JRL000/AQUABOTS/docs/AQUABOTS_PROJECT_SUMMARY.md

# AQUABOTS Project Summary — MOVED

The comprehensive project summary now lives at:

> [**`Claude/project-docs/AQUABOTS_PROJECT_SUMMARY.md`**](../Claude/project-docs/AQUABOTS_PROJECT_SUMMARY.md)

That file is the single source of truth for:

- Team structure and roles
- Communications architecture (IF-1 through IF-6) and current status
- Swarm firmware roadmap and module descriptions
- Power system configuration (production and demo)
- Sensor stack spec
- Updates since 02-25-2026 — swarm Steps 7–9 coded, IF-3 ESP32 side built, mission GUI deployed, JetPack 6.2 camera fix

This file was an older duplicate that had drifted out of date. Keeping only one copy so they can't diverge again.
