JRL000/AQUABOTS/docs/AQUABOTS ISR - COMMS SYSTEM.pptx

Communications System

Integration Status Review (ISR)

5/5

Comms Layers

Complete

✓

IF-6 (Drone↔Drone)

Verified

0%

Packet Loss

Complete

<5ms

RTT Latency

Complete

Notes: TALKING POINTS:
- Distributed swarm coordination for 20-50 autonomous surface drones
- ESP32-S3 with ESP-NOW protocol — zero-configuration networking
- All 5 communication layers complete and verified on hardware
- Interface IF-6 (drone-to-drone) fully verified — 0% packet loss, sub-5ms RTT
- Integration Phase 0 (interface specs) starting this week

TIME: 30 seconds

## Slide 2

Hardware Architecture & Status

ESP32-S3 Communication Hardware

ESP32-S3 Specifications

- MCU: Xtensa Dual-Core @ 240 MHz
- Radio: 2.4 GHz WiFi (ESP-NOW)
- Protocol: ESP-NOW (up to 250 kbps)
- Antenna: On-board PCB antenna
- Range: 30m+ indoor, 100m+ outdoor
- Power: 3.3V from distribution board
- UART: 0=Console, 1=Pixhawk, 2=Jetson

THE UNIVERSITY OF ARIZONA

Hardware Status

MCU selected & tested (ESP32-S3)

2-node communication verified

RSSI: -16 to -24 dBm at 1m

Multi-node setup (Phase 1, Wk 8)

Waterproof enclosure (Phase 3, Wk 12-13)

Timeline: Wk 8 → 3rd board + stub tests | Wk 10 → Pair tests | Wk 12 → Full system

AQUABOTS | ISR – Communications System

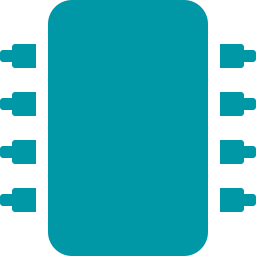
[picture p2: figure]
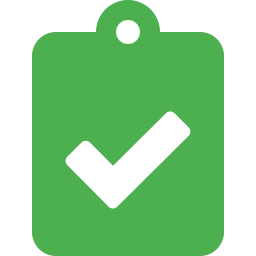
[picture p3: figure]
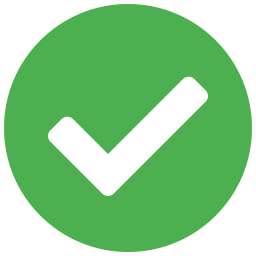
[picture p4: figure]
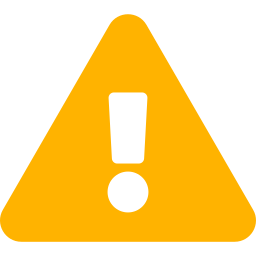
[picture p5: figure]
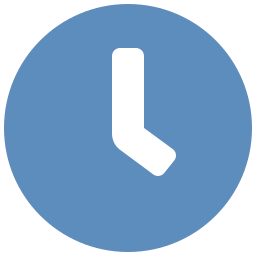
[picture p6: figure]

2

Notes: TALKING POINTS:
- ESP32-S3 selected for dual-core processing, built-in 2.4GHz WiFi
- ESP-NOW eliminates need for WiFi access point — direct peer-to-peer
- Currently verified on 2 development boards
- UART port allocation planned: UART0=console, UART1=Pixhawk (IF-1), UART2=Jetson (IF-3)
- 3rd dev board arriving Week 8 for multi-node and stub testing
- Waterproof enclosure integration during Phase 3 full system testing

TIME: 45 seconds

## Slide 3

Software Stack – Layers 1-5

All 5 communication layers complete and verified on hardware

GOTO, HOLD, STOP, RESUME — synchronized execution

Layer 5: Commands

Key Metrics

~2,350

Lines of Code

5 of 5

Modules

~10 KB

RAM Usage

~800 KB

Flash Usage

<5%

CPU Load

6 weeks

Dev Time

5

✓

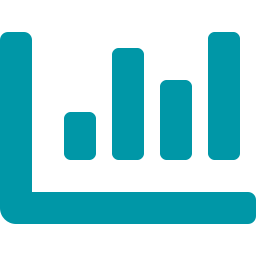
[picture p7: figure]

Leader election (highest ID) + TDMA scheduling (50ms slots)

4

Layer 4: Coordination

✓

HELLO/JOIN auto-discovery — 2-4 sec, 50-node capacity

3

Layer 3: Discovery

✓

NVS provisioning — persistent node IDs (1-254)

2

Layer 2: Identity

✓

ESP-NOW wrapper — 4-5ms RTT, 0% packet loss

1

Layer 1: Transport

✓

THE UNIVERSITY OF ARIZONA

AQUABOTS | ISR – Communications System

3

Notes: TALKING POINTS:
- All 5 communication layers complete — this is the full swarm comm stack
- Layer 1: ESP-NOW wrapper handles all radio communication
- Layer 2: Each drone gets a persistent unique ID via NVS flash
- Layer 3: Drones discover each other automatically — zero-config
- Layer 4: Highest ID drone becomes leader, generates TDMA schedule
- Layer 5: Leader distributes GOTO/HOLD/STOP/RESUME commands
- ~2,350 lines production-quality C code in ESP-IDF
- Very lightweight: <5% CPU, ~10KB RAM
- Note: These 5 layers implement IF-6 (drone↔drone) which is fully complete

TIME: 60 seconds

## Slide 4

SRVM Verification – Requirement 4.4.2

Inter-Drone Communication: PARTIAL PASS → Advancing to FULL PASS

Verification Method | Status | Evidence / Detail | Date
TEST | ✓ PASS | RTT <5ms | 0% loss | RSSI -16 to -24 dBm | Discovery <5s | Wk 6
DEMONSTRATION | ✓ PASS | 2-node swarm: auto-discovery, leader election, TDMA, cmd sync | Wk 6
ANALYSIS | ◐ In Progress | Scalability 2→50 nodes, traffic modeling, performance projections | Wk 9
INSPECTION | ○ Planned | Hardware inspection, antenna placement, enclosure RF check | Wk 12

- 4.1.2 Swarm Control — Demonstration: ✓ PASS (leader election, synchronized commands)
- 4.4.1 Autonomy & Control — Demonstration: ◐ PARTIAL (command execution OK, formation pending)
- 4.3.1 Survivability — Test: ✓ PASS (0% packet loss) | Analysis: Scheduled Wk 9

AQUABOTS | ISR – Communications System

Supporting Requirements

THE UNIVERSITY OF ARIZONA

4

Notes: TALKING POINTS:
- Requirement 4.4.2 currently at PARTIAL PASS, advancing to FULL PASS
- TEST: All metrics exceed requirements — RTT <5ms, 0% packet loss, excellent signal
- DEMONSTRATION: Full 2-node swarm demonstrated — discovery through command execution
- ANALYSIS: Scalability study scheduled during Spring Break buffer (Wk 9)
- INSPECTION: Hardware inspection during Phase 3 full system integration (Wk 12)
- Supporting requirements also on track

TIME: 60 seconds

## Slide 5

Live Demonstration

2-Node Swarm Communication — End-to-End Verification

Power On

Two ESP32-S3 boards powered up

Auto-Discovery

Nodes discover each other (2-4 sec)

Leader Election

Node 2 (highest ID) elected leader

1

2

3

TDMA Schedule

Leader generates 50ms time slots

4

Send Command

Leader sends: goto 100 200 90

5

Synchronized Exec

Both nodes receive & execute

6

Backup: Pre-recorded video + console screenshots available if live demo encounters issues

AQUABOTS | ISR – Communications System

THE UNIVERSITY OF ARIZONA

5

Notes: TALKING POINTS:
- Live demo: Watch two ESP32-S3 boards coordinate in real-time
- Power on → automatic discovery in 2-4 seconds
- Node 2 becomes leader (highest ID wins)
- Leader generates TDMA schedule — 50ms slots prevent collisions
- Leader sends GOTO command — both nodes receive and execute
- Console shows synchronized status on both boards
- Backup video ready if hardware has issues

TIME: 2 minutes for demo

## Slide 6

Software Integration Plan

5 Phases (0-4) — Integration-Maturity Model with Team Pairings

Phase 0: Interface Agreement

5 interface specs (IF-1 to IF-5); team sign-off by Feb 28

John's IF Ownership

- IF-1: Swarm ↔ Pixhawk (w/ Robert)
- IF-2: Sensors → ESP32 (w/ Jamie)
- IF-3: ESP32 ↔ Jetson (w/ Jamie)
- IF-5: GUI Cmds → Drone (w/ Mayra)
- IF-6: Drone ↔ Drone ✓ DONE

Wk 7

IN PROGRESS

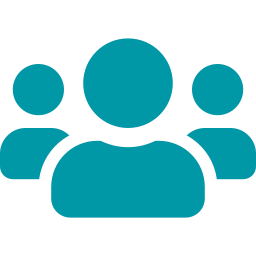
[picture p8: figure]

Phase 1: Pairwise Stub Testing

Each IF tested: one real side + one stub; Spring Break buffer Wk 9

Wk 8-9

Upcoming

Phase 2: Subsystem Pair Integration

Real HW connected in pairs — Swarm↔Pixhawk, Sensors↔ESP32, GUI↔Jetson

Wk 10-11

Planned

Phase 3: Full System Integration

All 4 subsystems running on complete drone; 2-drone swarm; E-STOP

Wk 12-13

Planned

Critical Path

IF-1: Swarm ↔ Pixhawk

- Two MCUs, two owners, real-time protocol
- Tested earliest; most schedule buffer
- MAVLink over UART — spec due Feb 26

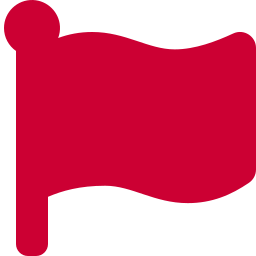
[picture p9: figure]

Phase 4: Pool Testing & Validation

Single-drone pool → multi-drone pool → full mission test

THE UNIVERSITY OF ARIZONA

Wk 14-15

Planned

AQUABOTS | ISR – Communications System

6

Notes: TALKING POINTS:
- Integration plan follows 5 phases (0-4) based on integration maturity, NOT subsystem breakdown
- Phase 0 (THIS WEEK): All 4 team members agree on interface specs — IF-1 through IF-5
- IF-6 (drone↔drone ESP-NOW) already complete and verified
- Phase 1 (Wk 8-9): Stub testing — each interface tested with one real side + one mock
- Spring Break (Wk 9) used as buffer
- Phase 2 (Wk 10-11): Real hardware pairs connected — Swarm↔Pixhawk is first (critical path)
- Phase 3 (Wk 12-13): Full system on complete drone, 2-drone swarm, E-STOP
- Phase 4 (Wk 14-15): Pool testing — single then multi-drone
- CRITICAL PATH: IF-1 (Swarm↔Pixhawk) — two MCUs, two team members, real-time MAVLink
- Must be tested earliest with most schedule buffer
- I own or co-own 5 of 6 interfaces (IF-1, 2, 3, 5, 6)

TIME: 60 seconds

## Slide 7

Testing & Validation Results

Verified Performance Metrics — Requirement 4.4.2

RTT Latency

4-5 ms

Req: <10 ms

Packet Loss

0%

Req: <5%

Signal Strength

-16 to -24 dBm

Req: >-70 dBm

Discovery Time

2-4 sec

Req: <5 sec

PASS

PASS

PASS

PASS

Test Case | Result | Detail
Auto-Discovery (2 nodes) | ✓ PASS | Both nodes discovered in 2-4 seconds
Leader Election | ✓ PASS | Highest node_id (Node 2) elected correctly
TDMA Scheduling | ✓ PASS | 50ms slots generated, beacon every 1s
Command Distribution | ✓ PASS | GOTO/HOLD/STOP/RESUME — <50ms latency
Leader Failover | ✓ PASS | Auto re-election in 5-7 sec after power-off
Thread Safety | ✓ PASS | Mutex protection, zero race conditions

AQUABOTS | ISR – Communications System

Functional Verification Results

THE UNIVERSITY OF ARIZONA

7

Notes: TALKING POINTS:
- All performance metrics EXCEED requirements
- RTT 4-5ms against <10ms plan requirement — well within threshold
- Packet loss is 0% — well below 5% requirement
- Signal strength -16 to -24 dBm — far exceeds -70 dBm minimum
- Discovery in 2-4 seconds — well under 5 second requirement
- All functional tests pass: discovery, election, scheduling, commands, failover
- Thread safety verified — no race conditions with mutex protection
- These metrics verified per Integration Plan Section 6.1

TIME: 45 seconds

## Slide 8

Master Integration Timeline

Integration Schedule and Key Milestones

Wk

Ph 0: IF Specs

NOW

7

8

BREAK

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
Ph 1: Stub Testing

Ph 2a: Swarm↔Pixhawk

Ph 2a: Sensors↔ESP32

Ph 2b: E2E Command

Ph 3a: Full Stack

Ph 3b: 2-Drone Swarm

Ph 4: Pool Testing

Finalize + Submit

In Progress

THE UNIVERSITY OF ARIZONA

John's Tasks

Critical Path (IF-1)

Pair/System Tests

AQUABOTS | ISR – Communications System

8

Notes: TALKING POINTS:
- Timeline matches Software Integration Plan Master Timeline (Section 10)
- Week 7 (NOW): Phase 0 — finalizing interface spec documents with all teammates
- IF1_SPEC.md (John+Robert), IF2_SPEC.md (Jamie+John), IF3_SPEC.md (John+Jamie)
- IF5_SPEC.md (Mayra+John) — team sign-off meeting Feb 28
- Week 8: Phase 1 — pairwise stub testing — each interface one real side + one stub
- Week 9: Spring Break — buffer for async catch-up
- Week 10: Phase 2a — CRITICAL: Swarm↔Pixhawk pair test (John+Robert)
- ESP32 goto → Pixhawk motor spins, rudder deflects, ACK received
- Week 11: Phase 2b — End-to-end command chain: GUI→MQTT→Jetson→ESP32→Pixhawk
- Weeks 12-13: Phase 3 — Full system on drone, then 2-drone swarm + E-STOP
- Weeks 14-15: Phase 4 — Pool testing (single then multi-drone)
- Weeks 16-17: Finalize documentation and submit

TIME: 45 seconds

## Slide 9

Next 30 / 60 / 90 Day Plan

Milestones, Deliverables, and Integration Targets Through May

30 Days

Feb 24 – Mar 27

- Wk 7: IF-1, IF-2, IF-3, IF-5 specs agreed
- Wk 7: Team sign-off meeting (Feb 28)
- Wk 8: ESP32 sends MAVLink GOTO/STOP (1.1)
- Wk 8: ESP32 reads sensor structs (1.4)
- Wk 8: ESP32↔Jetson serial packets (1.8)
- Wk 9: Spring Break buffer / catch-up
- Wk 10: Swarm↔Pixhawk pair test (2.1)
- Wk 10: Live sensor flow into ESP32 (2.2)
- Wk 11: E2E cmd: GUI→ESP32→Pixhawk (2.4)
- Wk 11: 2-drone swarm + Pixhawk (2.5)

THE UNIVERSITY OF ARIZONA

60 Days

Mar 27 – Apr 24

- Wk 12: Single-drone full stack (3.1)
- Wk 13: 2-drone swarm full system (3.2)
- Wk 13: Sensor readings during motion (3.3)
- Wk 13: E-STOP verified < 2 sec (3.4)
- Wk 13: Starlink loss → auto HOLD (3.5)
- Wk 14: Single-drone pool test (4.1)
- Wk 15: Multi-drone pool test (4.2)
- Wk 15: Full mission validation (4.3)

AQUABOTS | ISR – Communications System

90 Days

Apr 24 – May 7

- Wk 16: Manual & documentation
- Wk 16: Design Day preparation
- Wk 17: Final report submission
- Performance optimization
- Integration test reports finalized

10

Notes: TALKING POINTS:
- 30 Days: Focus on Phase 0-2 — interface specs, stub testing, pair integration
- THIS WEEK: All interface specs agreed — IF-1 through IF-5
- Week 8: Stub testing — ESP32 sends MAVLink, reads sensors, talks to Jetson
- Week 10: CRITICAL — Swarm↔Pixhawk pair test with Robert
- Week 11: End-to-end command chain verified
- 60 Days: Phase 3-4 — Full system and pool testing
- Single-drone full stack, then 2-drone swarm
- E-STOP verified, Starlink loss graceful degradation
- Pool testing: single then multi-drone missions
- 90 Days: Finalize — documentation, Design Day, final report
- Task numbers (e.g., 1.1, 2.1) reference Integration Plan directly

TIME: 45 seconds

## Slide 10

Risk Assessment & Mitigation

From Software Integration Plan — Risk Register (Section 8)

Risk | Prob | Impact | Mitigation | Owner
R1: MAVLink format mismatch ESP32↔Pixhawk | Med | High | Spec in Phase 0; logic analyzer in Phase 1 | John+Robert
R2: Starlink latency too high for control | Low | Med | Critical control via ESP-NOW; Starlink for telemetry | Mayra+John
R3: Sensor noise during motor vibration | Med | Med | Test during operation Phase 3; add filtering | Jamie
R5: UART port contention on ESP32 | Med | Med | UART0=console, 1=Pixhawk, 2=Jetson; verify early | John
R6: Spring Break schedule slip | High | Med | Front-load Phase 1 critical tasks to Week 8 | ALL
R7: Waterproofing failure | Med | High | Bench-test all integration before pool; conformal coat | ALL
R8: Pixhawk firmware incompatibility | Low | High | Verify firmware + MAVLink v2 in Phase 0 | Robert

Completed Mitigations

- IF-6 protocol reliability: 0% packet loss verified
- Auto-discovery, leader election, thread safety: all verified

THE UNIVERSITY OF ARIZONA

Highest Priority

- R1: MAVLink mismatch — spec due Feb 26
- R6: Spring Break — front-loading Week 8 work

AQUABOTS | ISR – Communications System

9

Notes: TALKING POINTS:
- Risks pulled directly from Software Integration Plan Section 8
- R1 (MAVLink mismatch) is highest priority — on critical path
- Mitigation: formal spec document due Feb 26, logic analyzer verification in Phase 1
- R5 (UART contention) is my responsibility — already planned allocation
- R6 (Spring Break slip) mitigated by front-loading Phase 1 tasks to Week 8
- IF-6 risks already mitigated — proven 0% packet loss, working auto-discovery
- R7 (waterproofing) — all integration bench-tested before going to pool

TIME: 45 seconds
