JRL000/AQUABOTS/docs/AQUABOTS CDR .pdf

# AQUABOTS Aeropak

# Critical Design Review

# Team 26061

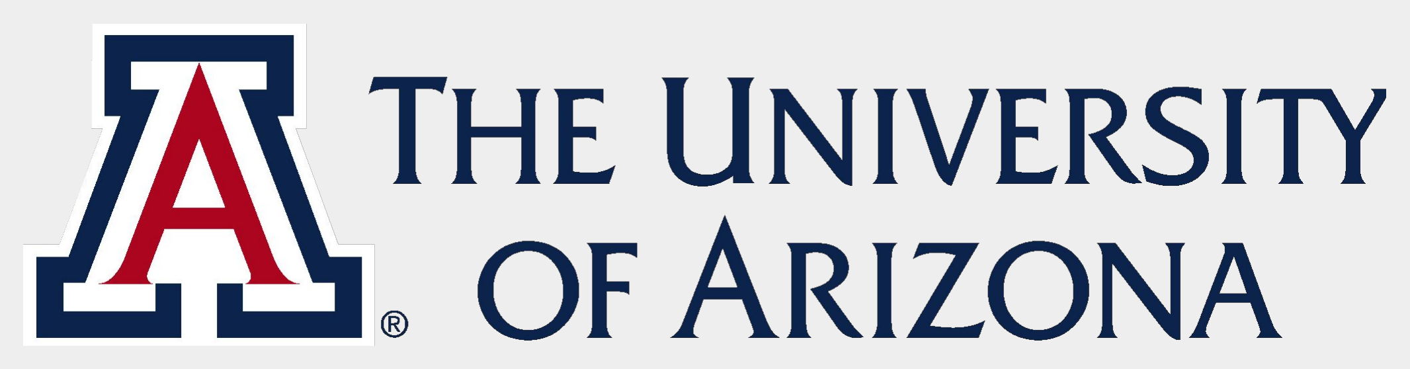
[picture p10: figure]

# Overview

### 1.0 Introduction

### 2.0 System Requirements

### 3.0 Point Design

### 4.0 Performance Analyses and

Expectations

### 5.0 Verification

### 6.0 Risk Analysis

### 7.0 Project Status and Plan

### 8.0 CDE 1

### 9.0 CDE 2

### 10.0 Cost Analysis and Deliverables

### 11.0 Summary

# Introduction

- Jamie Ledbetter, Biosystems Engineering – Team Lead
- Robert Wilkie, Aerospace Engineering – Procurement Lead
- Alex Imrich, Aerospace Engineering
- John Lopez, Electrical Engineering
- Mayra Mendoza, Optical Engineering
- Kama Henriques, Mechanical Engineering

# Our Team

# Project Summary

## What makes AQUABOT different?

- Rapid-response
- Short-term, targeted missions
- Swarm control capabilities
- Scalable

## Key Features:

- Mounted and fully functional sensor/camera suite
- Further developed communications
- Easy Integration with other water vessels

Sponsors: Dr. Marvin Slepian, Eddy Stocker

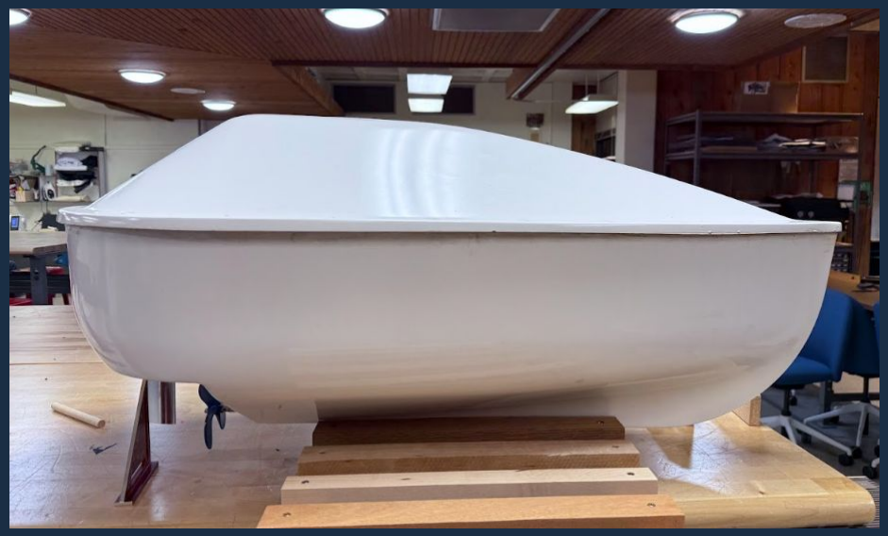
[picture p11: figure]

Image of AQUABOT Hull

## Application:

# Project Summary: OV-1

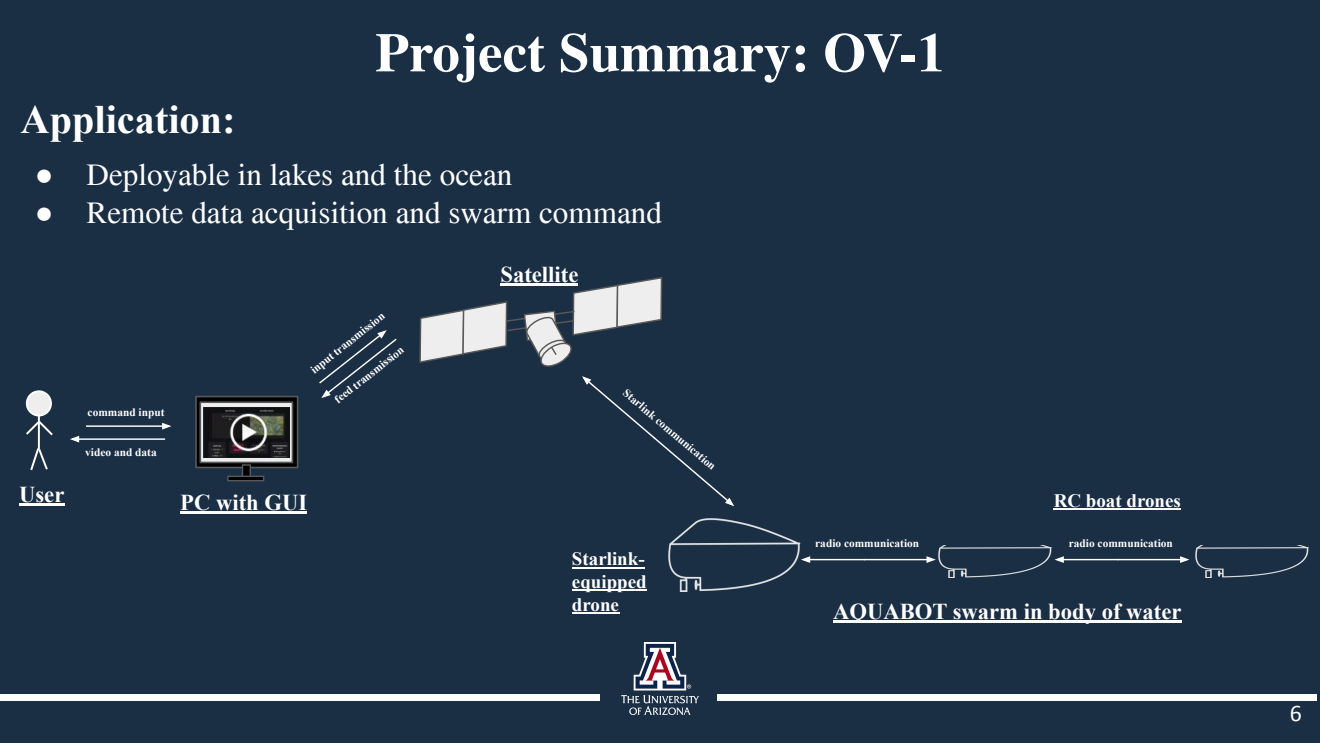
[picture p12: page 6]
User; command input; input transmission; feed transmission; Satellite; Starlink communication; radio communication; Starlink- equipped drone

● Deployable in lakes and the ocean
● Remote data acquisition and swarm command

video and data

PC with GUI

RC boat drones

AQUABOT swarm in body of water

# PDR Action Items

## Action Items

1. Add a system requirement for drone to drone
communication
2. Add a system requirement for swarm control
3. Update SBD
4. Generate a weight analysis
5. Define/resolve deployment system approach with your
sponsor

## Action Taken

1. Created Requirement 5.4.2 for inter-drone communication up to 100m
2. Created Requirement 5.4.6 for coordinated drone swarm behavior with a leader-follower model at < 1 s latency
3. Updates made to SBD:
a. Modification to reflect finalized motor and prop layout
b. Removal of in-drone E-stop and Master Switch
4. Weight Analysis conducted to find total drone mass of ~37 kg
5. Team negotiation and discussion with sponsors resulted in a change of focus from deployment system to swarm demonstration
All Action Items Closed

# Major Post-PDR Changes

- Deployment system is no longer within the scope of the project
- Shift of project focus to showcasing swarm behavior and control
- At least three drones must be deployed
- Requirements including speed, battery life, and internal volume have been altered

to include a threshold value and objective value

# System Requirements

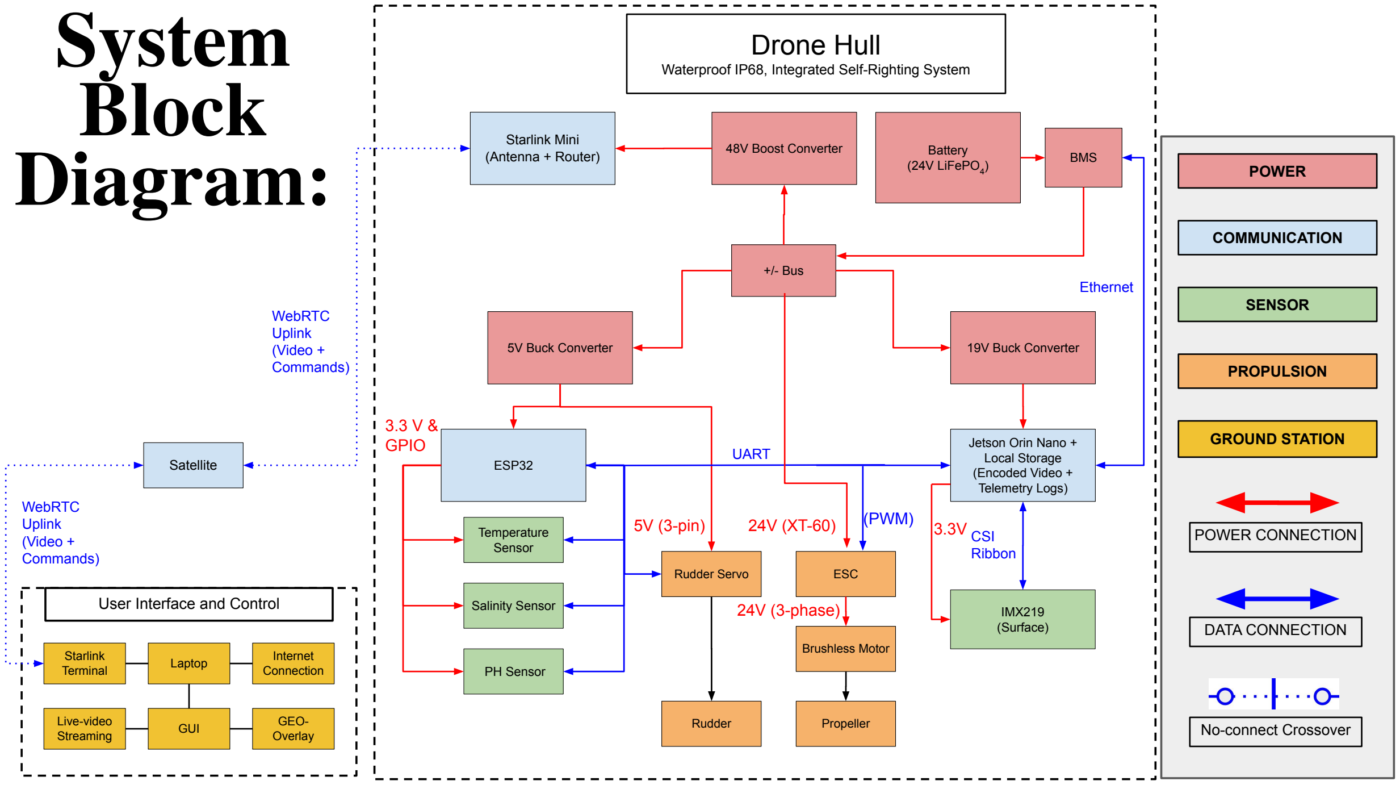
[picture p13: figure]
System Block Diagram:; Drone Hull; Waterproof IP68, Integrated Self-Righting System; PH Sensor; Salinity Sensor; Temperature Sensor; IMX219 (Surface); Jetson Orin Nano + Local Storage (Encoded Video + Telemetry Logs); Starlink Mini (Antenna + Router); Satellite; Brushless Motor; Propeller; ESC; Battery (24V LiFePO4 ); ESP32; +/- Bus; 5V Buck Converter; 19V Buck Converter; 48V Boost Converter; POWER; COMMUNICATION; SENSOR; PROPULSION; GROUND STATION; POWER CONNECTION; DATA CONNECTION; User Interface and Control; Laptop; GUI; Starlink Terminal; Internet Connection; Live-video Streaming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

# System

# Block

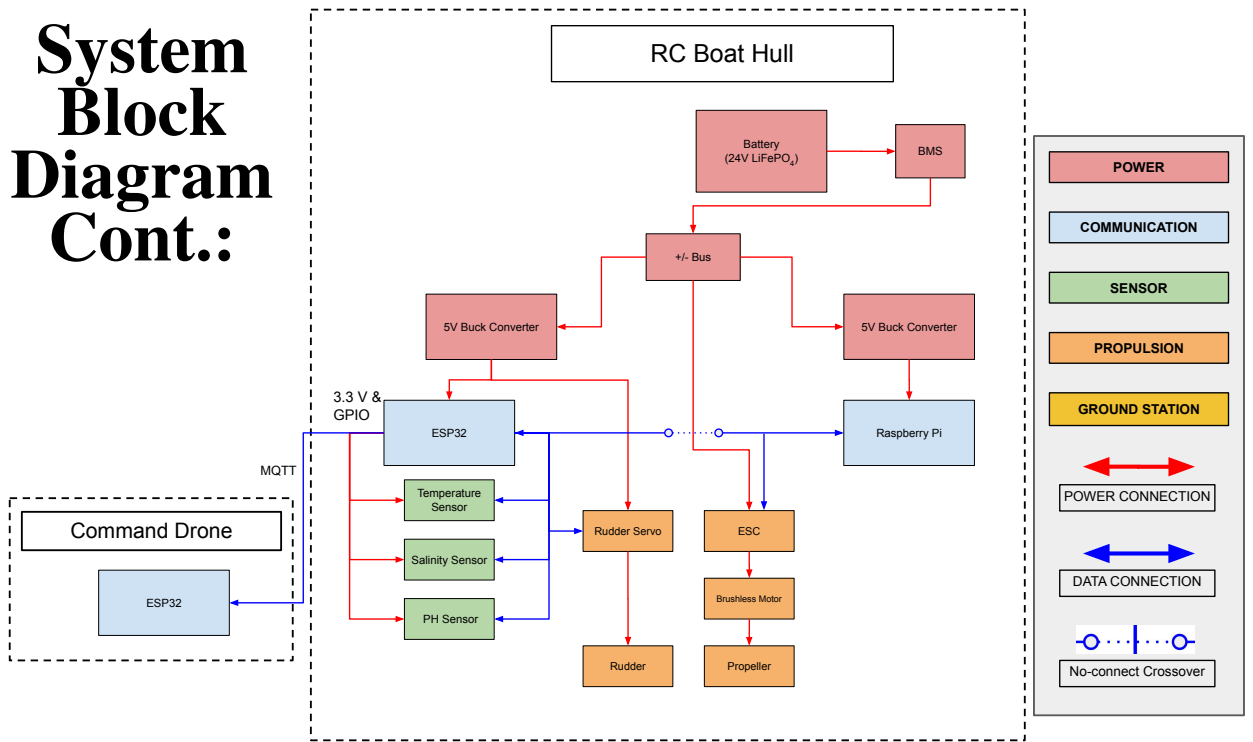
[picture p14: page 11]
Diagram Cont.:; PH Sensor; Salinity Sensor; Temperature Sensor; Brushless Motor; Propeller; ESC; Battery (24V LiFePO4 ); ESP32; +/- Bus; 5V Buck Converter; POWER; COMMUNICATION; SENSOR; PROPULSION; GROUND STATION; POWER CONNECTION; DATA CONNECTION; Rudder Servo; Rudder; No-connect Crossover; BMS; Command Drone; Raspberry Pi; MQTT; 3.3 V & GPIO

RC Boat Hull

# System Architecture

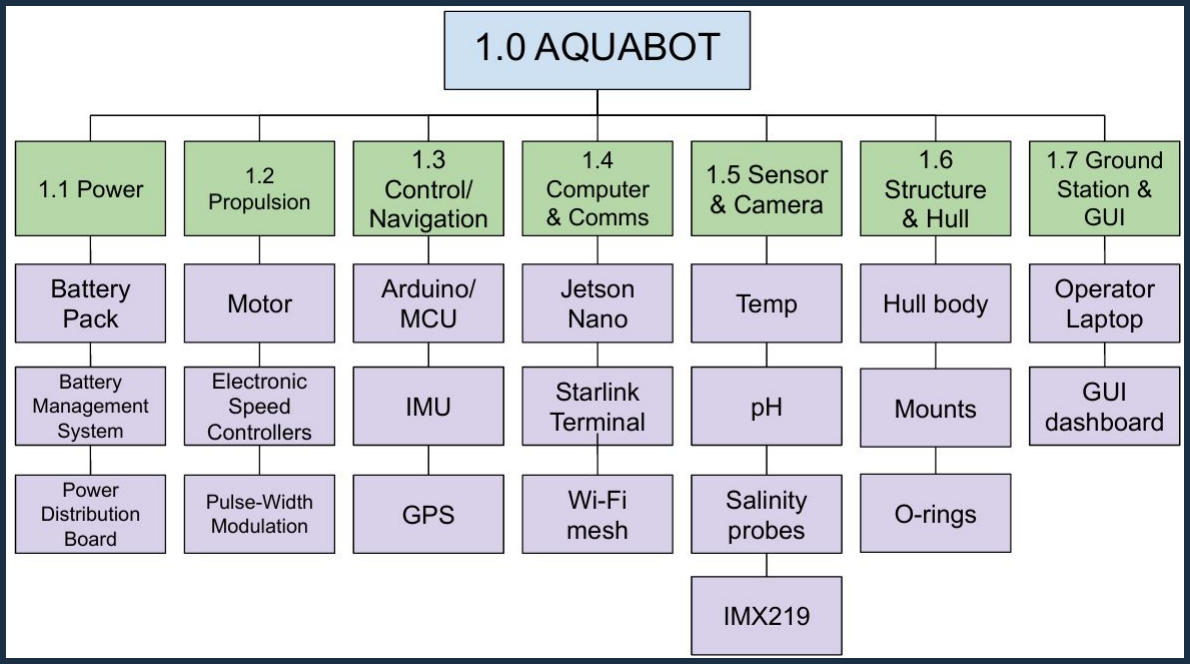
[picture p15: figure]

# Key Performance Requirements

- Swarm Deployment: All drones shall autonomously self-right and enter operational state within 60s of impact.
- Stability: Each drone shall self-right and maintain operational orientation IAW UNE-EN ISO 12217-3:2022 and/or ASTM F3052-14(2020)e1.
- Speed: Each drone shall be able to sustain a threshold speed of 2.5 kts in calm water conditions, with an objective speed of 5 kts.
- Battery Life: Each drone shall reach a threshold runtime of 6 minutes at nominal load, with an objective value of 5 hours.
- Data Collection: Each drone shall measure temperature, salinity, pH and capture visual imagery at a minimum of 1080p resolution, 30 fps.
- Data Mapping: Each drone shall generate a georeferenced map of collected environmental variables and export data in GIS-compatible format.

Requirement Type | Requirement | Verification Method
Test | Analysis | Demonstration | Inspection
| 4.1.2 Swarm Control | | | X
| 4.1.3 Stability | X | | X
| 4.1.4 Speed | X
| 4.1.5 Battery Life | X | X
| 4.1.6 Data Collection | X | | X
| 4.1.7 Data Mapping | | X
4.2 Design Requirements | 4.2.1 Hull Shape | | X
| 4.2.2 Internal Volume | | PASS | | PASS
| 4.2.3 Materials | | | | X
| 4.2.4 Payload Mounts | | | X | X

### 4.1 Performance

Requirements

# System Requirements Verification Matrix (SRVM)

Requirement Type | Requirement | Verification Method
Test | Analysis | Demonstration | Inspection
| 4.3.1 Survivability | X | X
| 4.3.2 Waterproofing | X | | | X
| 4.3.3 Operating temperature | X | X
| 4.3.4 Non-Hazardous Surface | | | | PASS
4.4 Interface Requirements | 4.4.1 Autonomy & Control | | | PARTIAL PASS
| 4.4.2 Inter-Drone Communication | PARTIAL PASS | | X
| 4.4.4 Satellite Uplink | PASS | | PASS
| 4.4.5 Display | | | PARTIAL PASS | PASS

### 4.3 Environmental

Requirement

SRVM Cont.

# Point Design

### Assembly Drawing

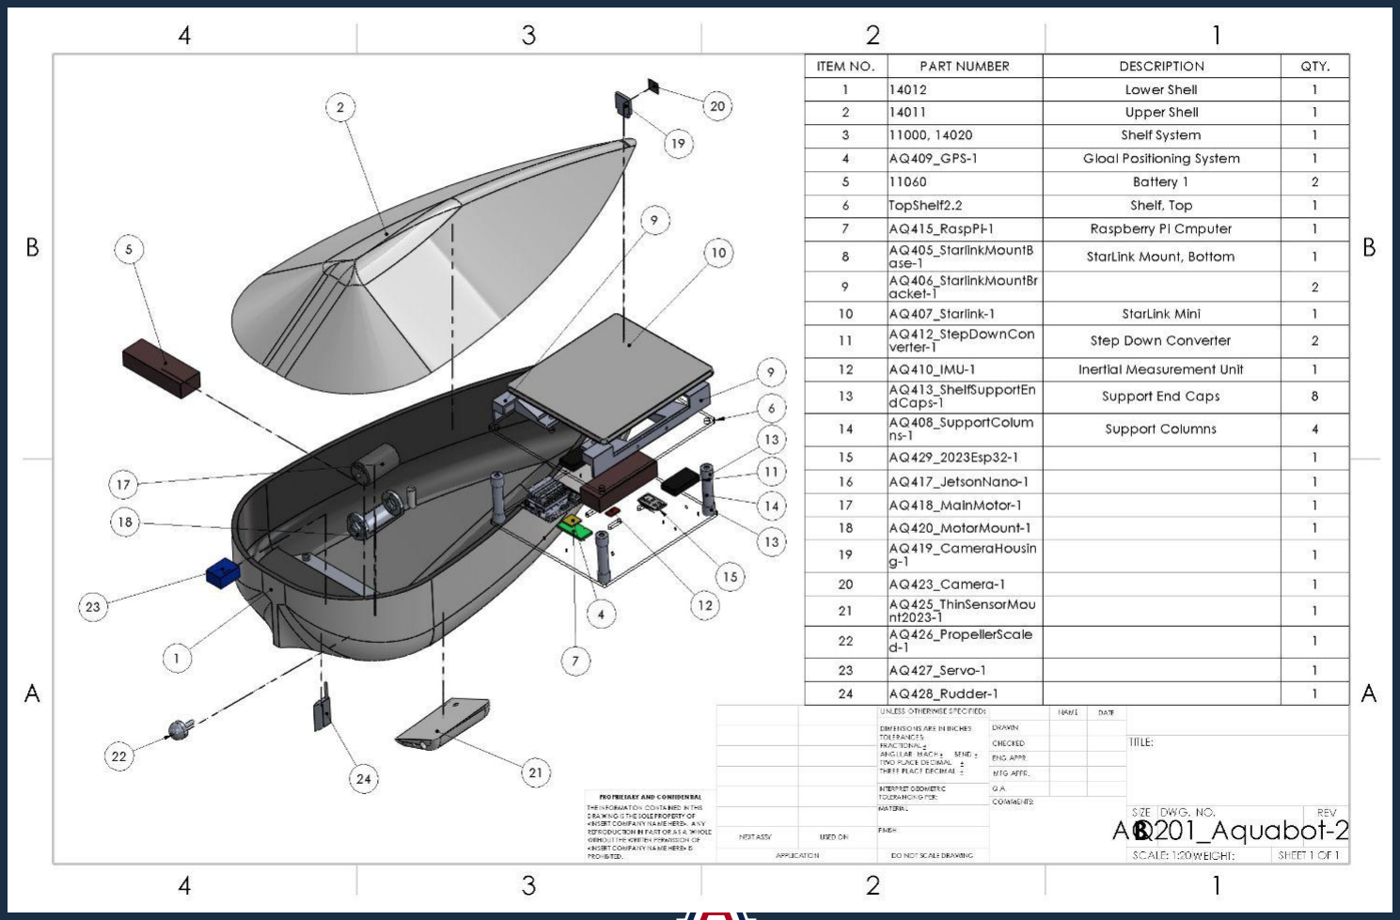
[picture p16: figure]

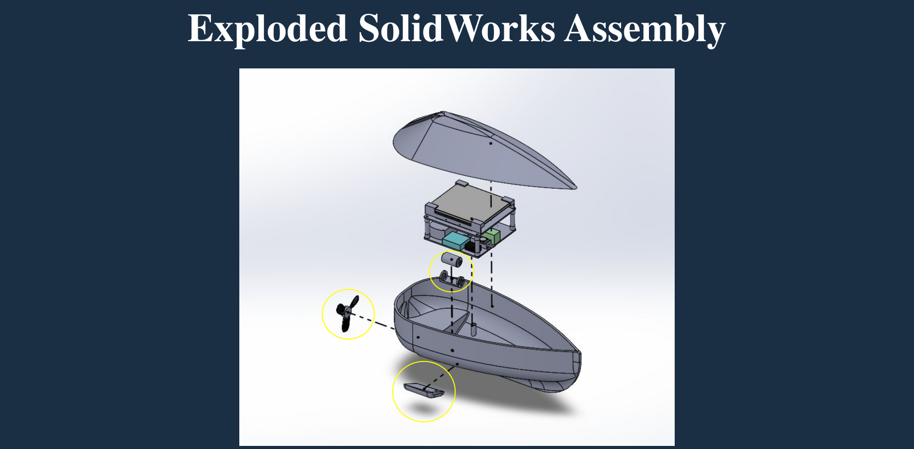
[picture p17: figure]
Exploded SolidWorks Assembly
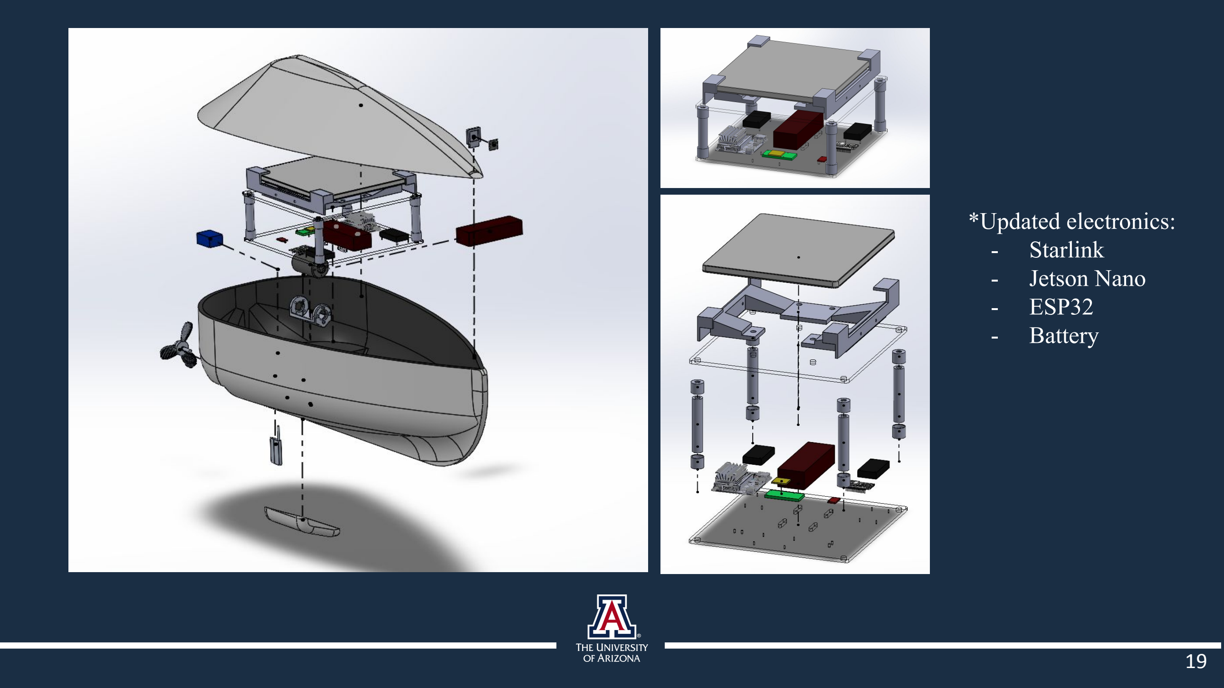
[picture p18: page 19]

*Updated electronics:
- Starlink
- Jetson Nano
- ESP32
- Battery

# Exploded SolidWorks Assembly

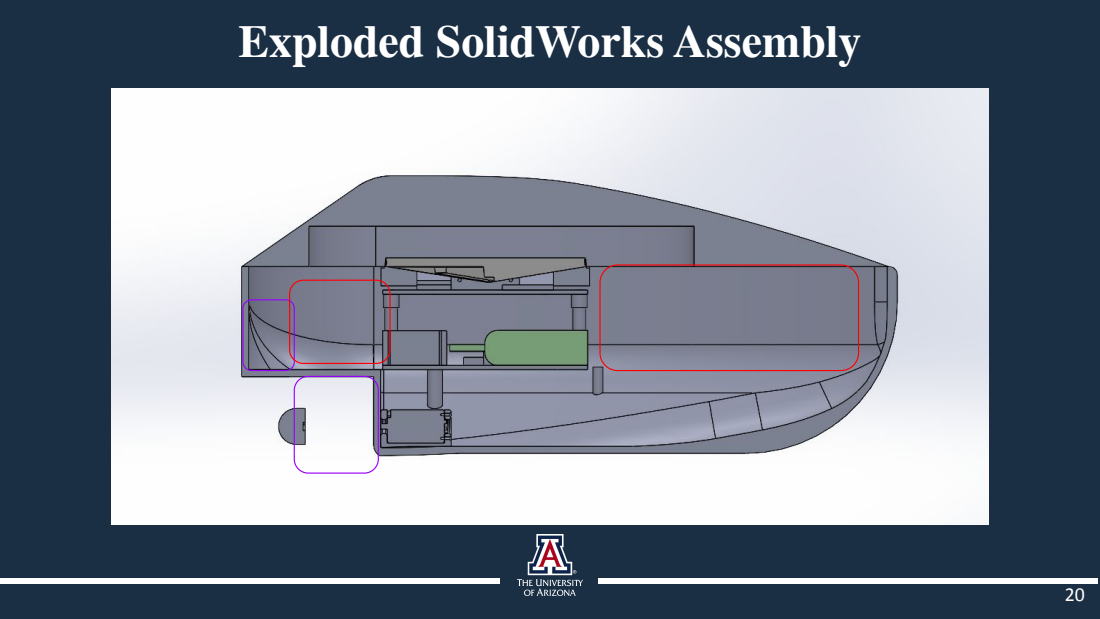
[picture p19: page 20]

# Parts Guide for CAD

Part Number | Part Name | Rev Number | Status
1 | CompletePart | 1 | Complete
2 | WIPPart | 1 | WIP
3 | ObsoletePart | 1 | OBS
4 | To-DoPart | 1 | To-Do
201 | Aquabot | 1 | Complete
202 | ShelfAssem | 1 | Complete
203 | StarlinkMount | 1 | Complete
401 | BottomShell | 1 | Complete
402 | TopShell | 1 | Complete
403 | BottomShelf | 1 | Complete
404 | TopShelf | 1 | Complete
405 | StarlinkMountBase | 1 | Complete
406 | StarlinkMountBracket | 1 | Complete
407 | Starlink | 1 | Complete
408 | SupportColumns | 1 | Complete
Part Number | Part Name | Rev Number | Status
409 | GPS | 1 | Complete
410 | IMU | 1 | Complete
411 | VerticalSupports | 1 | Complete
412 | StepDownConverter | 1 | Complete
413 | ShelfSupportEndCaps | 1 | Complete
414 | ShelfSpacer | 1 | Complete
415 | RaspPi | 1 | Complete
416 | LiPO | 1 | Complete
417 | JetsonNano | 1 | Complete
418 | MainMotor | 1 | Complete
419 | CameraHousing | 2 | Complete
420 | MotorMount | 1 | Complete
421 | Battery | 1 | Complete
422 | RCMiniPiMount | 1 | Complete
501 | GoPro | 1 | OBS

# Software Subsystem

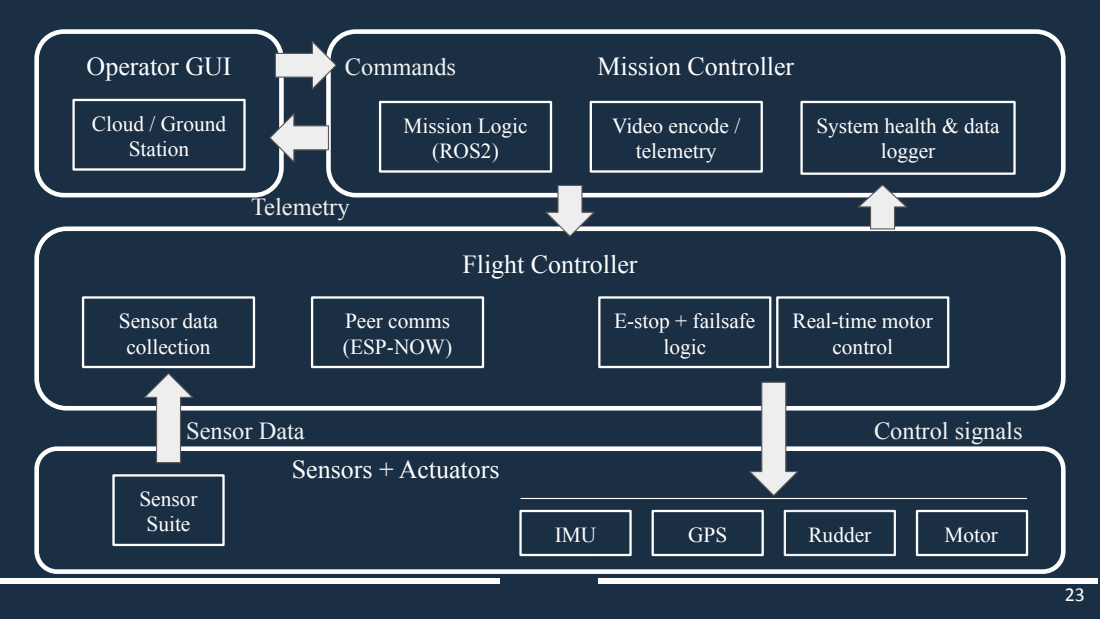
[picture p20: page 23]
Operator GUI; Mission Controller; Flight Controller; Cloud / Ground Station; Mission Logic (ROS2); Video encode / telemetry; logger; Sensor data collection; E-stop + failsafe logic; Peer comms (ESP-NOW); IMU; GPS; Rudder; Motor; Control signals; Sensor Suite; Sensor Data; Sensors + Actuators; Telemetry; Commands

System health & data

Real-time motor
control

# Swarm Architecture

Decentralized Mesh Network (Communication)

- Protocol: ESP-NOW (IEEE 802.11 Action Frames). Operates at Layer 2 (MAC) for connectionless, router-free communication.
- "Any-to-Any" Routing: Implements a custom Flooding Algorithm with TTL=3 (Time-To-Live).
- Logic: Packets are re-broadcast by neighbor drones, creating dynamic relay paths if the direct Line-of-Sight is blocked by waves.
- Performance Verification:
- Latency: < 10 ms (Verified). This is 10x faster than the system reaction time requirement, enabling real-time collision avoidance.
- Throughput: 50 packets/sec verified (Sufficient for 10 Hz control loop).

Content Block 2: Formation & Control Logic (Autonomy)

- Strategy: "Virtual Rigid Body". The swarm treats the Leader as the origin point (0,0) and moves as a single fixed coordinate frame.
- Position Algorithm:
- Follower derives target using:
- | (Where | is the Leader's heading rotation matrix).
- Control Loop:
- PID Controller: Drives motor thrust to zero out the Distance_Error.
- Failsafe: If data age > 3.0s, logic switches to "Station Keep" (Hold GPS Position) until
| the mesh heels.

Global Waypoint
(Starlink)

Leader Drone Receives
Waypoint

Broadcast via ESP-NOW
[GPS, Heading, Speed]

Follower Drone Calculates
Target (Leader_pos +
Offset_Vector)

PID Controller
(Drives motors to minimize error)

# Power Subsystem

# Block Diagram

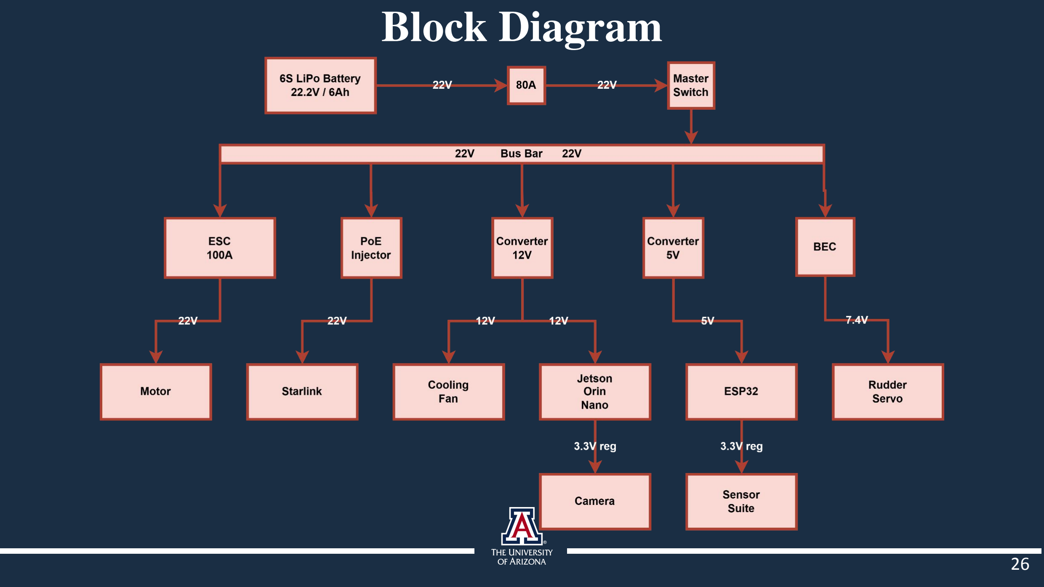
[picture p21: page 26]

# Wiring Diagram

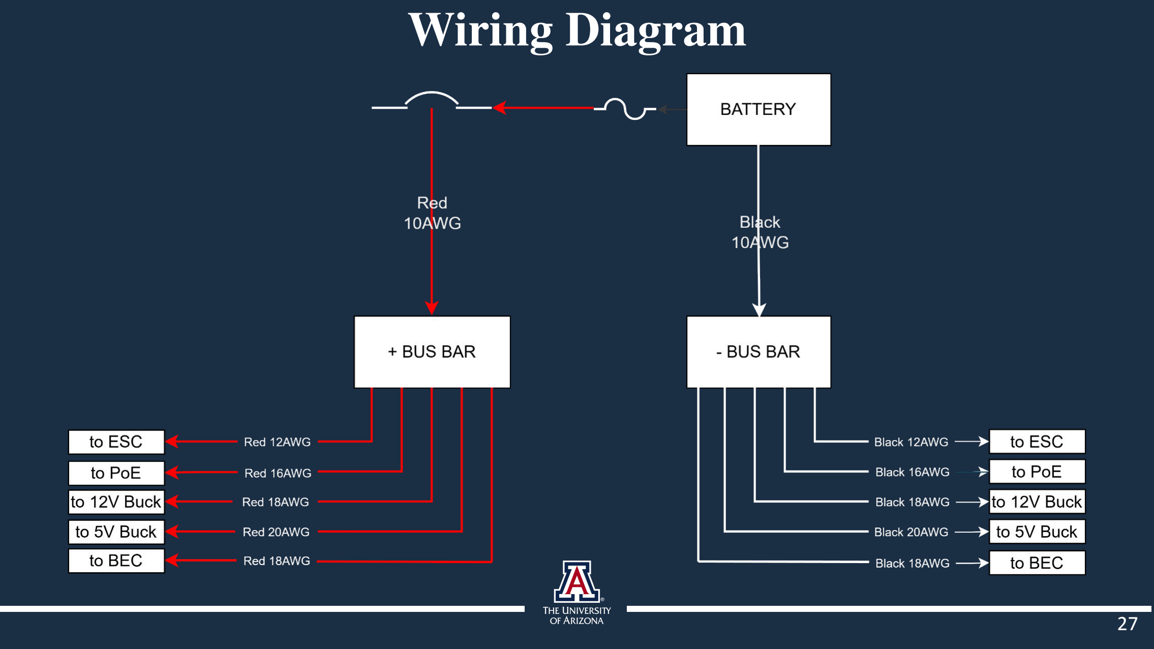
[picture p22: page 27]

# Power Budget

Subsystem | Component | Voltage Rail | Max Power (Load) | Efficiency Loss | Total Power (from Battery) | Max Current (from Battery) | Cruise Power (from Battery)
Subsystem | Component | Voltage Rail | Max Power (Load) | Efficiency Loss | Total Power (from Battery) | Max Current (from Battery) | Cruise Power (from Battery)
Propulsion | Apisqueen 5080 Motor | 22.2 V | 1200 W | 0 W (Direct) | 1200.0 W | 54.0 A | 60.0 W
Comms | Starlink Gen 3 (via Yaosheng) | 57 V | 100 W | ~5 W (95%) | 105.0 W | 4.7 A | 70.0 W
Compute | Jetson Orin Nano + Fan | 12 V | 25 W | ~3 W (90%) | 28.0 W | 1.3 A | 15.0 W
Control | ESP32 + Rudder Servo | 5V / 7.4V | 20 W | ~2 W (90%) | 22.0 W | 1.0 A | 5.0 W
Payload | Sensors (GPS, IMU, Env) | 3.3 V | 5 W | ~1 W (85%) | 6.0 W | 0.3 A | 5.0 W
TOTALS | | | 1350 W | | ~1361 W | ~61.3 A | ~155 W
Battery Capacity: | Ovonic 6S LiPo (22.2V, 6000mAh) = 133.2 Wh
Cruise Endurance: | 133.2 Wh / 155 W ≅ 0.85 Hours (51 Minutes)
Safety Margin: | Max draw is 61.3A, well within the 80A main fuse and the battery's 120C (720A) discharge limit.

# Communication Subsystem

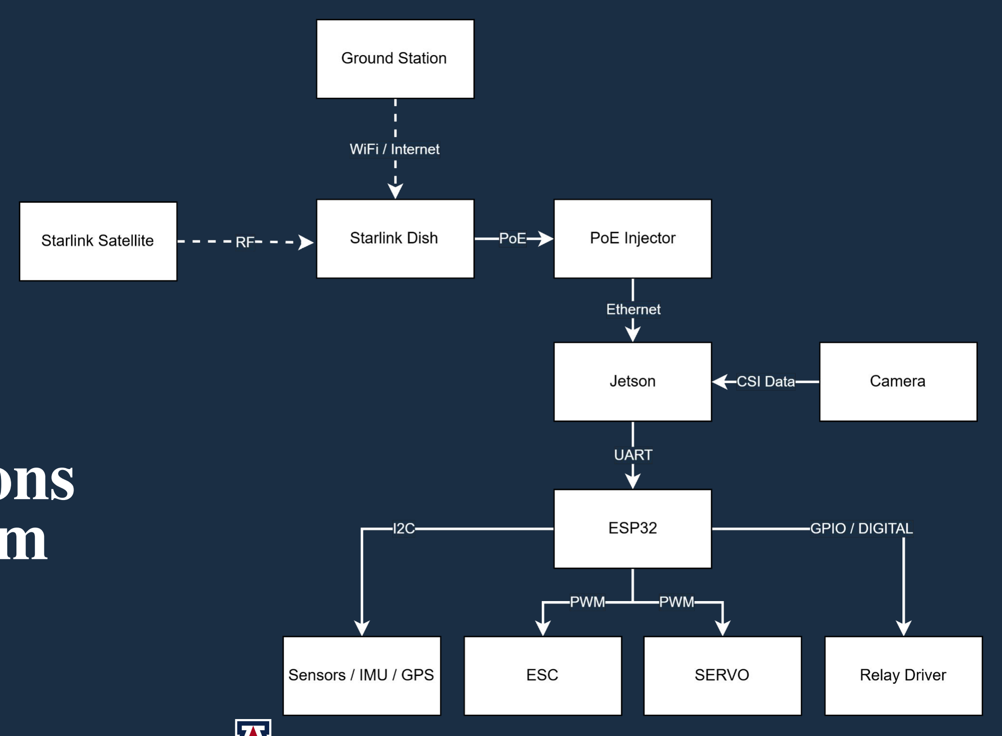
[picture p23: figure]

# Communications Block Diagram

# Gateway and Swarm Topology

Hybrid Star-Mesh will utilize a "Gateway & Swarm" architecture to minimize cost while maximizing range.

Feature | Main Drone (Gateway) | Follower Drones (Swarm)
Role | Central Hub & Internet Bridge | Data Collection Node
Uplink | Starlink (Marine Terminal) | None (Relays to Main)
Local Link | ESP-NOW (Rx/Tx) | ESP-NOW (Tx to Main)
Hardware | Jetson Nano + ESP32 | Raspberry Pi + ESP32
Data Flow | Aggregates all swarm data → Cloud | Sensors →Main Drone

Ground
Station

Starlink
Satellite

Starlink

Jetson

ESP32

Sensors

Raspberry
Pi

ESP32

# Wiring Diagram

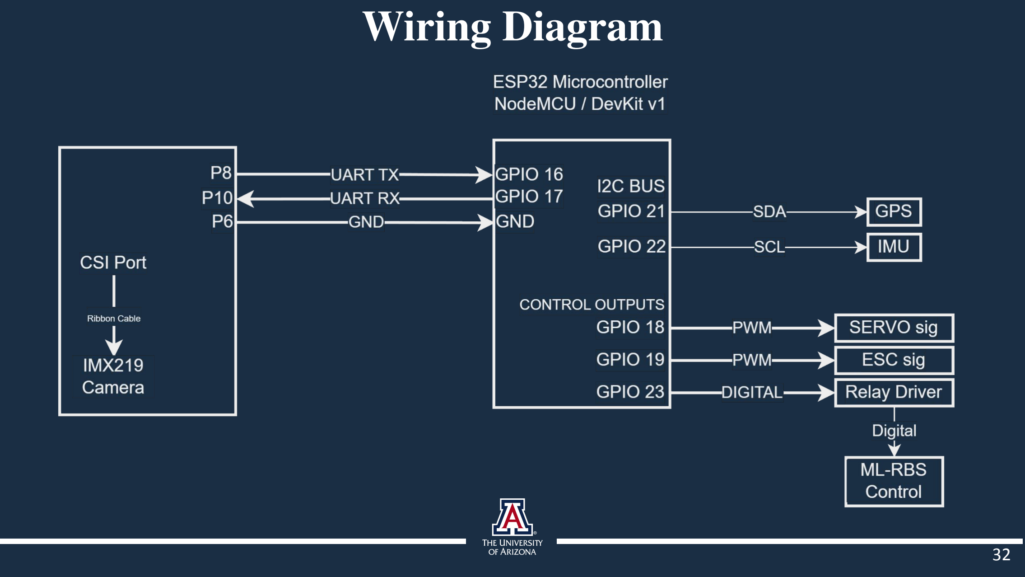
[picture p24: page 32]

# Performance & Bandwidth Analysis

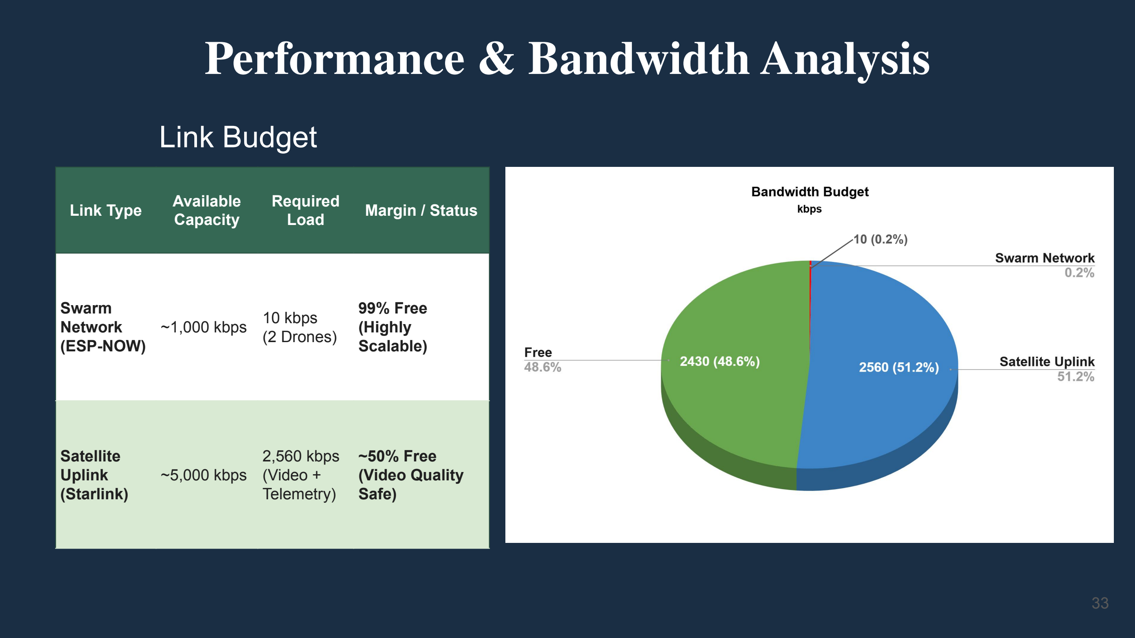
[picture p25: page 33]

Link Type | Available Capacity | Required Load | Margin / Status
Swarm Network (ESP-NOW) | ~1,000 kbps | 10 kbps (2 Drones) | 99% Free (Highly Scalable)
Satellite Uplink (Starlink) | ~5,000 kbps | 2,560 kbps (Video + Telemetry) | ~50% Free (Video Quality Safe)

### Link Budget

10 (0.2%)

# Data Protocol & Latency

- Protocol Stack Definition We utilize distinct protocols for the local swarm versus the global uplink to optimize for speed and reliability.
- Swarm Link: ESP-NOW
- Video Uplink: WebRTC
- Telemetry: MQTT
- Data Payload (The Packet)
- Format: Packed Binary Struct (64 Bytes).
- Content: [Nav Data] +
[Sensor Readings] + [Battery Status].
- Efficiency: 10x smaller than standard JSON, reducing
airtime collision risk.

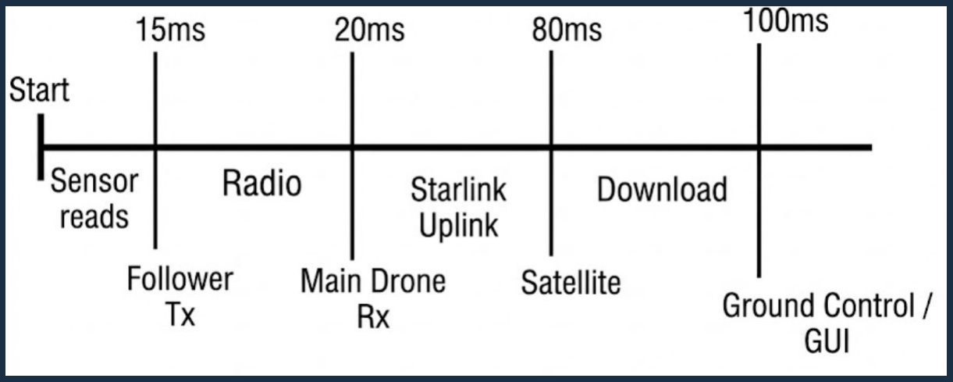
[picture p26: figure]

# Propulsion Subsystem

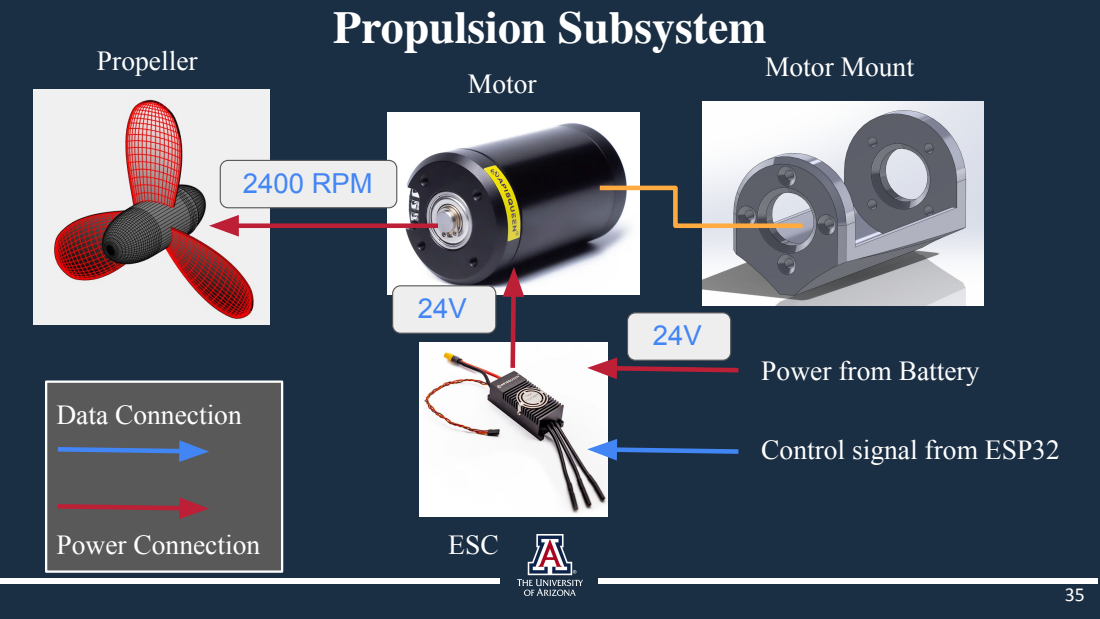
[picture p27: page 35]
2400 RPM; Propeller; Motor; Motor Mount; ESC; Data Connection; Power Connection

Power from Battery

Control signal from ESP32

# RC Drone Specifications

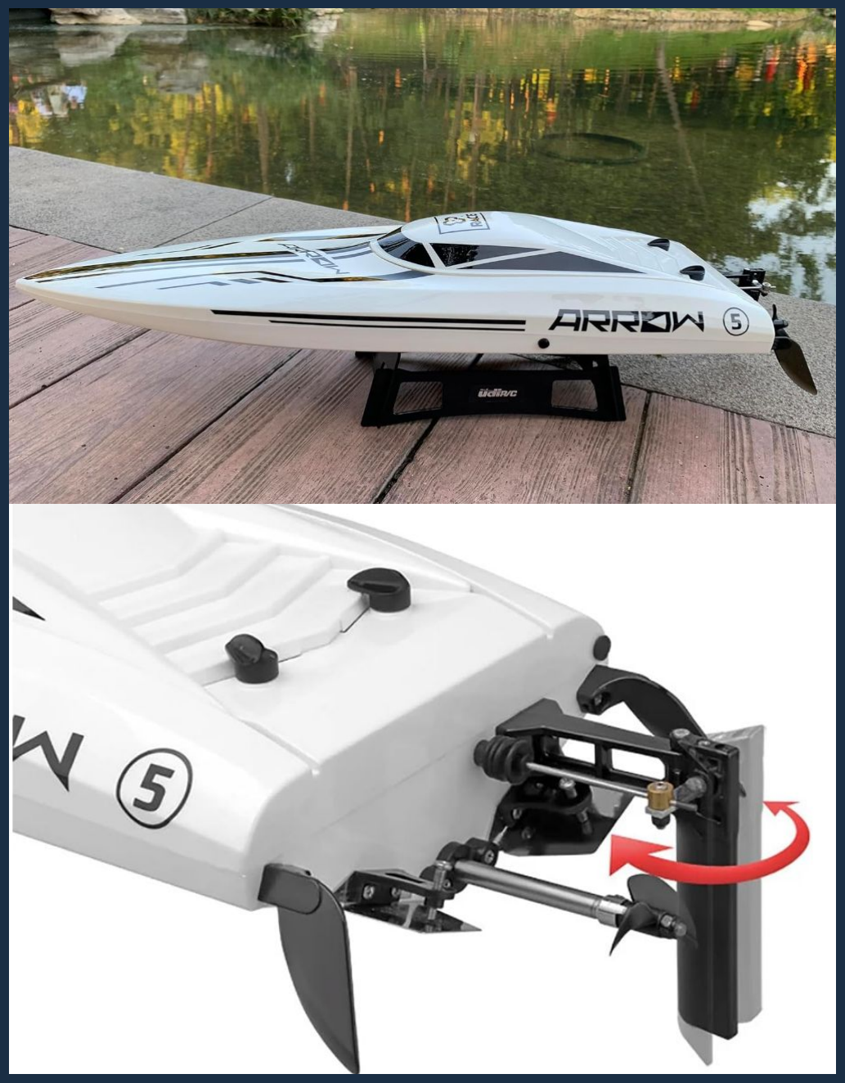
[picture p28: figure]

Key Features:

- Can hold ESP32 and Jetson Nano for data transmission
- Reaches 45 km/h
- Waterproof
- Brushless Motor
- Watercooled System
- 190 min charging time
- 7 minute run time

Notes:

Used purely to demonstrate swarm abilities. $1700 cheaper than using 2025 hull

Images from
https://www.amazon.com/-/es/Ssccgym-UDI005-escobillas-funciones-completas/dp/B0DRNNY597

# GUI with Sensor Data and Live Footage

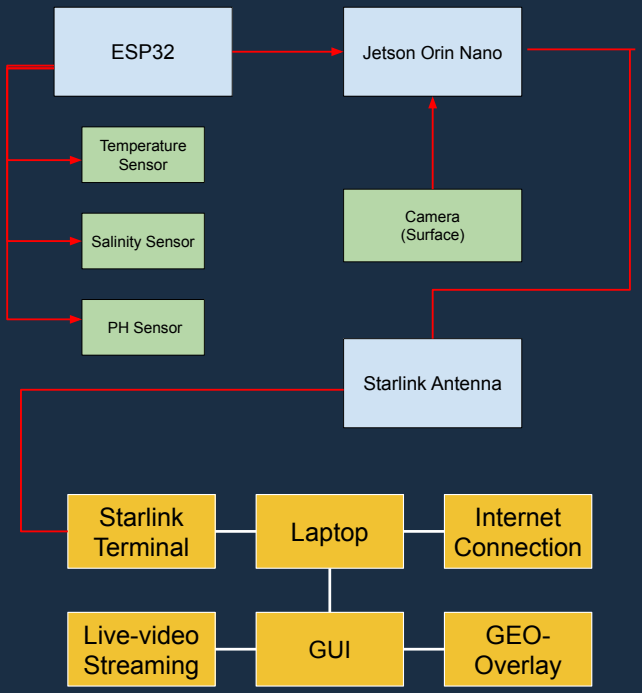
[picture p29: figure]
ESP32; Temperature Sensor; Salinity Sensor; PH Sensor; Jetson Orin Nano; Camera (Surface); Starlink Antenna; Laptop; GUI; Starlink Terminal; Internet Connection; Live-video Streaming; GEO- Overlay
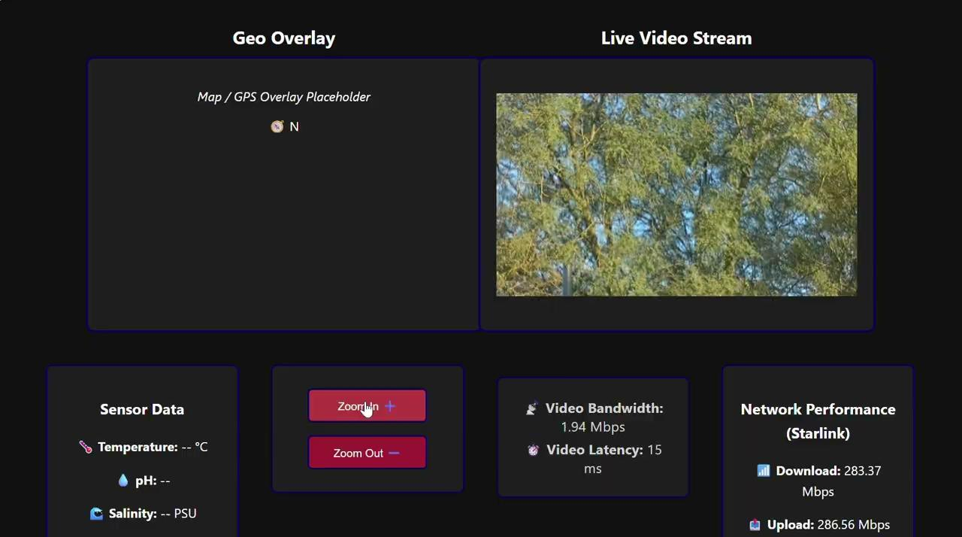
[picture p30: figure]

# Performance Analyses and Expectations

# Propulsion Expectations

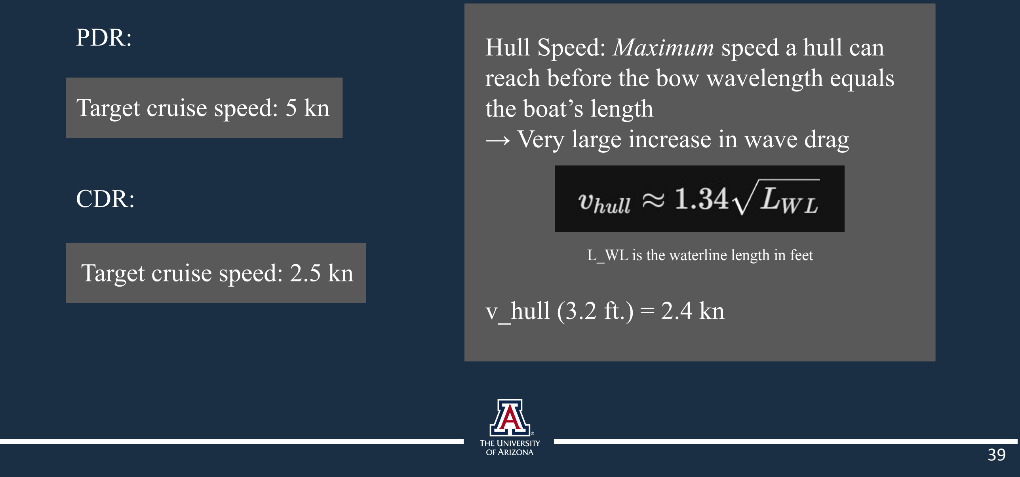
[picture p31: figure]
Target cruise speed: 5 kn; Target cruise speed: 2.5 kn; PDR:; CDR:; Hull Speed: Maximum speed a hull can reach before the bow wavelength equals the boat’s length → Very large increase in wave drag; L_WL is the waterline length in feet; v_hull (3.2 ft.) = 2.4 kn

# Propulsion Expectations

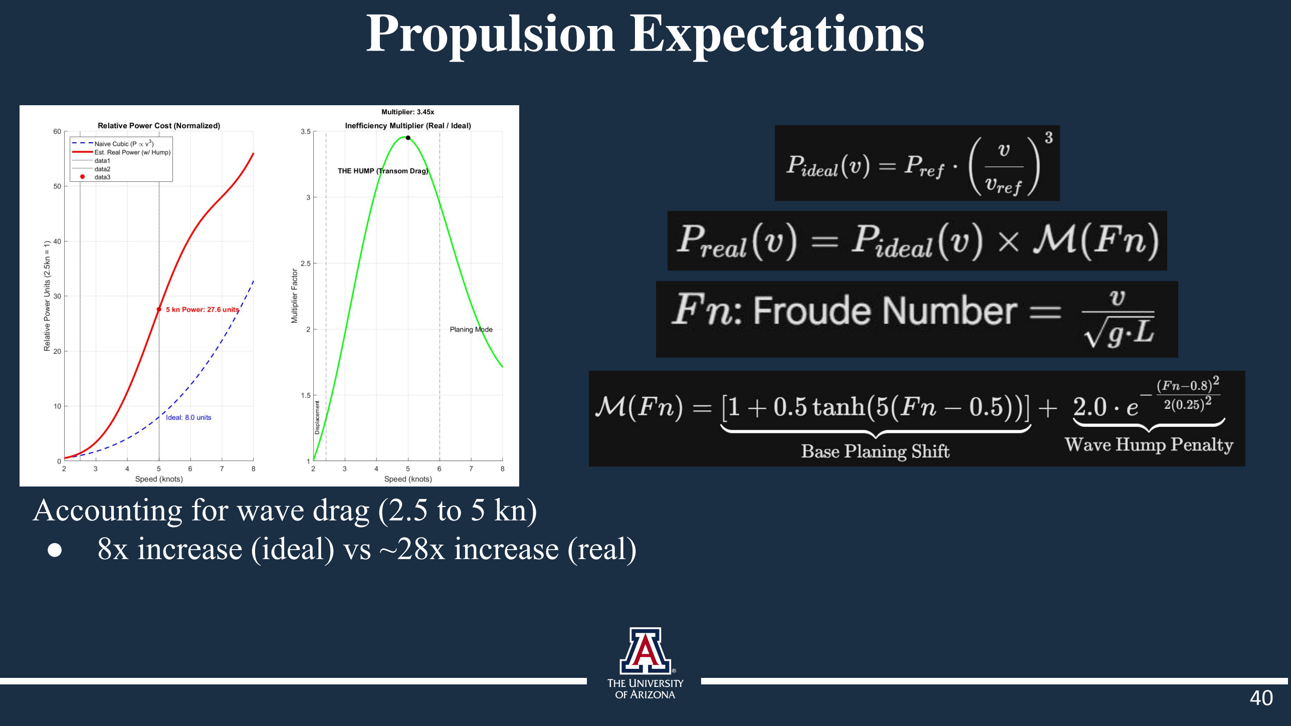
[picture p32: page 40]

Accounting for wave drag (2.5 to 5 kn)
- 8x increase (ideal) vs ~28x increase (real)

# Propulsion Expectations

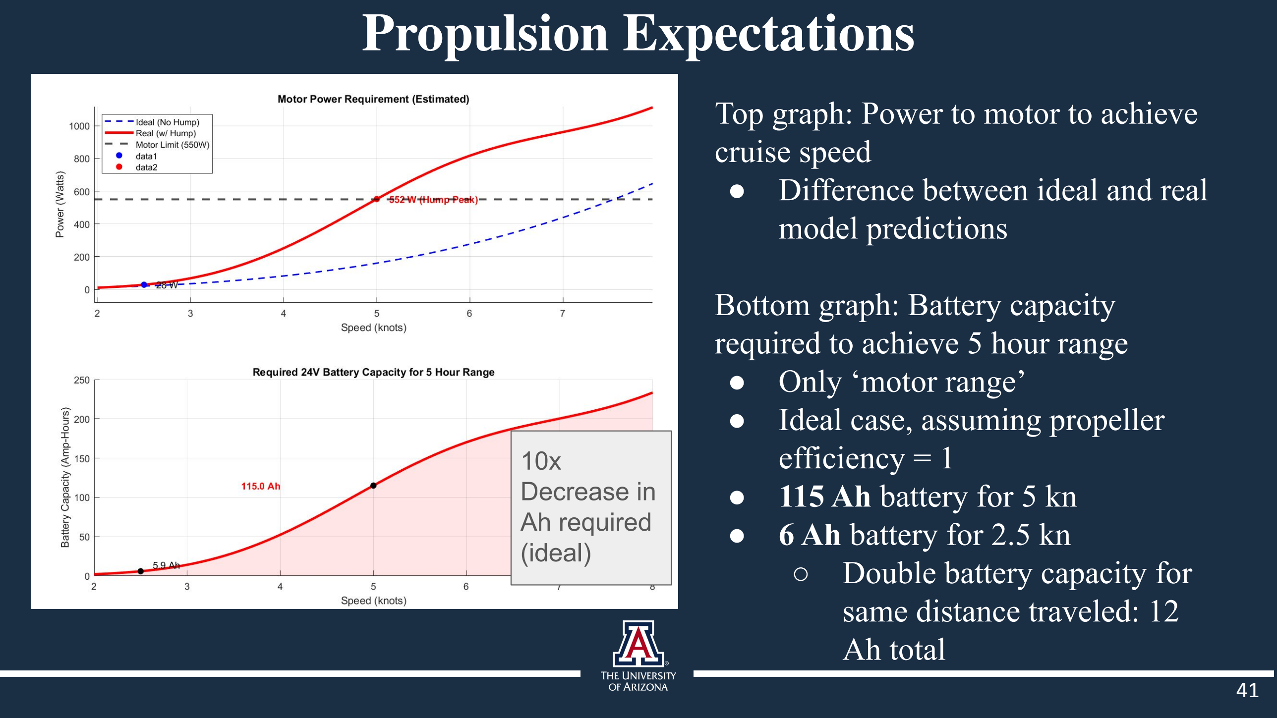
[picture p33: page 41]

10x
Decrease in
Ah required
(ideal)

Top graph: Power to motor to achieve cruise speed
- Difference between ideal and real model predictions

Bottom graph: Battery capacity required to achieve 5 hour range
- Only ‘motor range’
- Ideal case, assuming propeller efficiency = 1
- 115 Ah battery for 5 kn
- 6 Ah battery for 2.5 kn
- Double battery capacity for same distance traveled: 12 Ah total

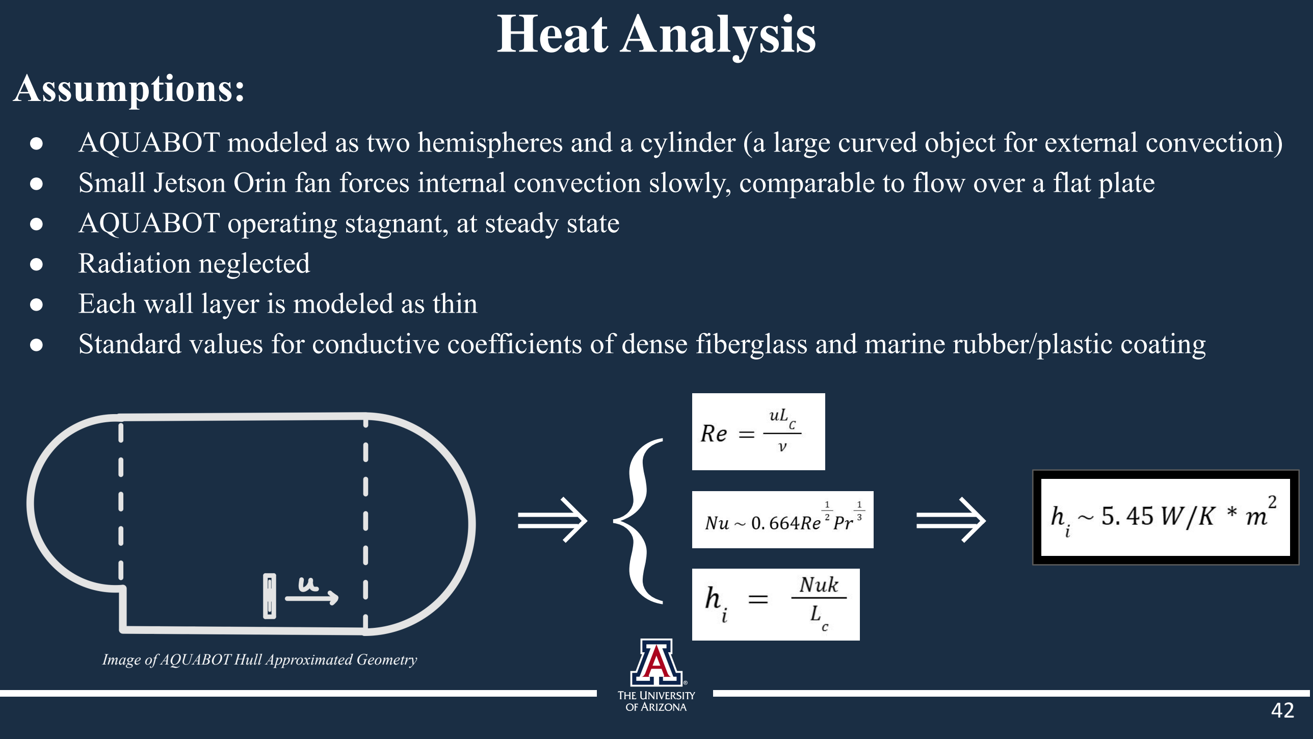
[picture p34: figure]
Heat Analysis; Assumptions:; ● Radiation neglected; ● Each wall layer is modeled as thin

- AQUABOT modeled as two hemispheres and a cylinder (a large curved object for external convection)
- Small Jetson Orin fan forces internal convection slowly, comparable to flow over a flat plate
- AQUABOT operating stagnant, at steady state
- Standard values for conductive coefficients of dense fiberglass and marine rubber/plastic coating

Image of AQUABOT Hull Approximated Geometry

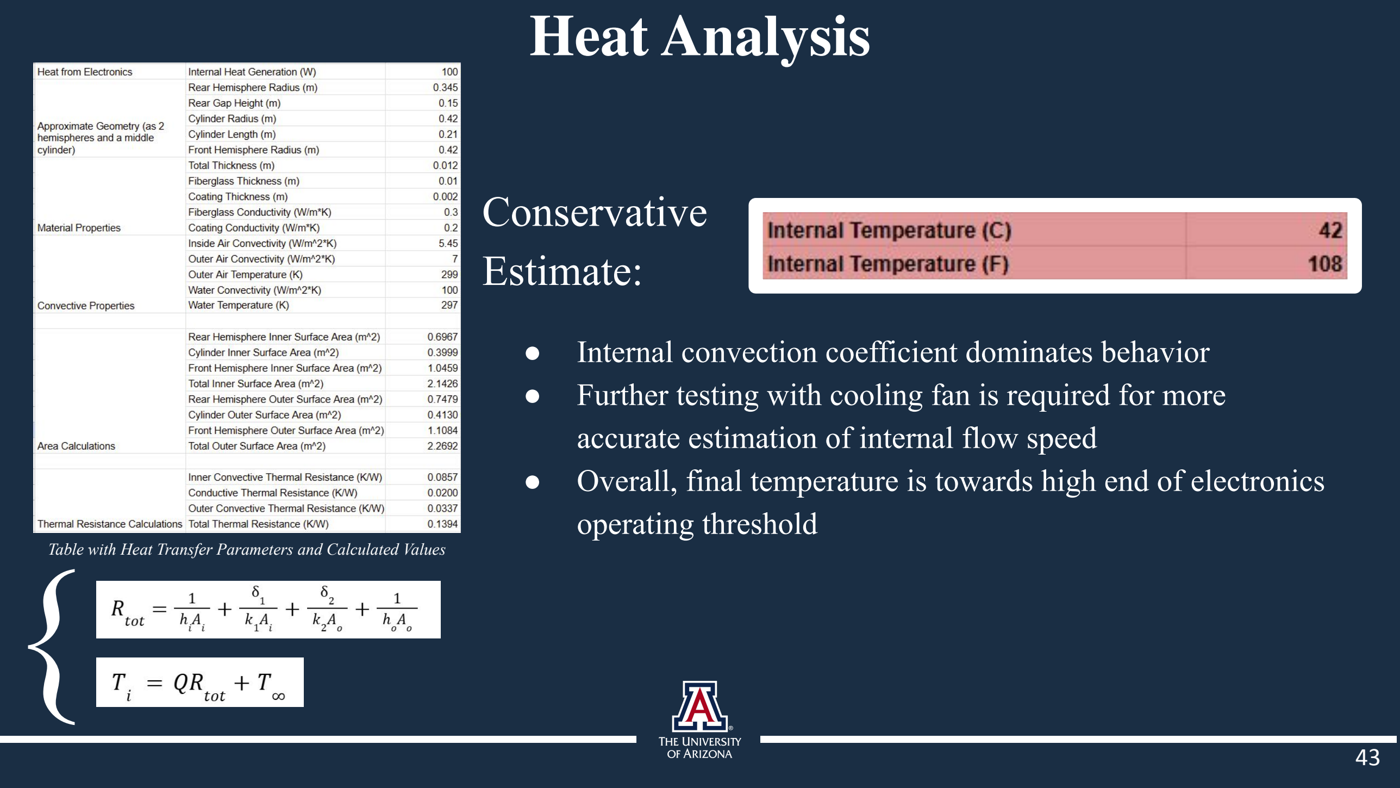
[picture p35: figure]
Heat Analysis; operating threshold; Conservative; Estimate:

Table with Heat Transfer Parameters and Calculated Values

- Internal convection coefficient dominates behavior
- Further testing with cooling fan is required for more accurate estimation of internal flow speed
- Overall, final temperature is towards high end of electronics

# GUI and Ground Station Data Expectations

## Sensor Data:

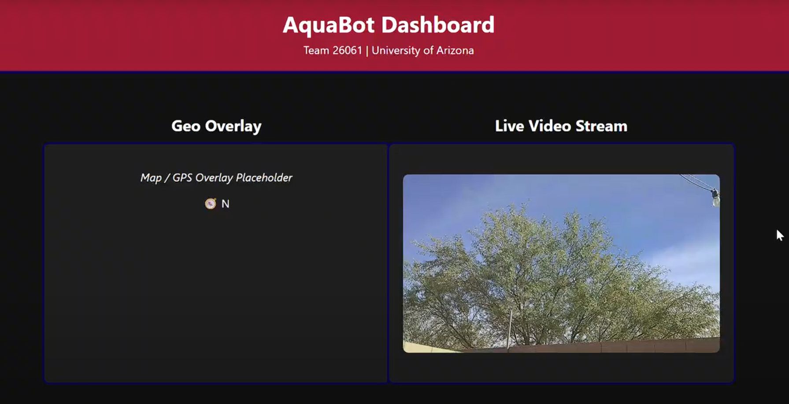
[picture p36: figure]

- All data syncs every 10 seconds (minimizes bandwidth used for data transmission)
- Temperature and GPS data integrated to create GEO-overlay for data visualization
- CSV file viewable to show location-based data for temperature, pH, and salinity.
- Saved onboard and on ground station GUI

## Camera Data:

- Saved onboard and on ground station
- Livestream on GUI dashboard, with saved footage accessible

# Verification

# Verification Overview

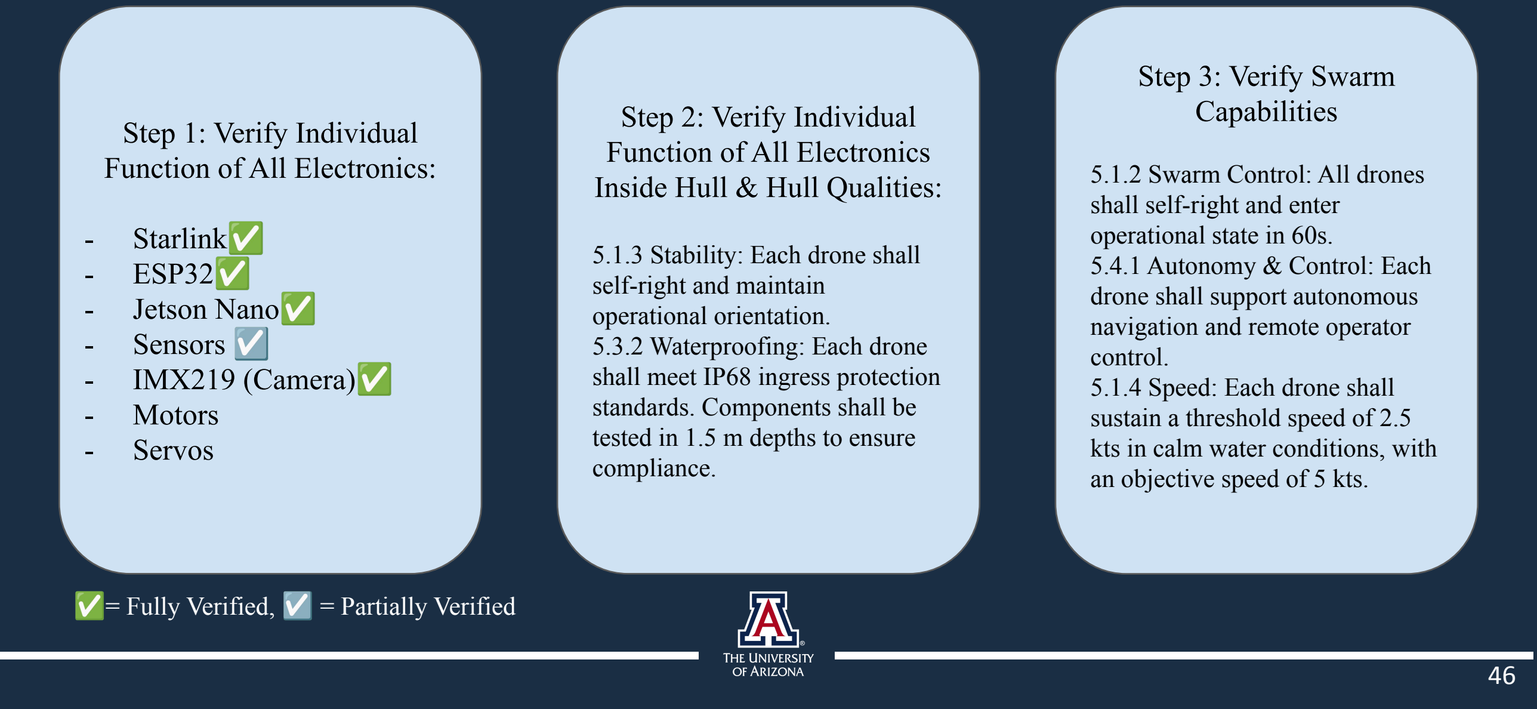
[picture p37: figure]
Step 1: Verify Individual Function of All Electronics:; - Starlink - ESP32 - Jetson Nano - Sensors - IMX219 (Camera) - Motors - Servos; Step 2: Verify Individual Function of All Electronics Inside Hull & Hull Qualities:; 5.1.3 Stability: Each drone shall self-right and maintain operational orientation. 5.3.2 Waterproofing: Each drone shall meet IP68 ingress protection standards. Components shall be tested in 1.5 m depths to ensure compliance.; Step 3: Verify Swarm Capabilities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

# Detailed Verification Plan

### 5.4.2 Verification Procedure: Mesh Network Relay Test

- Objective: Verify that the ESP-NOW Managed Flooding Mesh successfully routes telemetry from a "Follower" drone to the "Leader" drone via an intermediate "Relay" drone when a direct link is unavailable.
- Requirement Verified: 5.4.2 Inter-Drone Communication (Multi-hop capability).
- Success Criteria: Leader receives telemetry packets from Follower with a latency of < 200 ms despite no direct Line-of-Sight (LOS).
Step | Action | Expected Result | Pass/Fail
1 | Power on all 3 nodes (Leader, Relay, Follower) in close proximity (1m). | Leader Serial Monitor shows telemetry from "Follower" (Direct Link). RSSI > -50 dBm. | ☐
2 | Move "Follower" node to a distance of 100m OR place inside a metal RF shield, leaving only the "Relay" node in range. | Direct link is broken. Leader temporarily stops receiving Follower data. | ☐
3 | Position "Relay" node at the midpoint (150m) between Leader and shielded Follower. | The Mesh Logic activates. Leader resumes receiving telemetry from Follower. | ☐
4 | Inspect the received packet header on the Leader. | Packet shows Hop_Count >= 1 (indicating it passed through a relay). | ☐
5 | Measure Latency (Time Sent vs. Time Received). | Latency remains < 200 ms for the hopped packet. | ☐

# Detailed Verification Plan

### 5.1.6 Verification Procedure: Data Collection Test

- Objective: Verify that all temperature, salinity, and pH data collected is reliably saved onboard and transmitted to ground station, as well as camera footage being at 1080p, 30 fps.
- Requirement Verified: 5.1.6 Data Collection.
- Success Criteria: All data collected is accurate and adequately displayed
Step | Action | Expected Result | Pass/Fail
1 | Test all three sensors in a liquid of known qualities. (Not transmitted via Starlink) | Data collected matches known values | ☐
2 | Retake data with transmission to GUI via Starlink | GUI data matches known values | ☐
3 | Connect camera to GUI and onboard storage, inspect saved data. | Saved data matches and is accessible via GUI | ☐
4 | View stored data on ESP32 via connection to monitor and stored data on GUI | Stored data demonstrates equivalent values per timestamp | ☐
5 Test and modify GUI for usability and interpretation of data | | GEO-overlay accurately displays data in a user-friendly manner, all data is easily accessible. Camera live stream and review is functional. | ☐

# Detailed Verification Plan

### 5.4.6 Verification Procedure: Swarm Control

- Objective: Successfully communicate position data and maintain formation within the specified timing constraints (<1s latency & >= 1Hz update)
- Requirement Verified: 5.4.6 Swarm Control
- Success Criteria: The swarm shall maintain coordinated network behavior through a leader-follower model executed via Jetson Mission Computer and MQTT topics. Each drone shall publish and subscribe to swarm state messages at ≥ 1 Hz with < 1 s latency.
Step | Action | Expected Result | Pass/Fail
1 | Initialize Swarm Network: Each drone connects to the MQTT broker, and verifies communication with the Jetson Nano. | Ground station receives communication from both Drone IDs via MQTT; Link Quality > 50% | ☐
2 | Establish Leader-Follower Roles: The leader drone publishes its state and navigation cues, while follower drones sync. | Follower drones successfully identify the Leader ID, switch to following state, and begin mirroring the Leader’s heading and velocity in 1s or less. | ☐
3 | Exchange Swarm State Messages: All drones publish and subscribe to swarm state topics at ≥1 Hz, ensuring message latency stays under 1 s. | Telemetry logs confirm that packets form every Drone ID appear in the swarm/state topic at intervals of <= 1s (>= 1Hz). Timestamp shows the delay between sent and received time is consistently less than 1s. | ☐
4 | Coordinate Navigation: Using GPS data, each drone adjusts its path to maintain formation and avoid collisions while following trajectory. | Follower drones autonomously adjust motor thrust/yaw to maintain target separation distance from the Leader. Visual observation and GPS tracks confirm drones move in parallel paths without colliding. | ☐
5 | Collect Data: Each drone gathers environmental data and publishes it to the swarm network for processing. | Ground station compiles a unified dataset containing sensor readings from all distinct Drone IDs. The aggregated file shows no data gaps larger than 3 seconds and timestamps are synchronized | ☐

# Risk Analysis

# Risk Analysis

Impact

5

4 | R002 | R003 | R001

3

2 | R004 | R005

1

1 | 2 | 3 | 4 | 5
Likelihood
Impact | Likelihood
5 - Catastrophic | 5 - Near Certainty
4 - Major | 4 - Highly Likely
3 - Moderate | 3 - Likely
2 - Minor | 2 - Somewhat Likely
1 - Insignificant | 1 - Not Likely

High Risk

Moderate
Risk

Low Risk

ID | Risk Description | Severity (L x I)
R001 | Integrating all software components | 16
R002 | Hull fragility due to modification | 8
R003 | Lack of software knowledge | 12
R004 | Assessing capabilities of smaller drones | 4
R005 | Modifying pre-manufactured drones | 6

# Risk Analysis: Mitigation Plan

R001 (high): Integrating all software components
1. Consult with experts and use university resources
a. Find out where problems lie early
2. Plenty of tests to ensure successful results
a. Correct input-output mapping
R002 (medium): Hull fragility due to modification
1. Talk to Eddie’s Marine Equipment to learn correct modification methods
2. Investigate alternative mounting solutions (no hull modification)
3. Conduct isolated hull testing post-modifications
R003 (medium): Lack of software knowledge (we don’t know what we don’t know)
1. Use of AI as a guide to find surface level flaws
2. Consult with experts and use university resources to further improve/ final check

# Project Status & Plan

# PERT Chart

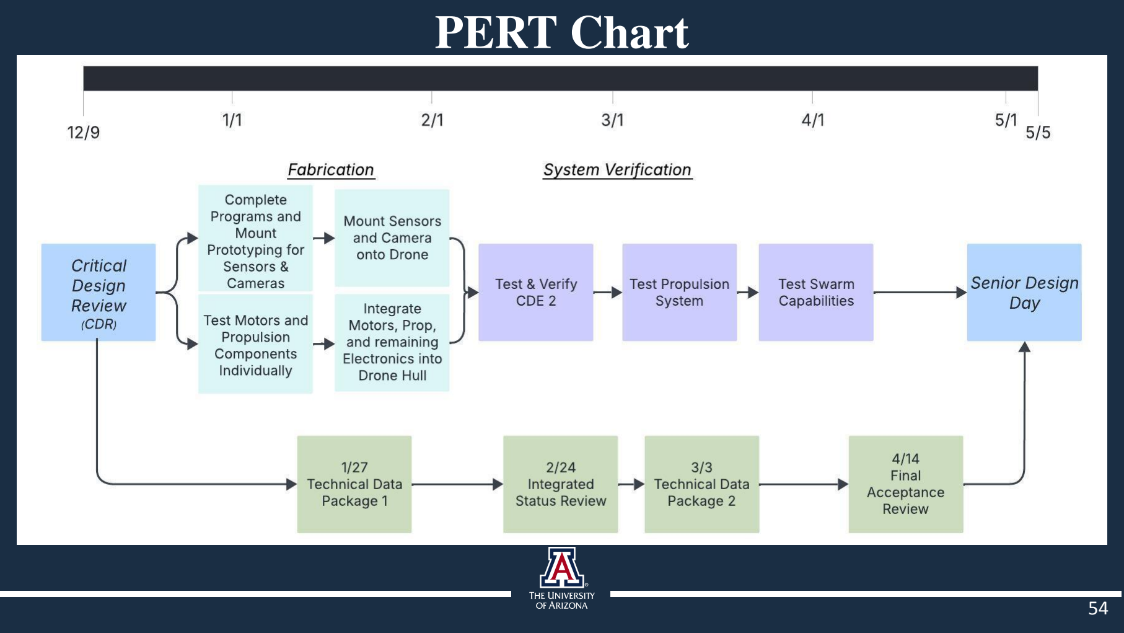
[picture p38: page 54]

# Critical Design Element 1

# Critical Design Element (CDE-1)

CDE1 demonstrates reliable two-way data communication between AQUABOT and the ground GUI via Starlink/Wi-Fi, enabling both real-time data transmission and remote command.

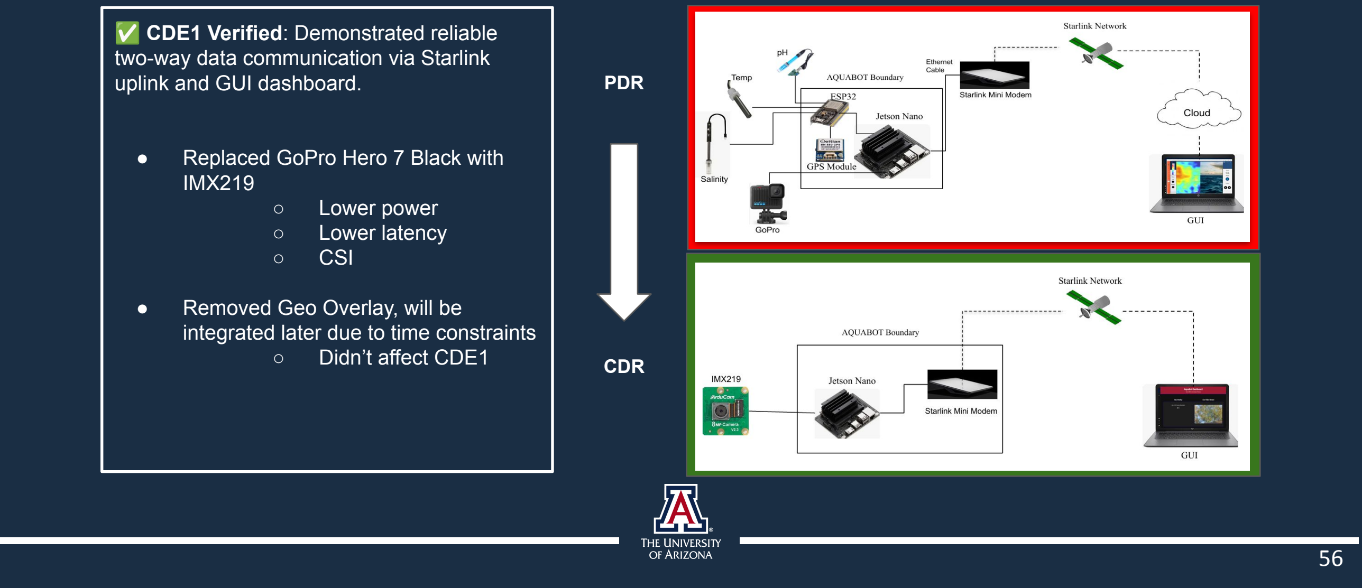
[picture p39: figure]
CDE1 Verified: Demonstrated reliable two-way data communication via Starlink uplink and GUI dashboard.; ● Replaced GoPro Hero 7 Black with IMX219; ○ Lower power ○ Lower latency ○ CSI; ● Removed Geo Overlay, will be; ○ Didn’t affect CDE1; PDR; CDR

integrated later due to time constraints

### Expected Video Bandwidth for AquaBot Live Stream

## (1080p H.264 WebRTC)

Raw Video (Uncompressed)
Bandwidth

We start with the raw camera output:

Raw bitrate =
1920x1080×30fps×24 bits =
1,492,992,000 bits/sec ≈

### 1.49 Gbps uncompressed

Camera Resolution & Encoding

- Sensor: IMX219 (Raspberry Pi v2 camera)
- Resolution: 1920×1080 @ 30 FPS
- Codec: H.264 (NVIDIA hardware encoder)
- Streaming Protocol: WebRTC (real-time, low-latency)

Equation used to Estimate bandwidth for 1080p H.264 WebRTC :

Bitrate=bpp⋅Resolution(W)⋅Resolution(H)⋅fps

Target Bitrate=Bitrate⋅(1+Overhead)⋅α

*Overhead = protocol + header overhead (≈ 0.10)

*α = safety margin (≈ 0.85 for adaptive streaming)

Expected bandwidth for AquaBot

For real testing in the ocean:

| Scenario | Expected
- | Calm Ocean | 2.3 Mbps
- | Moderate waves | 3.5 Mbps
- | Rapid motion | 5.8 Mbps

* Plus 0.25 Mbps for control + telemetry

Based on validated H.264 encoding practice for 1080p30 video across varying motion complexity:

- Calm ocean (low motion): bpp ∈ [0.03, 0.05]
- Moderate waves (medium motion): bpp ∈ [0.05, 0.08]
- Rapid motion (high motion): bpp ∈ [0.08, 0.12]

Max Expected Bandwidth ≈ 6 Mbps

# Starlink Analysis

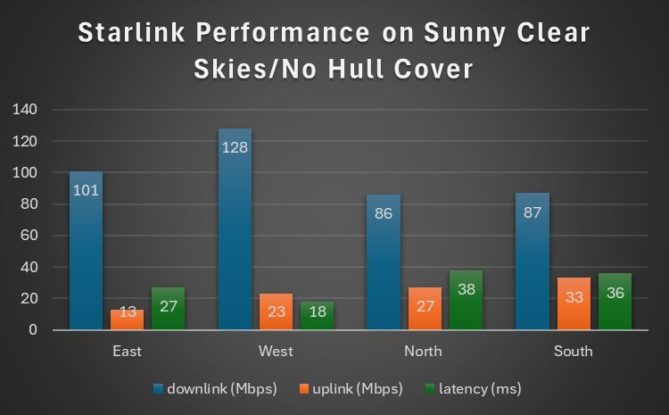
[picture p40: figure]
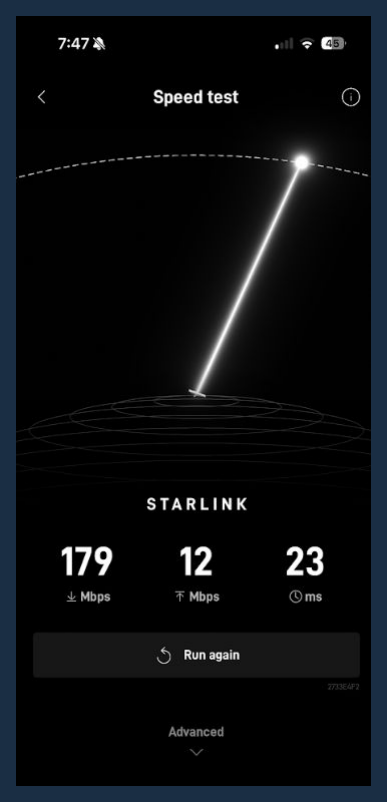
[picture p41: figure]

- Speed test from Starlink App

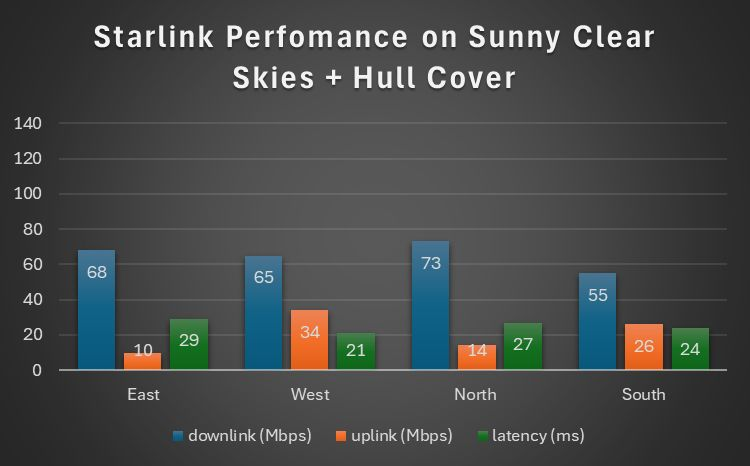
[picture p42: figure]

- We tested in a neighborhood with lots of Wi‑Fi and signals, so it’s a worst‑case scenario.
- Out on the ocean there are no houses or obstacles, so interference is much lower.
- Performance in deployment will be stronger than what we measured here.
- Maritime Service - Open Ocean/Stronger signal and consistent throughput.
Worst case scenario: | Uplink:10 Mbps
Downlink: 55 Mbps | 6 Mbps < 10 Mbps

# Verification Setup: Starlink + GUI Streaming Test

1. Jetson auto boots when
connected to power
3. Run signaling_server.py & app.py on terminal
2. Place Starlink under hull top

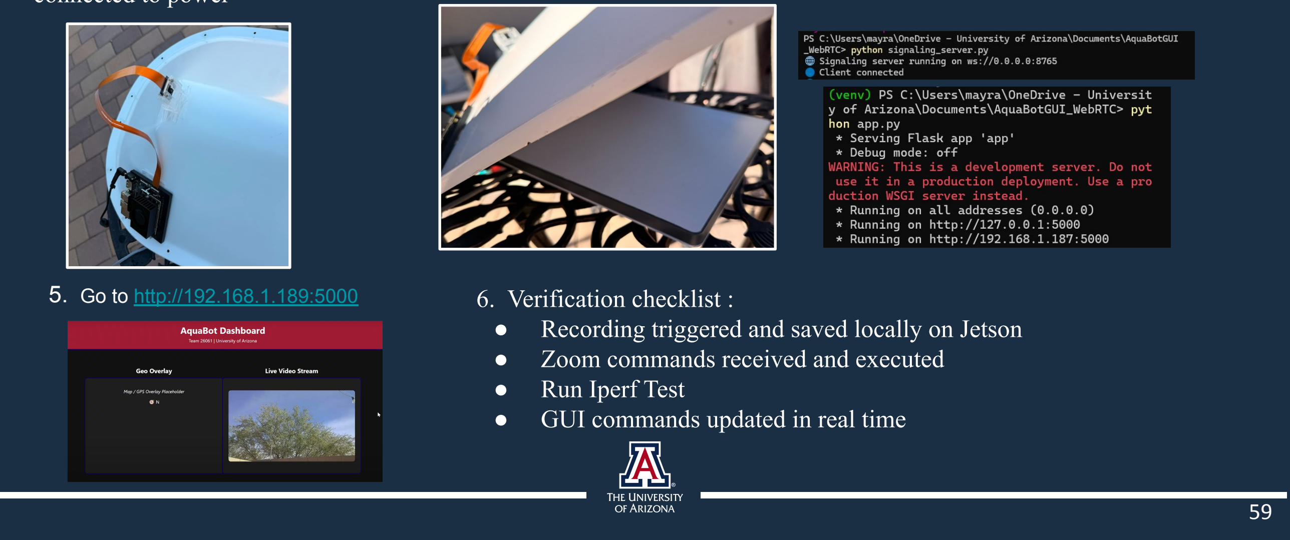
[picture p43: figure]
6. Verification checklist :; ● Zoom commands received and executed ● Run Iperf Test ● GUI commands updated in real time; Go to http://192.168.1.189:5000

- Recording triggered and saved locally on Jetson

# Live GUI Demo

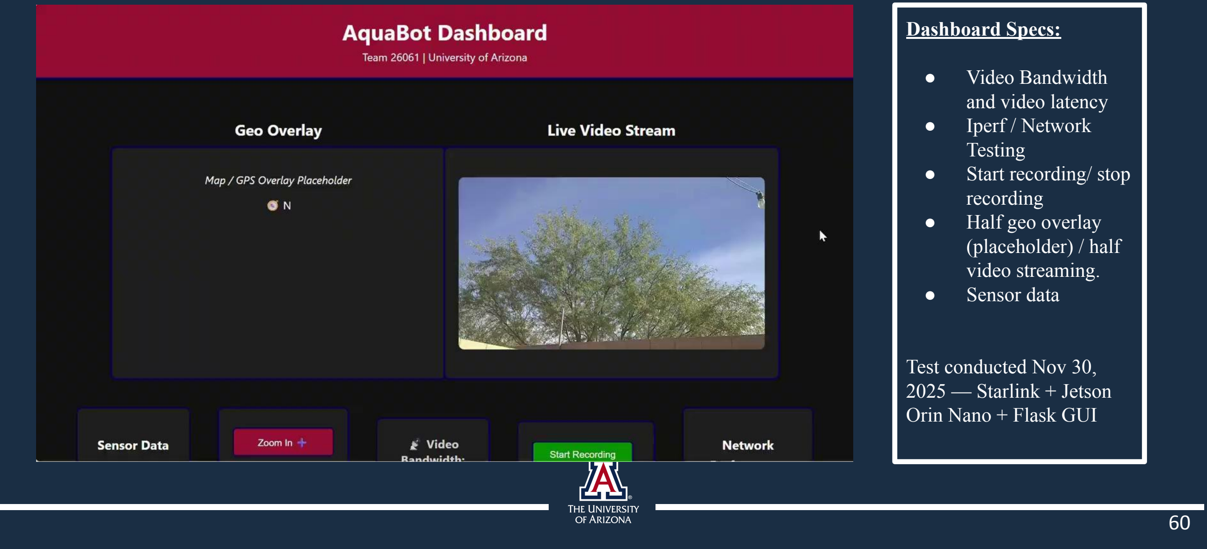
[picture p44: figure]
Dashboard Specs:; ● Video Bandwidth and video latency ● Iperf / Network Testing ● Start recording/ stop recording ● Half geo overlay (placeholder) / half video streaming. ● Sensor data; Test conducted Nov 30, 2025 — Starlink + Jetson Orin Nano + Flask GUI

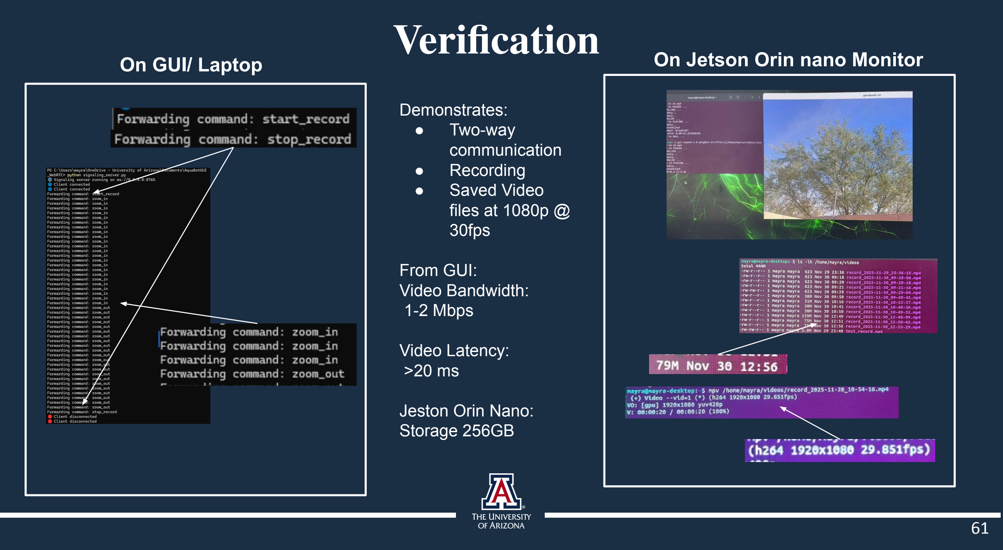
[picture p45: figure]
Verification; Demonstrates: ● Two-way communication ● Recording ● Saved Video files at 1080p @ 30fps; From GUI: Video Bandwidth: 1-2 Mbps; Video Latency: >20 ms; Jeston Orin Nano: Storage 256GB; On Jetson Orin nano Monitor; On GUI/ Laptop

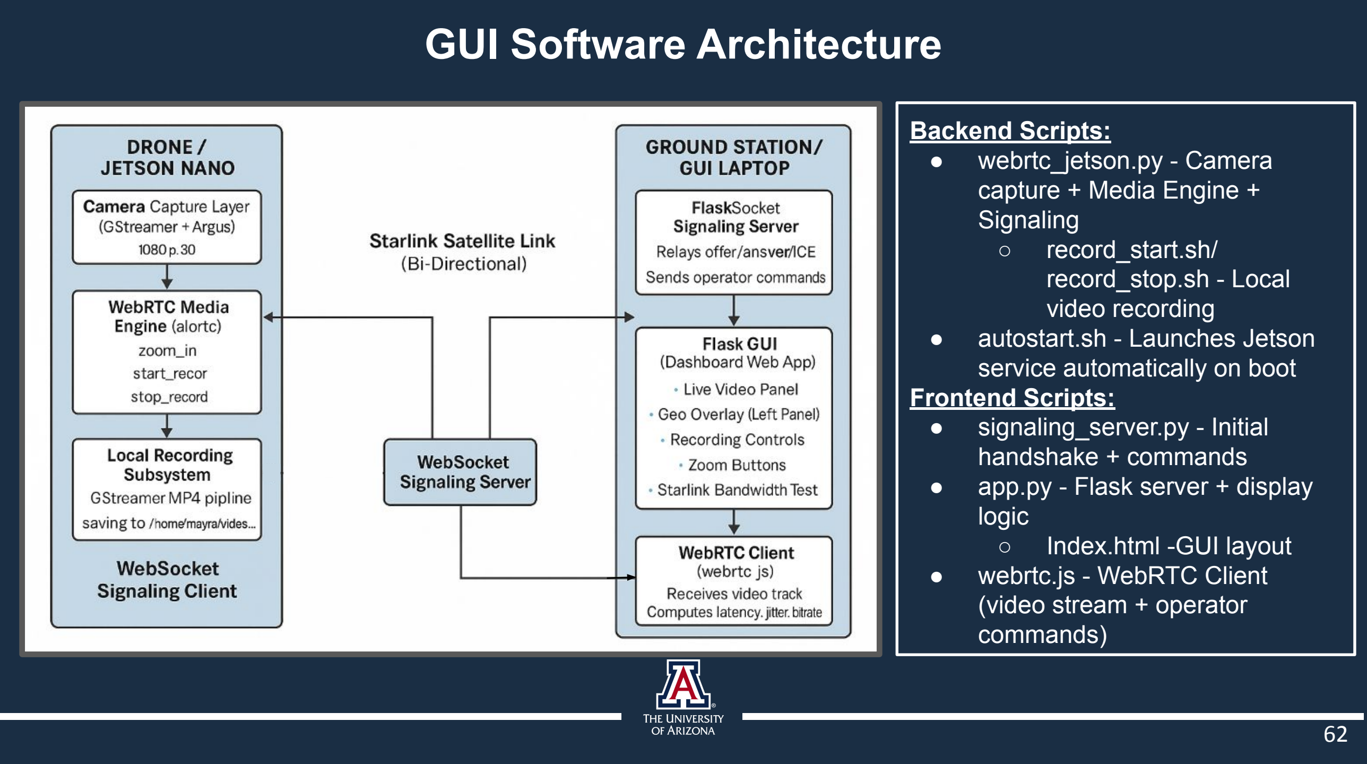
[picture p46: figure]
GUI Software Architecture; Backend Scripts: ● webrtc_jetson.py - Camera capture + Media Engine + Signaling ○ record_start.sh/ record_stop.sh - Local video recording ● autostart.sh - Launches Jetson service automatically on boot Frontend Scripts: ● signaling_server.py - Initial handshake + commands ● app.py - Flask server + display logic ○ Index.html -GUI layout ● webrtc.js - WebRTC Client (video stream + operator commands)

# CDE 1 Results

- 5.4.4 Satellite Uplink: Each AQUABOT drone shall independently transmit live and stored data to a remote ground station via its onboard Starlink.
- 5.1.6 Data Collection: Each AQUABOT drone shall measure temperature, salinity, pH, and capture visual imagery at a minimum of 1080p resolution, 30 fps.
- Verified: IMX219 camera streaming at 1080p/30fps
- 5.4.5 Display: The display shall show half the display with Geo-overlay and the other half will display live-streaming.
- Verified: GUI layout splits display as required/ half live video streaming.
- 5.4.1 Autonomy & Control: Each AQUABOT drone shall support both autonomous navigation and remote operator control via a satellite-based waypoint system.
- Verified: Remote control via GUI confirmed.
Verified | Partially Verified

## CDE1: Risk and Complexity + Next Steps

Risk:

System Complexities:

- Two-network WebRTC
- ICE/NAT traversal
- Starlink routing
fluctuations
- Added data flows (video
+ telemetry +
commands)
Risk | Cause | Impact | Mitigation
WebRTC fails across two networks | NAT/ICE candidate rejection | Loss of remote command/vi deo | Add TURN/STUN server, test different relay configs
Starlink connection interruptions | Satellite acquisition / weather | Increased latency, packet loss | Add buffering, dynamic bitrate (WebRTC)
Bandwidth variability | Starlink uplink fluctuations | Lower video quality | Adaptive bitrate + video fallback
Sensor + video concurrency | Multiple data channels | CPU/Netwo rk load | Prioritize RTP stream, stagger telemetry

Next Step:

- TURN server
addition
- Remote testing
- Geo-overlay
- Full sensor
integration
- CDE-2 prep

*High Risk

CDE-1 validated reliable two-way communication on Starlink; next phases extend to multi-network.

# Critical Design Element 2

# Critical Design Element (CDE-2)

Builds from CDE-1 two-way communication:
- Integrates system into hull with waterproofing
- Verifies system functionality within hull
- Transmits all sensor data in addition to camera live stream

Key Steps:
- Finalize mount prototypes
- Waterproofing of camera and sensor electronics
- Safely connect and organize electronics within drones (ESP32, Jetson Nano, Starlink)
- Programming of GUI

Objective:
CDE-2 will demonstrate sensor and camera connectivity to the ground station GUI, while being integrated into the drone hull itself.

# Sensor and Camera Mounts

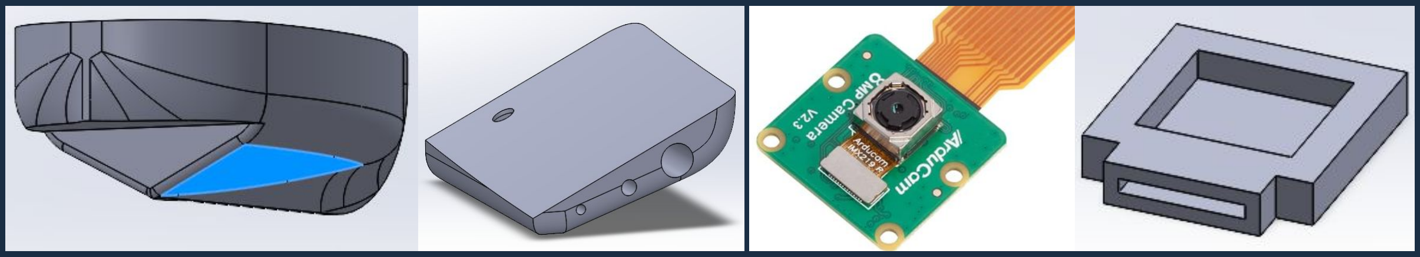
[picture p47: figure]

Sensor Mount:

- External mount with hole for wires to connect to internal ESP32 in hull
- Recesses to fit temperature, salinity, and pH sensors, with space for wire storage in back.
- Arch can be modified to fit onto RC boats
- 3D printed with silicone coating and o-rings
- Room for additional sensors

IMX219z Mount:

- Holds camera in place above drone
- Slit allows for wiring to occur within the drone.
- 3D printed with silicone coating and transparent material to protect camera

# Critical Design Element (CDE-2)

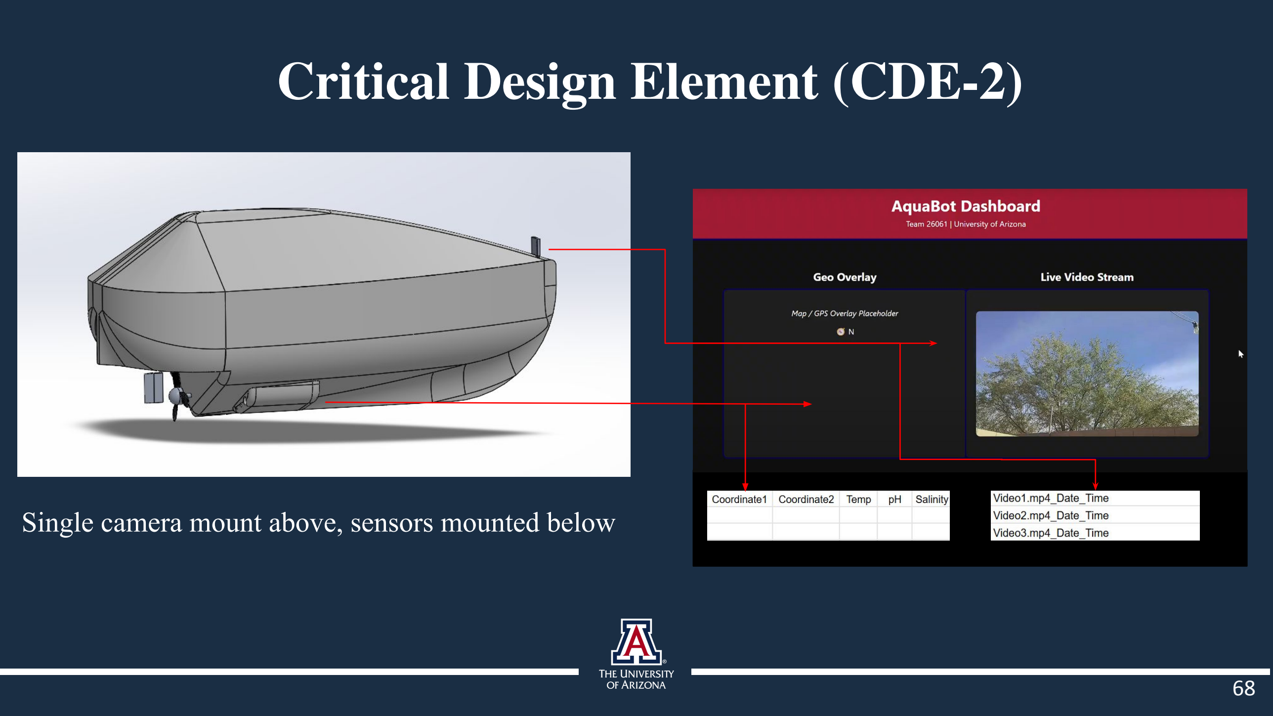
[picture p48: page 68]

Single camera mount above, sensors mounted below

# Critical Design Element (CDE-2) Verification

Components needed:
- Temp, pH, and salinity
sensors
- IMX219 Camera
- ESP32
- Jetson Orin Nano
- Starlink
- Ground station monitor
and keyboard
- Hull
- Mounts and mounting
materials

Procedure:
1. Place hull into pool of water of known temperature, salinity, and pH. Ensure sensors, camera, ESP32, Jetson Nano, and Starlink are all powered on and connected to ground station.
2. From ground station, ensure that sensor data is updating every 10 seconds, and camera is streaming at 30 fps and 1080p.
3. Compare sensor data to known data values for water.

Risks:
- Waterproofing
- Sensitivity, longevity of sensor run time
- Heat from drone affecting sensor values

# Requirements Verification

- 5.1.6 Data Collection: Each AQUABOT drone shall measure temperature, salinity, pH, and capture visual imagery at a minimum of 1080p resolution, 30 fps.
- Sensor + camera integration
- 5.4.5 Display: The display shall show half the display with Geo-overlay and the other half will display live-streaming.
- Confirms usable internal volume for all subsystems
- 5.2.4 Payload Mounts: The hull shall provide standardized, sealed mounts for Starlink terminal, battery, and sensor payload.
- Shows standardized sealed mounts in practice
- 5.3.2 Waterproofing: Each aquatic AQUABOT drone shall meet IP68 ingress protection standards IAW IEC 60529:1989 + AMD1:1999 CSV. Waterproof components shall be tested in 1.5 m depths to ensure compliance.
- Verifies waterproofing during integration sensor/camera operation

Verify with CDE2

# Cost Analysis and Deliverables

# Bill of Materials

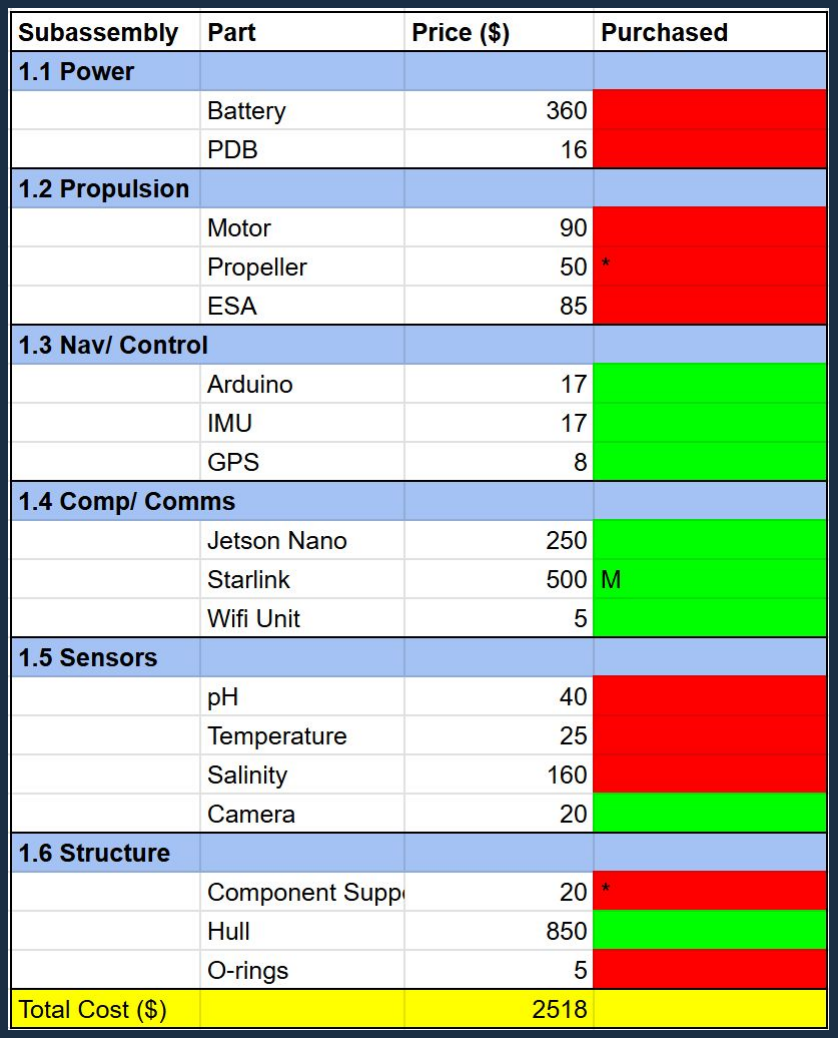
[picture p49: figure]

* | Printed or Machined Part
M | Also includes monthly subscription

# Cost Analysis

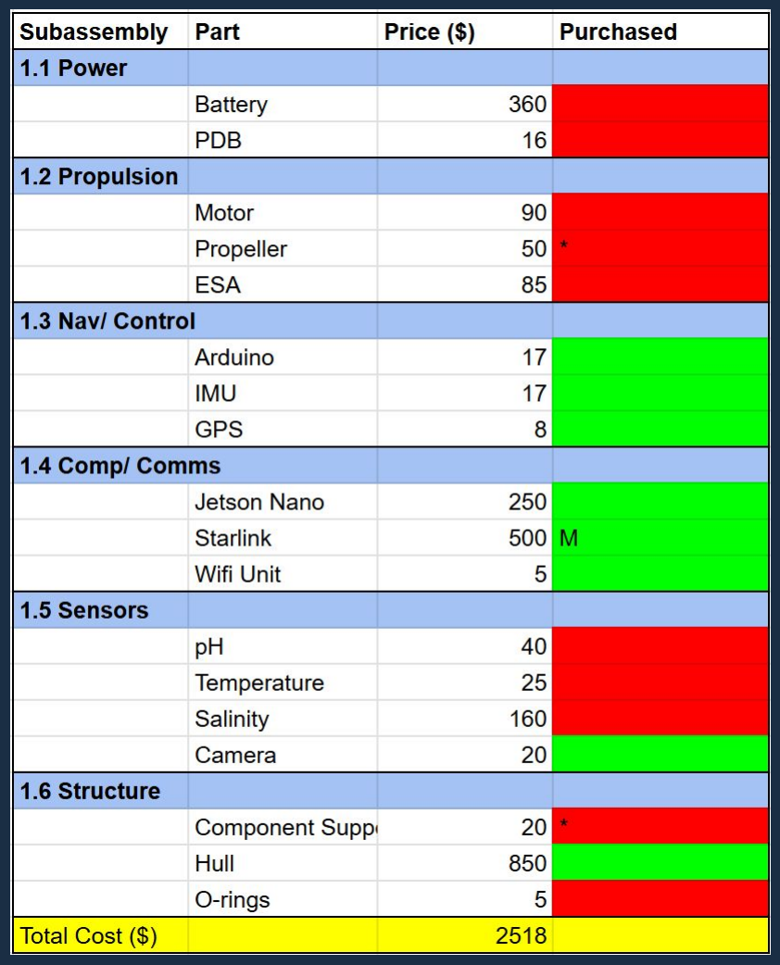
[picture p50: figure]

* | Printed or Machined Part
M | Also includes monthly subscription
- Highest costs:
- Hull ($850)
- Starlink ($500)
- Battery ($360 *on sale)
■ Lower range or speed
- Not every drone needs a Starlink or Jetson Nano
- Based on BW, likely ⅓
- Average cost to $2000 per drone

# Cost Analysis

- Net Cost (tax + shipping): $2700
- Will go to one complete drone
- Reserve Cost: | $1300
- $800 for:
■ Updates to 2025 Hull
■ Testing
■ Additional Materials
- $500 for:
■ Any unforeseen costs
- Shipping, tariffs, etc. * | Printed or Machined Part
M | Also includes monthly subscription

# Deliverables

Deliverable | Date | Description
Programmed Cameras and GUI | 12/9/2025 | Camera connected and linked to GUI
Programmed Sensor Suite | 12/9/2025 | Sensors and GPS integrated
Materials CAD | 12/9/2025 | CAD for all major systems complete
Mounted Cameras | 1/2/2026 | Equipped with both storage and streaming abilities.
Communication Module | 1/22/2026 | Starlink integrated with all components & GS.
Propulsion System | 2/5/2026 | Functional propulsion system w/ motor control
Operational Ground Station | 2/19/2026 | GUI and backend for live data transmission
Functional Hull Prototype | 3/5/2026 | Hull integrated with all components
Manual | 4/14/2026 | Includes documentation and user guides
Project Final Report | 5/5/2026 | Includes summary, system specs, and results

# Summary

# Summary

Key Features of Our System:
- Integrated sensor suite (pH, salinity, temperature, 1080p camera).
- Starlink-based communication for live video and data transmission.
- Ground station with sensor data and camera livestream, as well as navigational control
- Reusable, impact-resistant hull.
- Swarm deployment and short-term ocean monitoring capability.

Critical Design Element (CDE-2):
Demonstrates data accuracy and live data display while sensors and camera are integrated into the hull.

Next Steps:
Finalize prototypes, begin hull fabrication and verification of performance requirements.

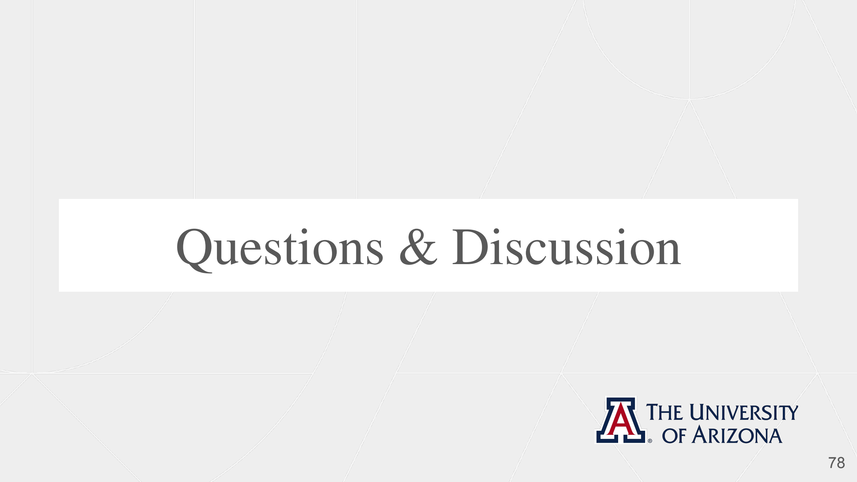
[picture p51: page 78]

# Questions & Discussion

# Appendix

# Appendix

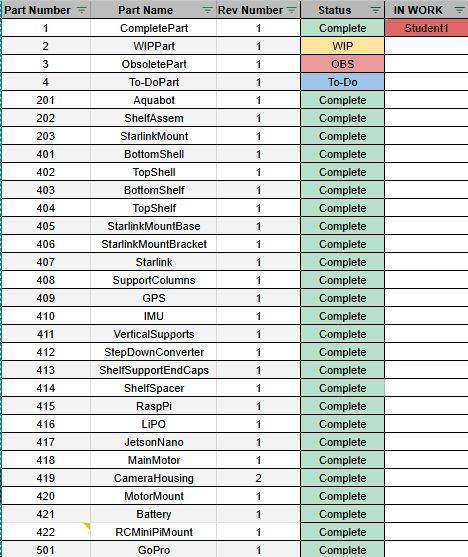
[picture p52: figure]

Parts and Drawings List

# Appendix

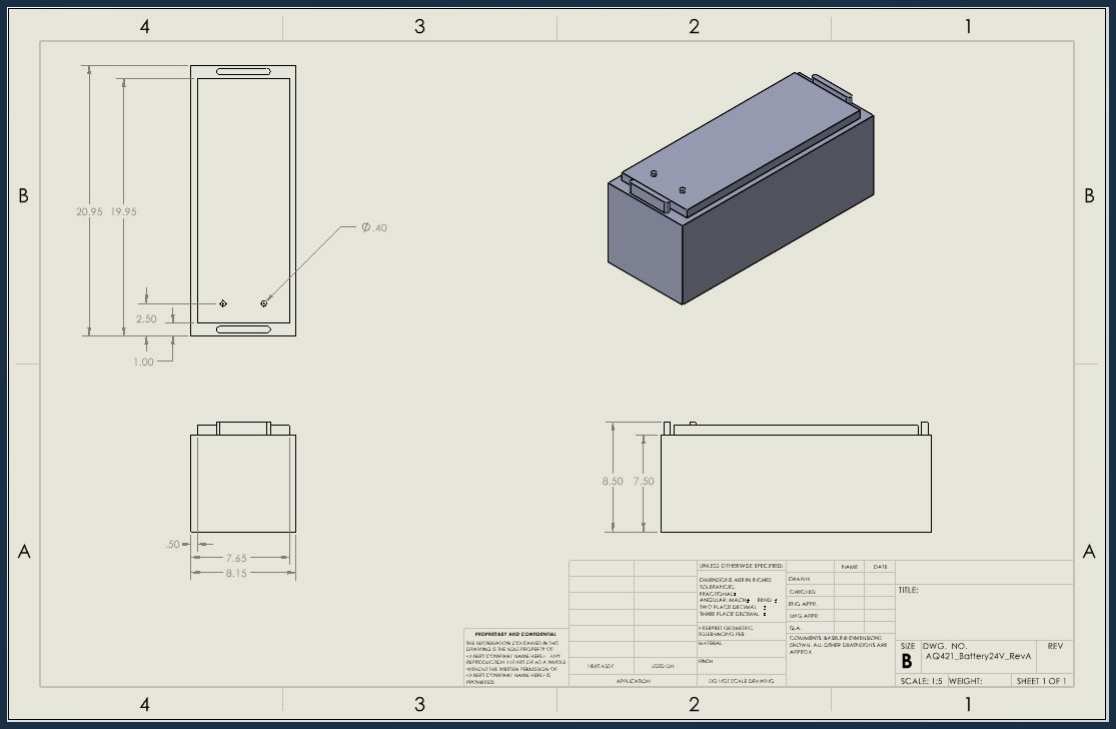
[picture p53: figure]

24V Battery Drawing

# Appendix

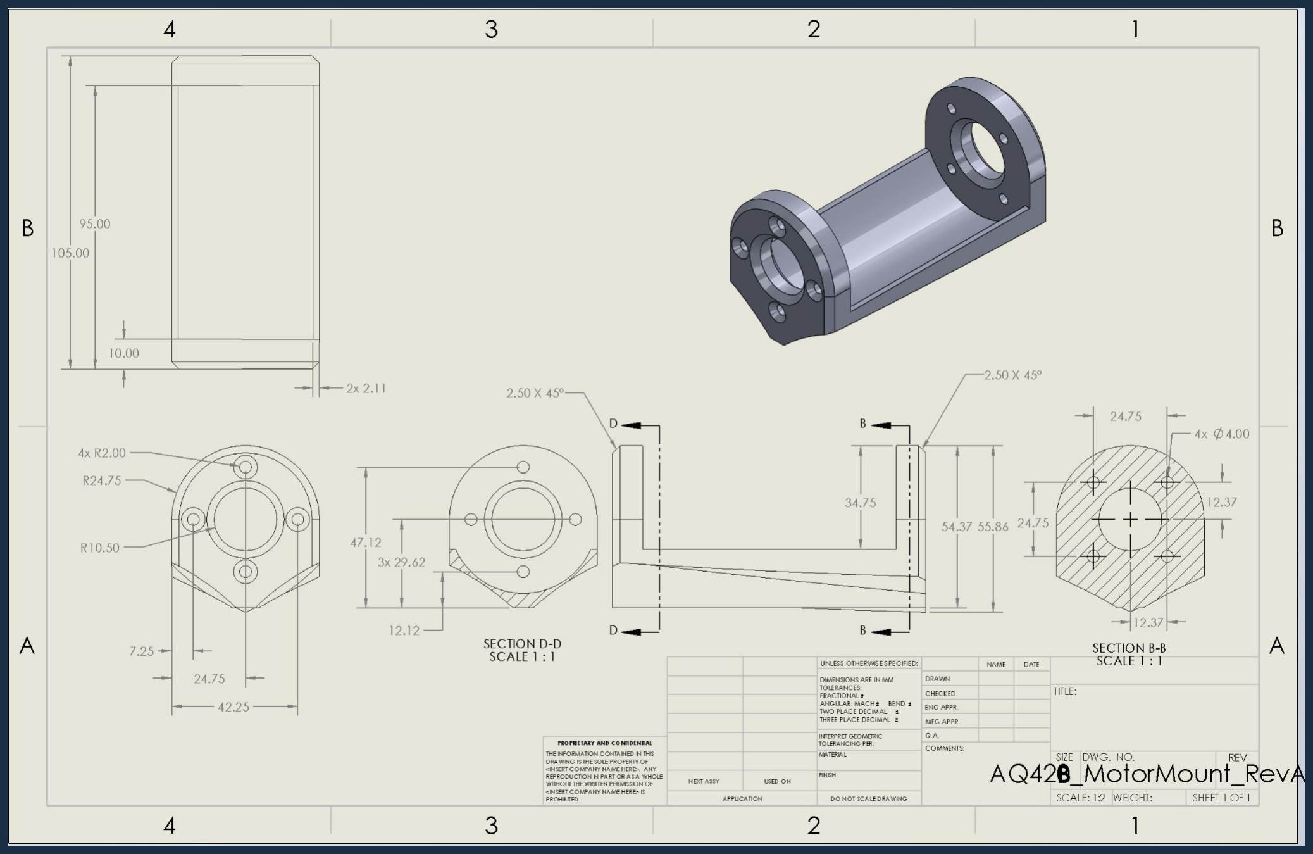
[picture p54: figure]

Motor Mount Drawing
