JRL000/AQUABOTS/92005A452_Steel Pan Head Phillips Screw.JPG

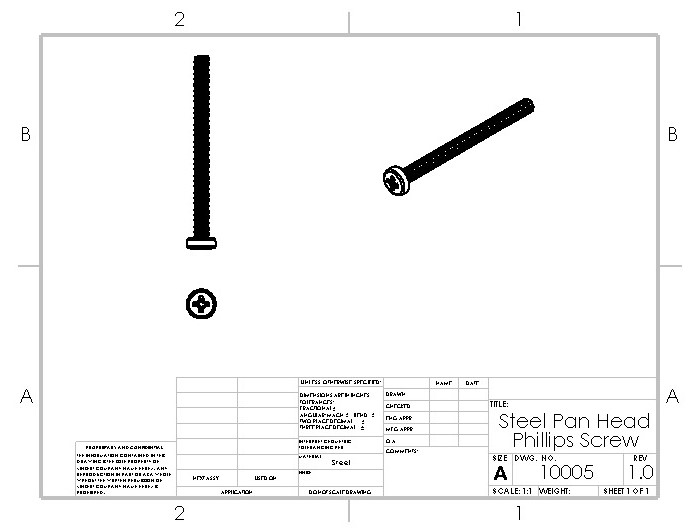
92005A452_Steel Pan Head Phillips Screw.JPG
