JRL000/AQUABOTS/Assem2JPEG.JPG

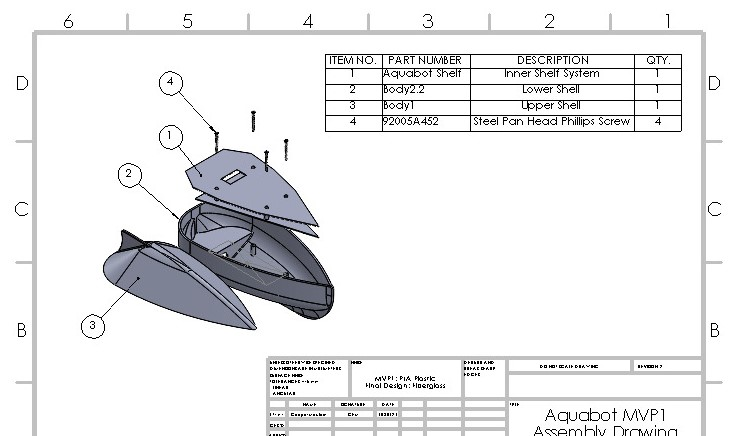
Assem2JPEG.JPG
