JRL000/AQUABOTS/docs/pics/schedule.png

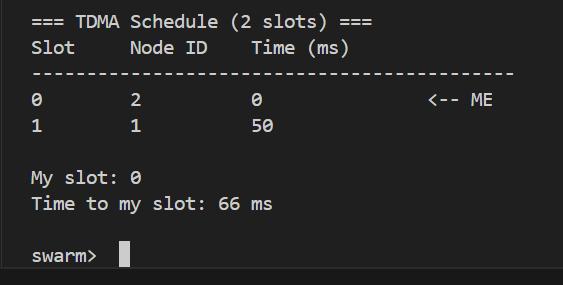
docs/pics/schedule.png
