JRL000/AQUABOTS/ground_station_folder/graphics/IMUG.png

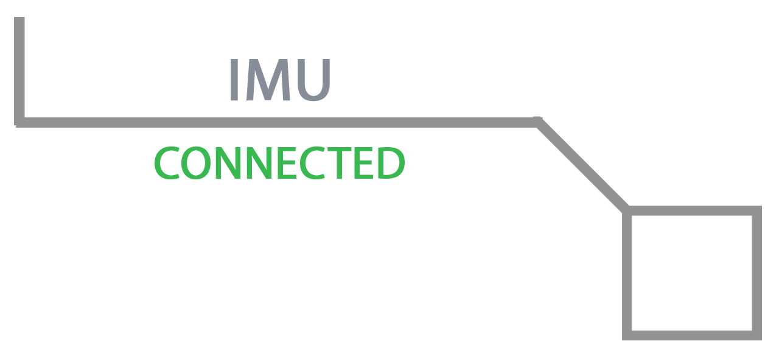
ground_station_folder/graphics/IMUG.png
