JRL000/AQUABOTS/John/Pics/goto.png

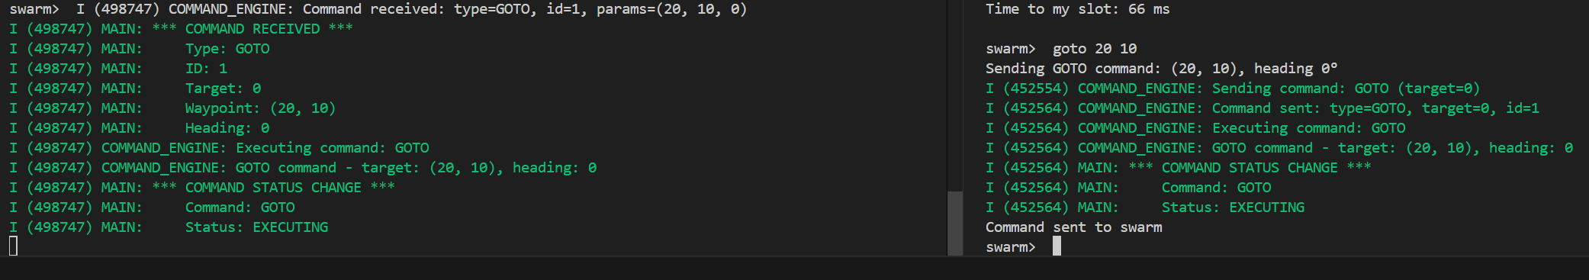
John/Pics/goto.png
