JRL000/AQUABOTS/John/Pics/members.png

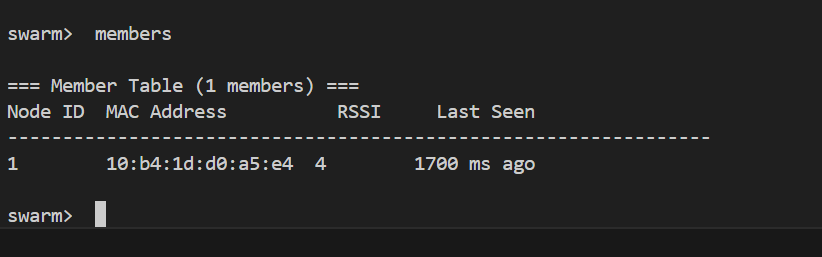
John/Pics/members.png
