JRL000/AQUABOTS/John/Pics/other commands.png

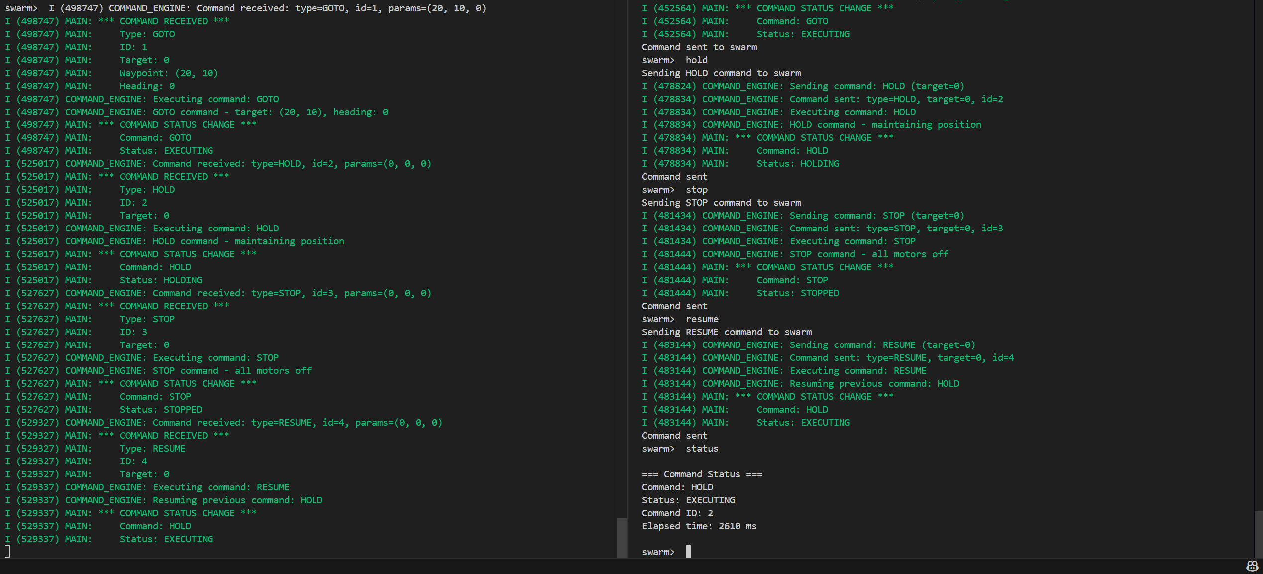
John/Pics/other commands.png
