JRL000/AQUABOTS/reference/BoatWithElectronicsDrawingJPEG.JPG

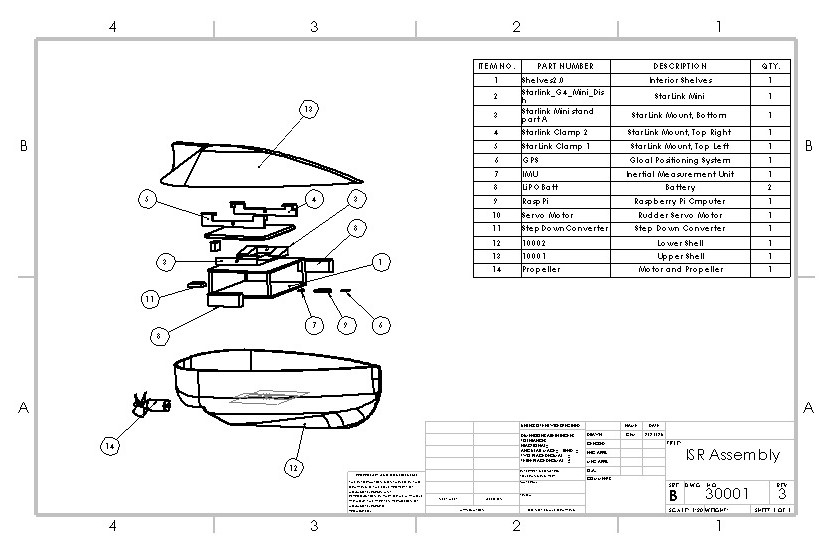
reference/BoatWithElectronicsDrawingJPEG.JPG
