JRL000/AQUABOTS/reference/BottomAssem.JPG

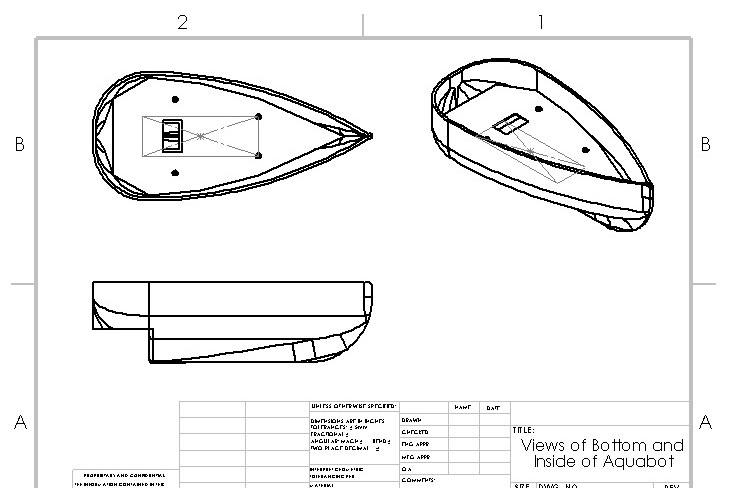
reference/BottomAssem.JPG
