JRL000/AQUABOTS/reference/BottomShell2.2TDPdrwg.JPG

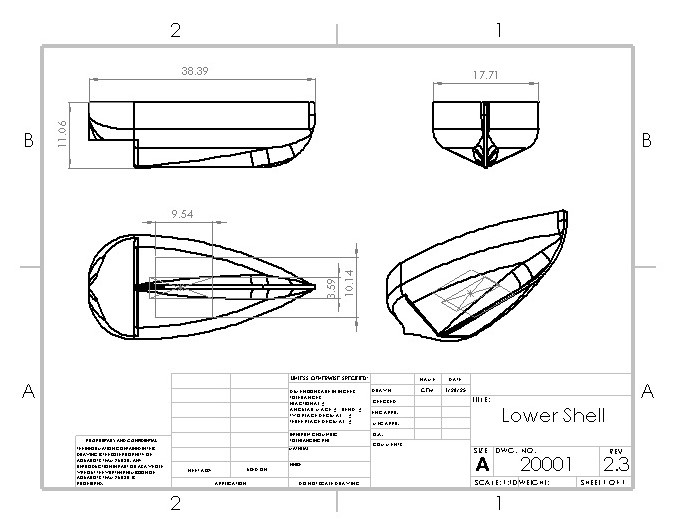
reference/BottomShell2.2TDPdrwg.JPG
