JRL000/AQUABOTS/reference/ground_station_folder/graphics/GPSB.png

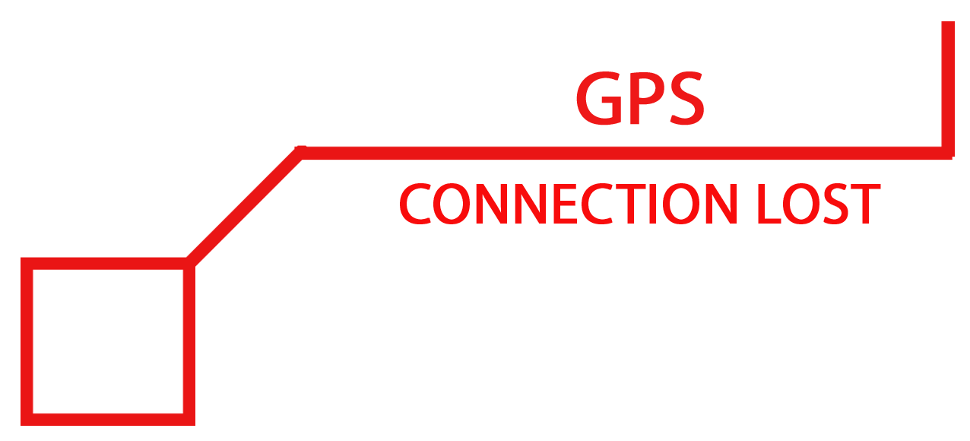
reference/ground_station_folder/graphics/GPSB.png
