JRL000/AQUABOTS/reference/ground_station_folder/graphics/TempG.png

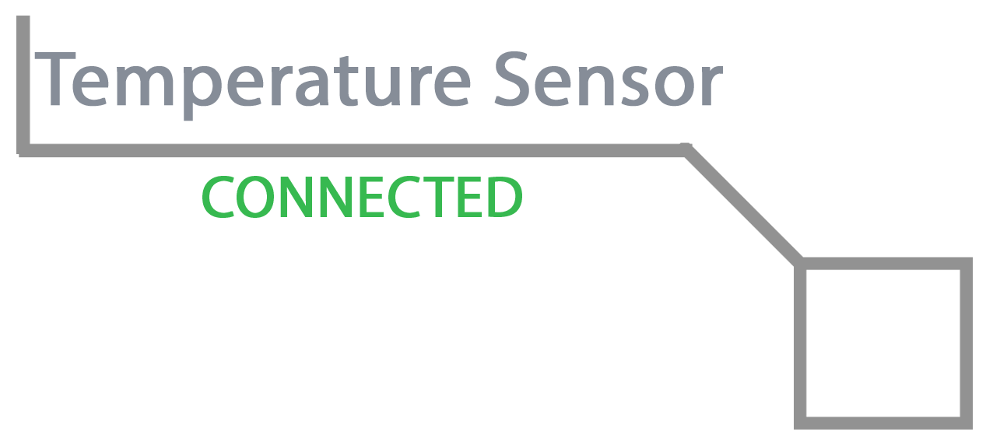
reference/ground_station_folder/graphics/TempG.png
