JRL000/AQUABOTS/reference/Upper shell.JPG

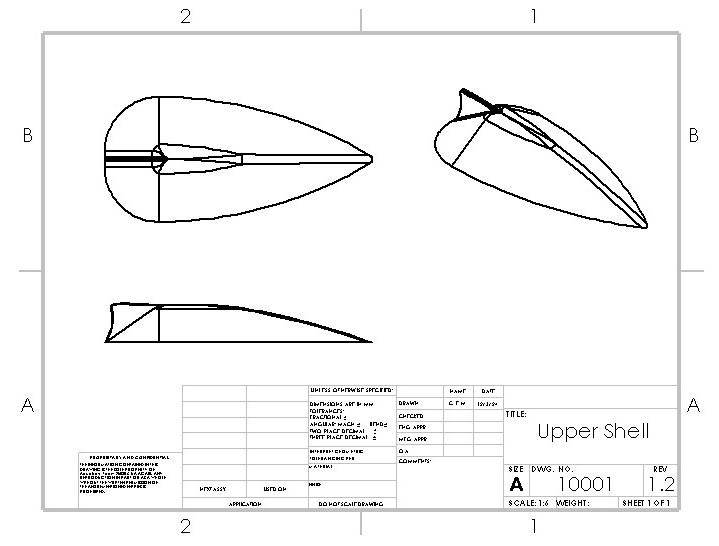
reference/Upper shell.JPG
