JRL000/AQUABOTS/TopShell1.2TDPdrwg.JPG

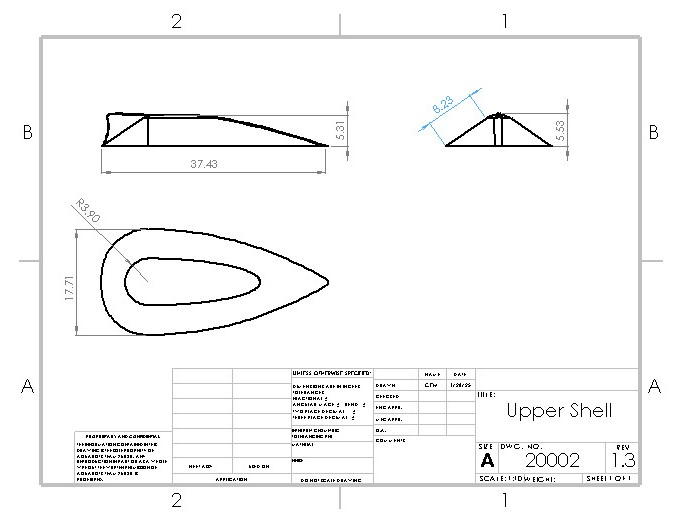
TopShell1.2TDPdrwg.JPG
