JRL000/AQUABOTS/docs/FAR/FAR_comms_v2.xlsx

Requirement | Parameter | Value | Notes / Source
5.3.1 Survivability | Bench packet loss (comms loopback) | 0 % | Calm-conditions telemetry + command loopback
5.4.2 Inter-Drone Comms | ESP-NOW PHY | 2.4 GHz Wi-Fi, channel 1 | TRANSPORT_CHANNEL in swarm_transport.h
 | ESP-NOW max payload | 200 B (250 B cap − header) | swarm_protocol.h
 | HELLO beacon / peer-timeout | 2.0 s / 10.0 s | membership.h
 | Peer-discovery time | < 5 s | ISR Wk-6 bench test
6.4.2 Inter-Drone Comms | Measured RTT (bench) | < 5 ms | ISR Wk-6 test log
 | Measured RSSI (close range bench) | −16 to −24 dBm | ISR Wk-6 test log
5.4.3 Data Relay | Pixhawk TELEM ↔ Jetson | 57600 baud (/dev/ttyTHS1) | MAVLink 1/2
 | MAVProxy UDP fan-out | 14550 / 14552 / 14553 | QGC / GUI app / diagnostics
 | Pixhawk msg types consumed | 7 | HEARTBEAT, GLOBAL_POSITION_INT, ATTITUDE, VFR_HUD, STATUSTEXT, MISSION_CURRENT, HOME_POSITION
 | Sensor-bridge link | USB 115200 baud, 3.0 s cadence CSV | ESP32-S3 → Jetson /dev/ttyCH341USB0
5.4.4 Satellite Uplink | Remote-access path | Tailscale VPN over Starlink Mini | Endpoint 100.67.1.26 confirmed Ireland → Tucson, 04/03/2026
 | Starlink DC input range | 12–48 V direct (no converter) | 22.2 V demo & 25.6 V prod both in-range
5.4.5 Display | Video source resolution / framerate | 1280 × 720 @ 60 fps | IMX219 CSI via nvarguscamerasrc
 | Video WebRTC transport | 640 × 480 @ 30 fps | Downscaled in GStreamer before aiortc
 | End-to-end video latency | < 30 ms | Ireland → Tucson, 04/03/2026 demo
 | GUI service ports | 8765 / 8766 / 8770 | Signaling / telemetry / control; Flask + WebSocket
5.4.6 Swarm Control | Swarm state message rate | TDMA 50 ms slot / 1.0 s beacon | Meets SRD ≥ 1 Hz; leader_election.h
 | Max swarm members | 50 nodes | membership.h
