JRL000/AQUABOTS/Assemblies/BoatWithElectronics.SLDASM

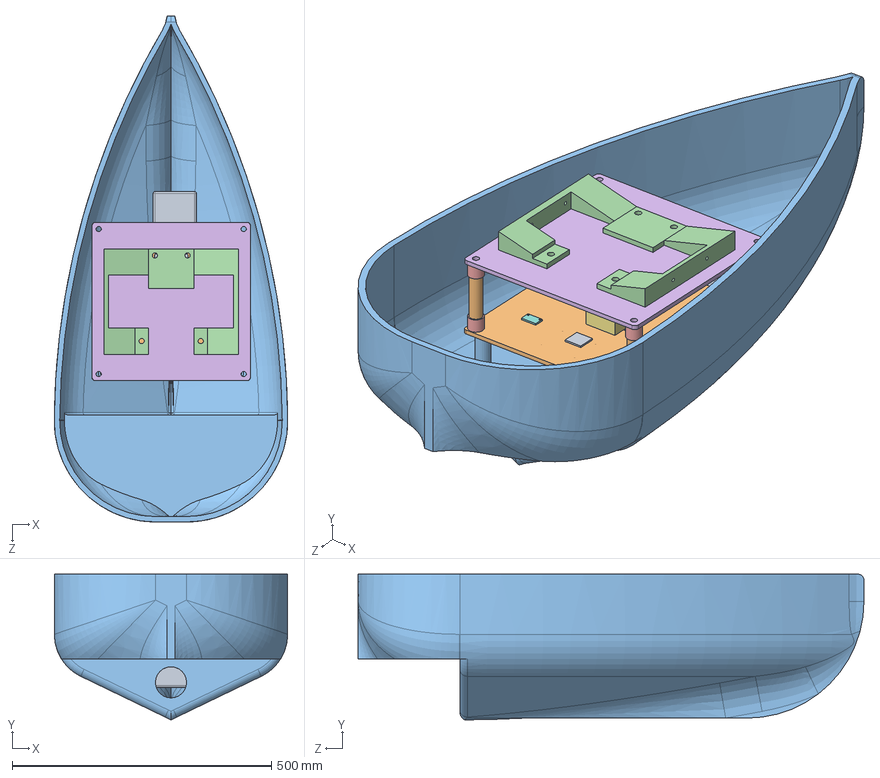
[picture p70: CAD file, 2025-05-07]
Assemblies/BoatWithElectronics.SLDASM
449.9 x 281.0 x 975.0 mm
BottomShell2.2
BottomShelf3.1
GPS
IMU x 2
LiPOBatt
ShelfSupportEndCaps x 8
Starlink Mini stand part A
StepDownConverter x 2
SupportColumns x 4
Battery2
