JRL000/AQUABOTS/Assemblies/Starlink Mini stand part B.SLDPRT

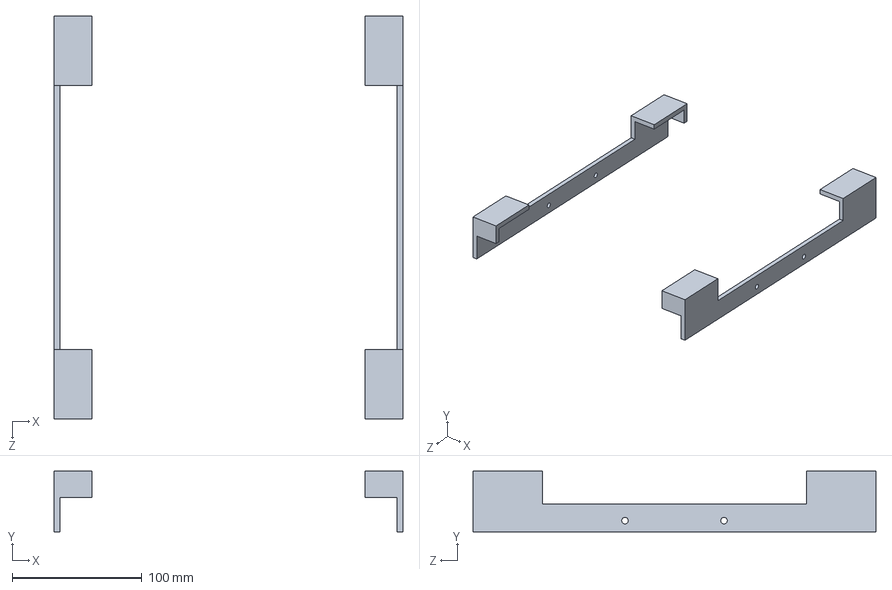
[picture p71: CAD file, 2025-05-07]
Assemblies/Starlink Mini stand part B.SLDPRT
268.6 x 46.7 x 309.9 mm
