JRL000/AQUABOTS/reference/cmauldin_topShelf.DXF

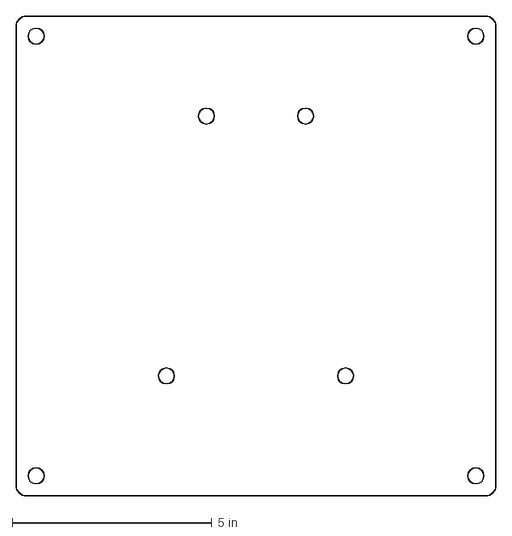
[picture p72: CAD file, 2026-02-26]
reference/cmauldin_topShelf.DXF
12.0 x 12.0 in
