JRL000/AQUABOTS/reference/Shelf Parts/ShelfSupportEndCaps.SLDPRT

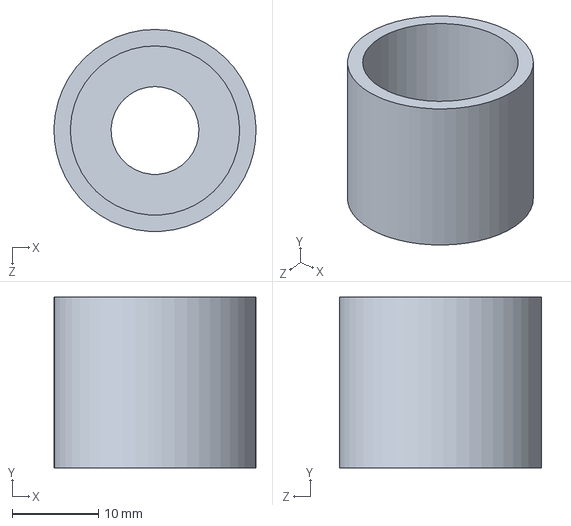
[picture p73: CAD file, 2026-02-26]
reference/Shelf Parts/ShelfSupportEndCaps.SLDPRT
23.4 x 19.8 x 23.4 mm
