JRL000/AQUABOTS/Shelf Parts/SupportColumns.SLDPRT

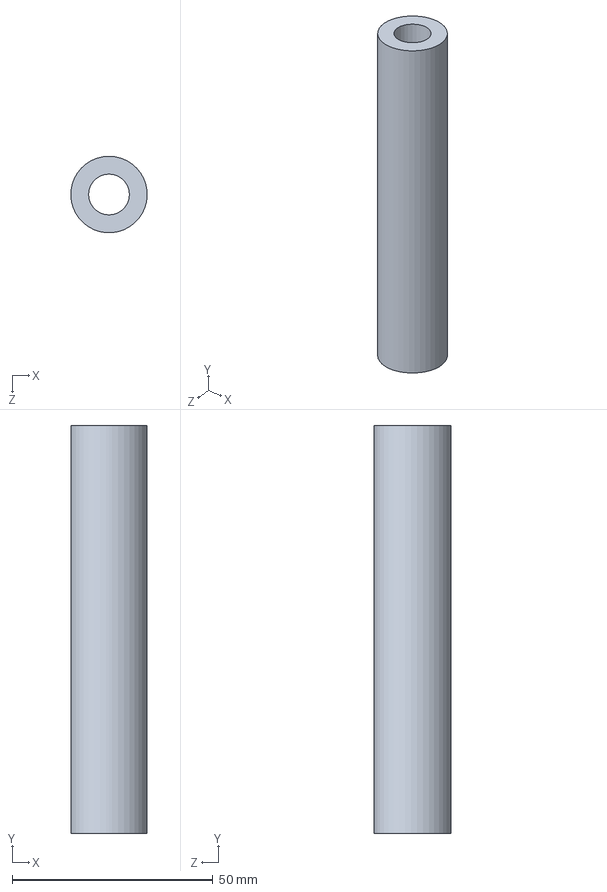
[picture p74: CAD file, 2025-05-07]
Shelf Parts/SupportColumns.SLDPRT
19.0 x 101.6 x 19.1 mm
