JRL000/AQUABOTS/Starlink Mini stand 1.2.3mf

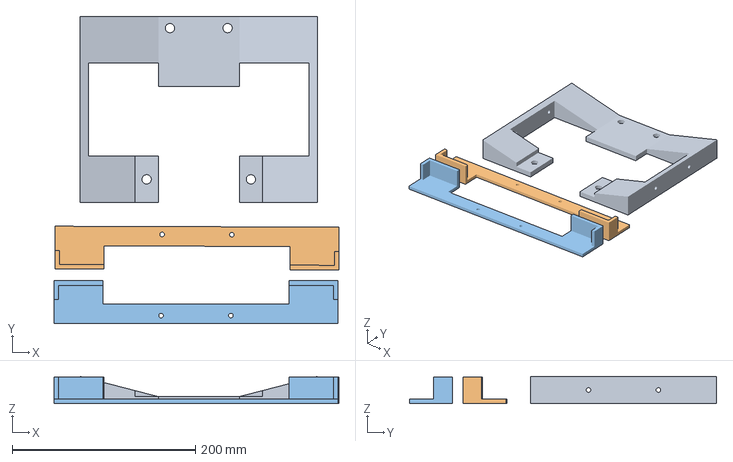
[picture p75: CAD file, 2025-05-07]
Starlink Mini stand 1.2.3mf
311.1 x 335.2 x 29.7 mm
Starlink Mini stand part A 1.2.STL
Starlink Mini stand part B 1.2.STL x 2
