JRL000/AQUABOTS/reference/cmauldin_BottomShelf3.1_corrected.DXF

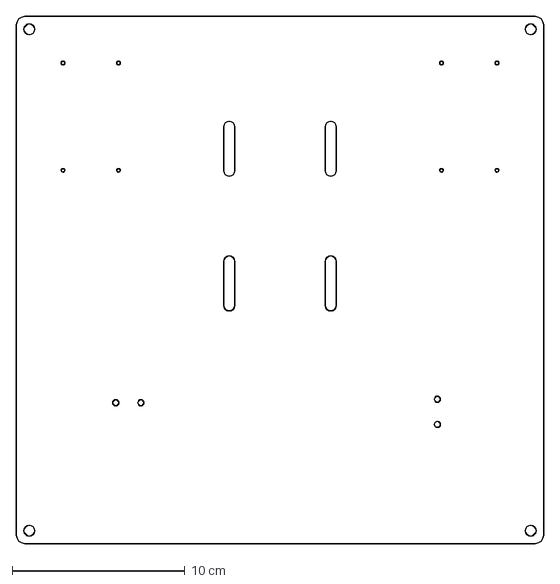
[picture p76: CAD file, 2026-02-26]
reference/cmauldin_BottomShelf3.1_corrected.DXF
30.5 x 30.5 cm
