JRL000/AQUABOTS/reference/Shelf Parts/BottomShelf3.1.SLDPRT

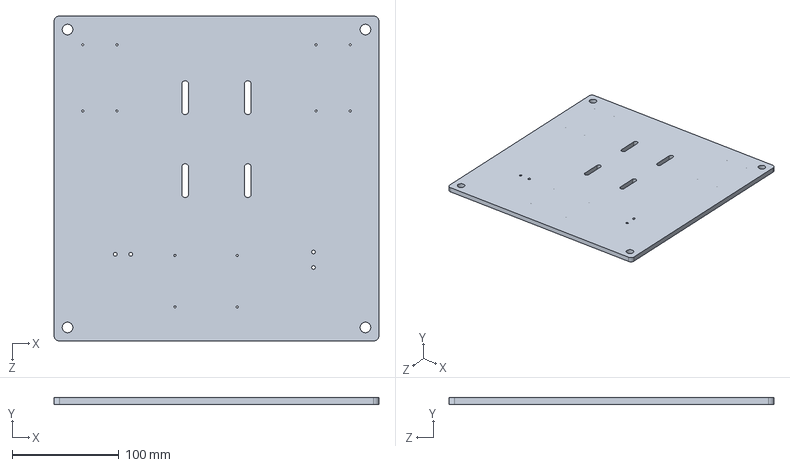
[picture p77: CAD file, 2026-02-26]
reference/Shelf Parts/BottomShelf3.1.SLDPRT
304.8 x 6.35 x 304.8 mm
