JRL000/AQUABOTS/Shelves2.0.SLDPRT

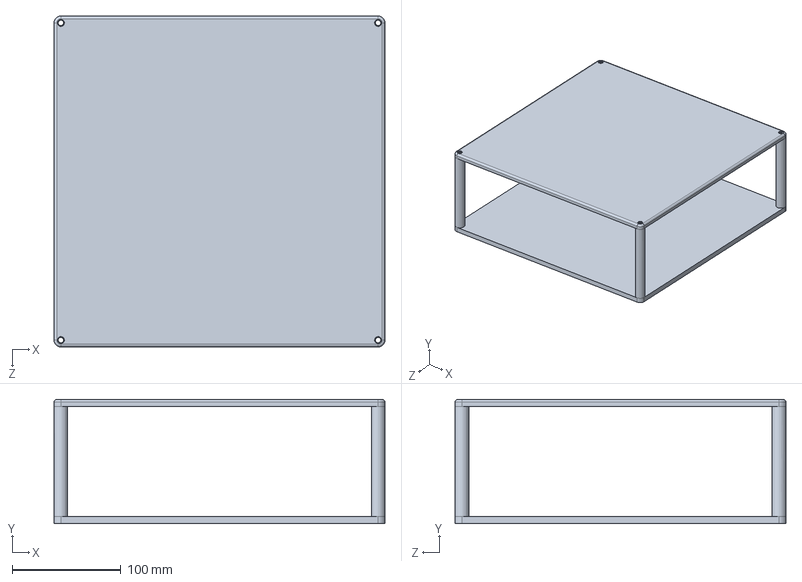
[picture p78: CAD file, 2025-05-07]
Shelves2.0.SLDPRT
304.8 x 114.3 x 304.8 mm
