JRL000/AQUABOTS/reference/Battery2.SLDPRT

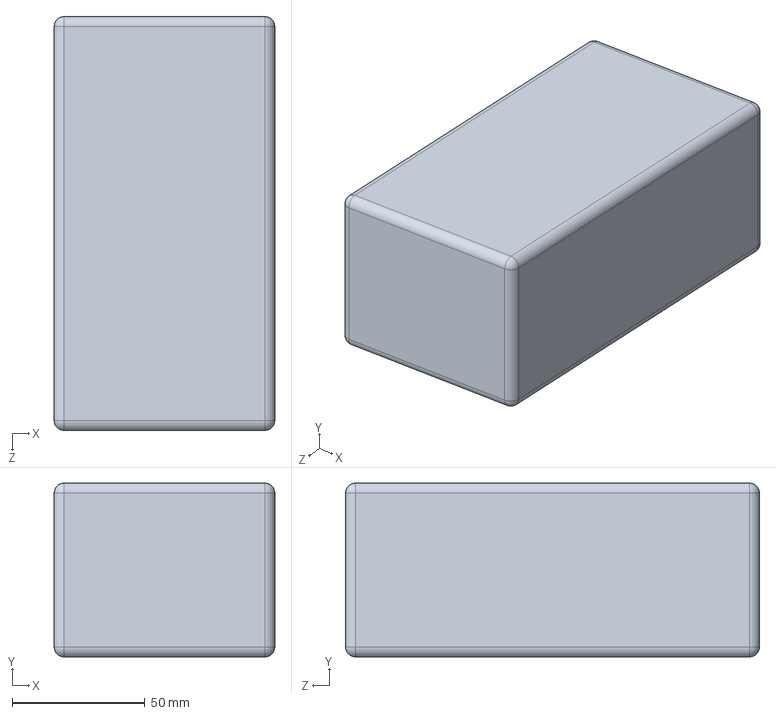
[picture p79: CAD file, 2026-02-26]
reference/Battery2.SLDPRT
83.2 x 65.5 x 156.0 mm
