JRL000/AQUABOTS/Shelf Parts/IMU.SLDPRT

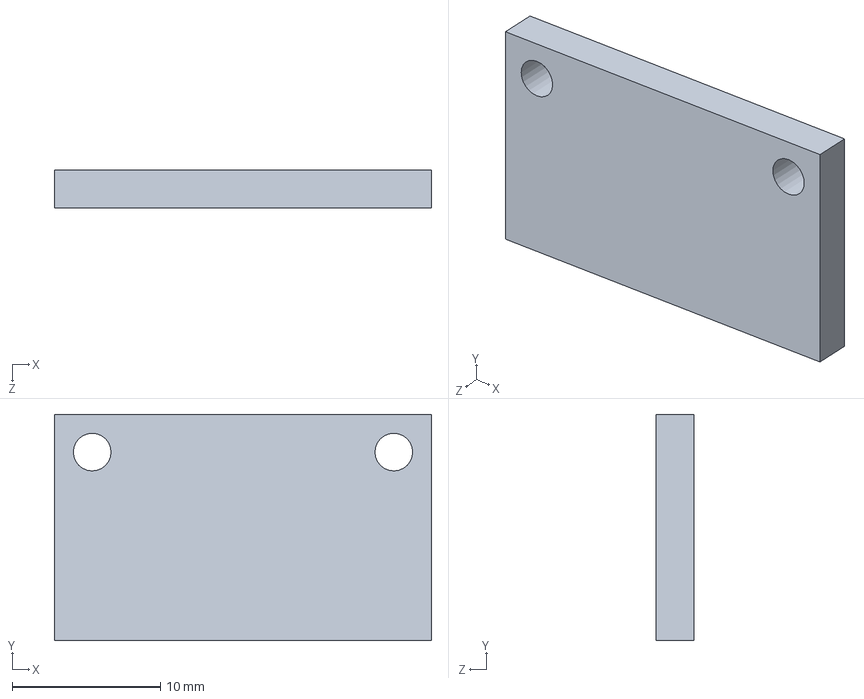
[picture p80: CAD file, 2025-05-07]
Shelf Parts/IMU.SLDPRT
25.4 x 15.2 x 2.54 mm
