JRL000/AQUABOTS/ShelfSupportEndCaps.3mf

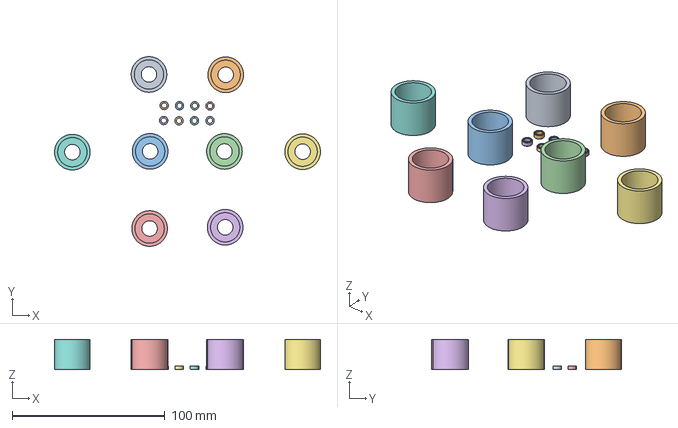
[picture p81: CAD file, 2025-05-07]
ShelfSupportEndCaps.3mf
174.2 x 124.2 x 19.8 mm
ShelfSupportEndCaps.STL x 8
TPUBushing.STL x 8
