JRL000/AQUABOTS/reference/cmauldin_BottomShelf3.1_recut.DXF

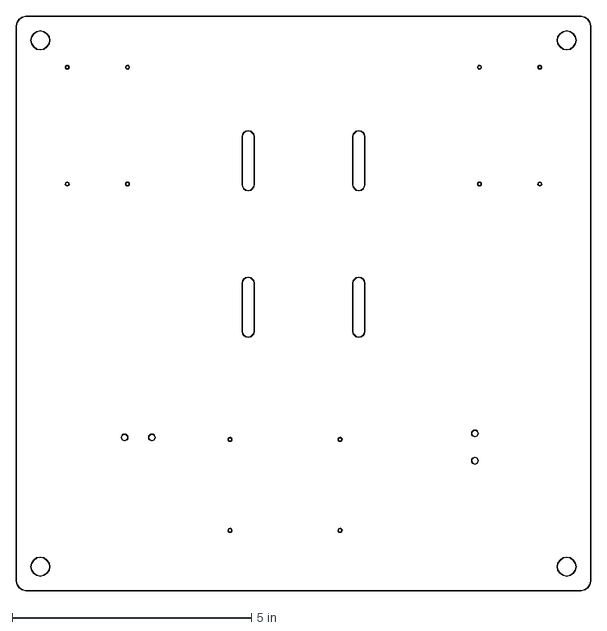
[picture p82: CAD file, 2026-02-26]
reference/cmauldin_BottomShelf3.1_recut.DXF
12.0 x 12.0 in
