JRL000/AQUABOTS/reference/Shelf Parts/GPS.SLDPRT

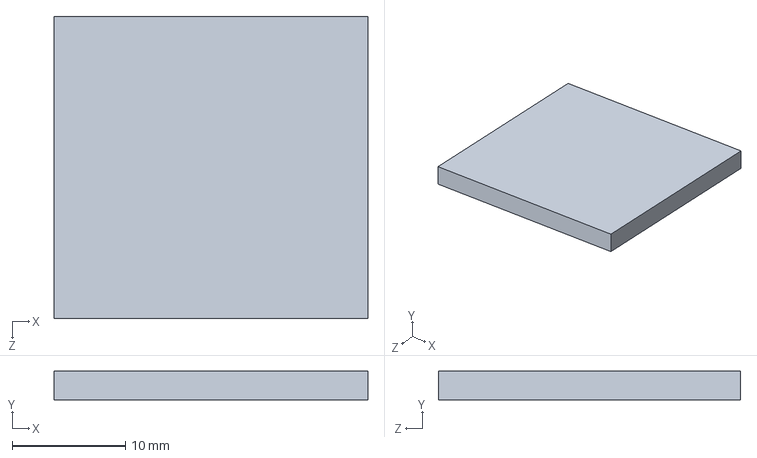
[picture p83: CAD file, 2026-02-26]
reference/Shelf Parts/GPS.SLDPRT
27.7 x 2.54 x 26.7 mm
