JRL000/AQUABOTS/Rudder_V1_NACA0012.SLDPRT

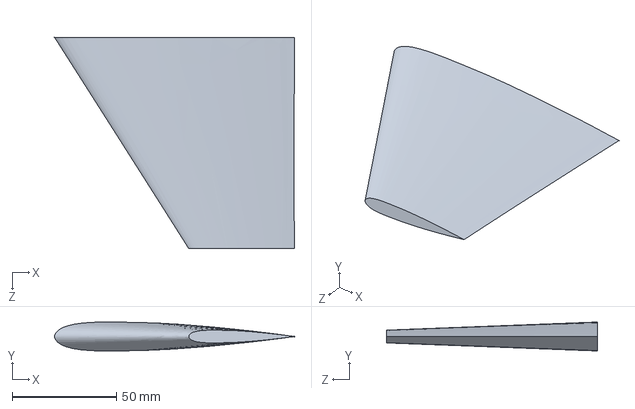
[picture p84: CAD file, 2025-05-07]
Rudder_V1_NACA0012.SLDPRT
115.3 x 13.9 x 101.6 mm
