JRL000/AQUABOTS/Shelf Parts/Starlink Mini stand part A.SLDPRT

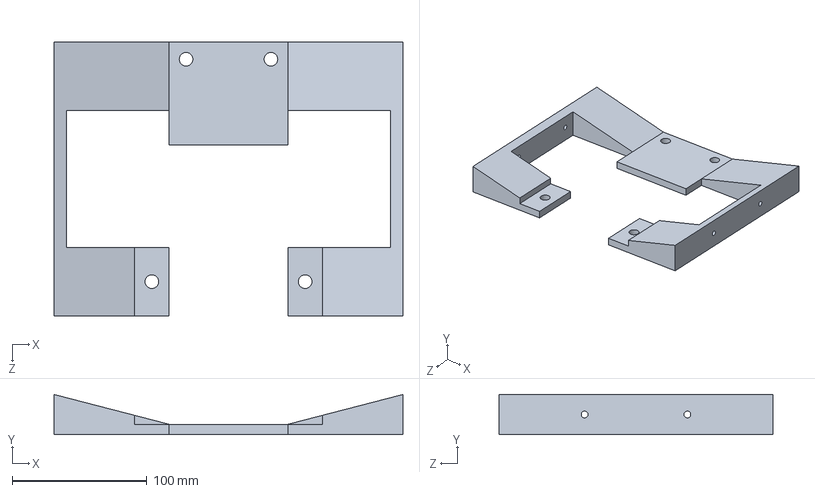
[picture p85: CAD file, 2025-05-07]
Shelf Parts/Starlink Mini stand part A.SLDPRT
259.1 x 29.7 x 203.2 mm
