JRL000/AQUABOTS/reference/Shelf Parts/StepDownConverter.SLDPRT

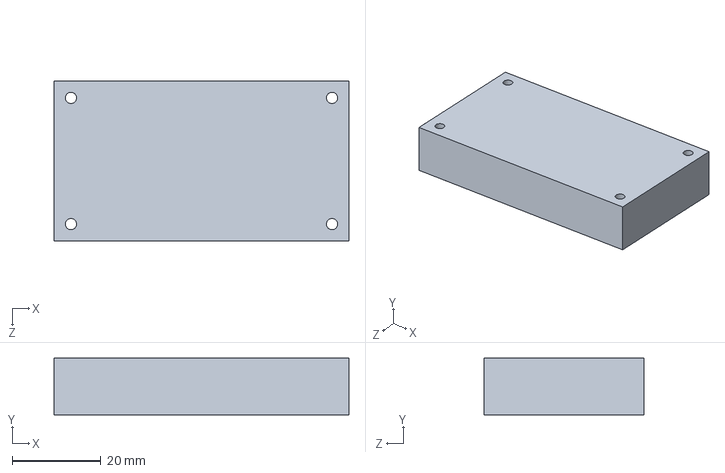
[picture p86: CAD file, 2026-02-26]
reference/Shelf Parts/StepDownConverter.SLDPRT
66.3 x 12.7 x 36.0 mm
