JRL000/AQUABOTS/Shelf Parts/LiPOBatt.SLDPRT

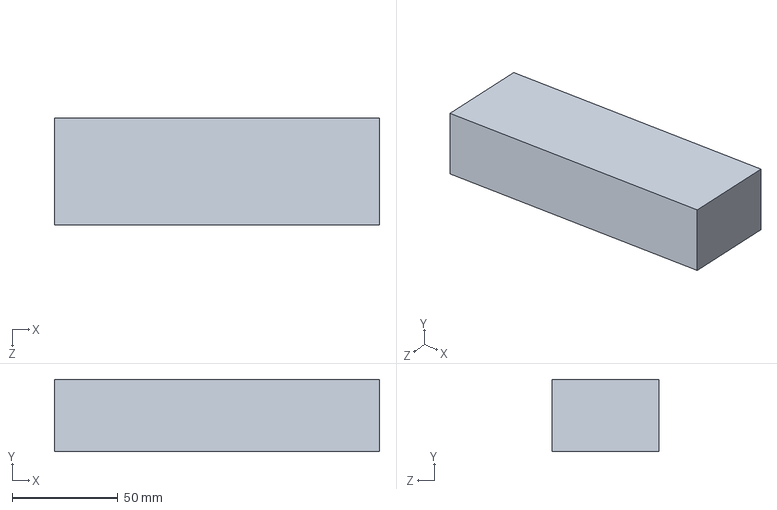
[picture p87: CAD file, 2025-05-07]
Shelf Parts/LiPOBatt.SLDPRT
153.9 x 34.3 x 50.8 mm
