JRL000/AQUABOTS/ShelfSupportEndCaps_Reprint.3mf

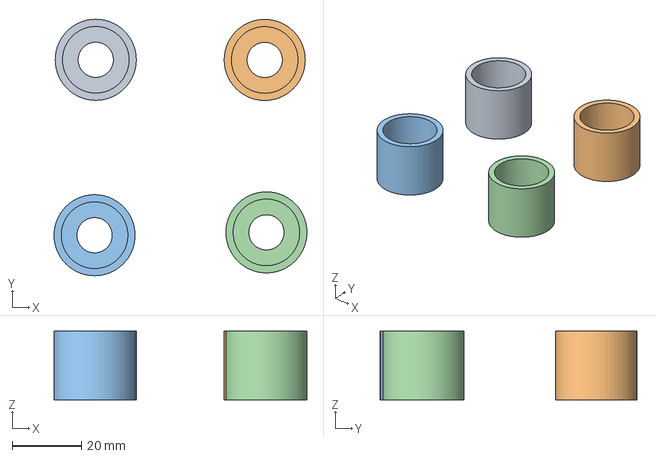
[picture p88: CAD file, 2025-05-07]
ShelfSupportEndCaps_Reprint.3mf
72.9 x 73.9 x 19.8 mm
ShelfSupportEndCaps.STL x 4
