JRL000/AQUABOTS/reference/Vertical Supports.SLDPRT

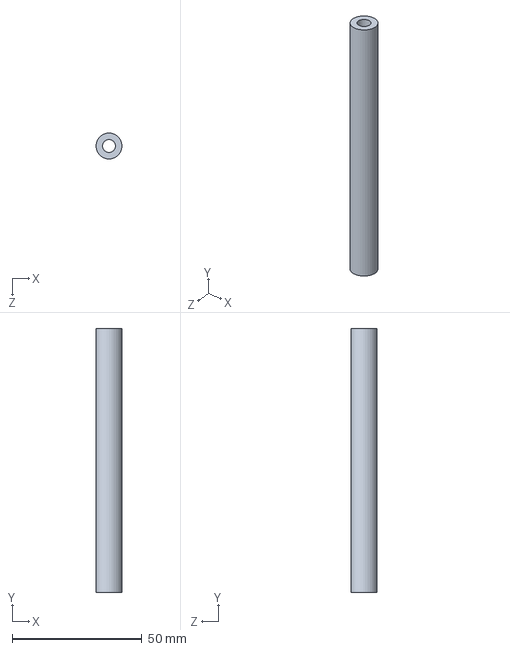
[picture p89: CAD file, 2026-02-26]
reference/Vertical Supports.SLDPRT
9.96 x 101.6 x 10.0 mm
