JRL000/AQUABOTS/Shelf_Spacer.3mf

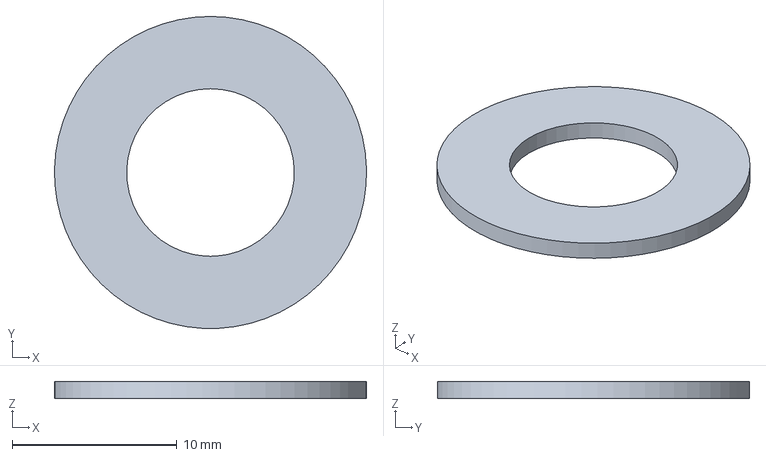
[picture p90: CAD file, 2025-05-07]
Shelf_Spacer.3mf
18.9 x 18.9 x 1.05 mm
