JRL000/AQUABOTS/Starlink Mini stand part B.STL

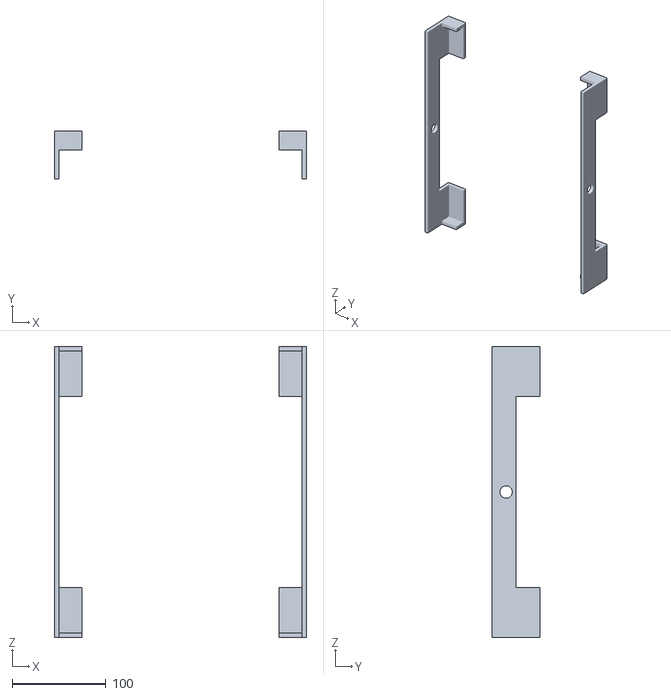
[picture p91: CAD file, 2025-05-07]
Starlink Mini stand part B.STL
268.6 x 50.8 x 309.9
