JRL000/AQUABOTS/Motor Mock.SLDPRT

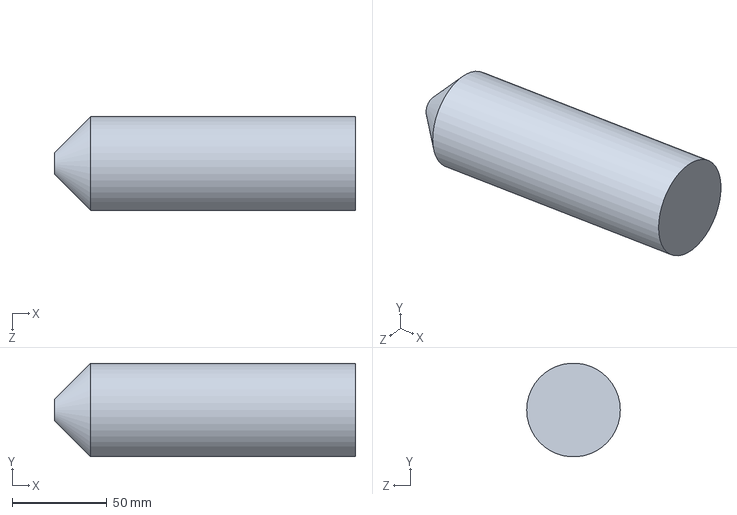
[picture p92: CAD file, 2025-05-07]
Motor Mock.SLDPRT
159.1 x 49.4 x 49.5 mm
