JRL000/AQUABOTS/reference/TPUBushing.STL

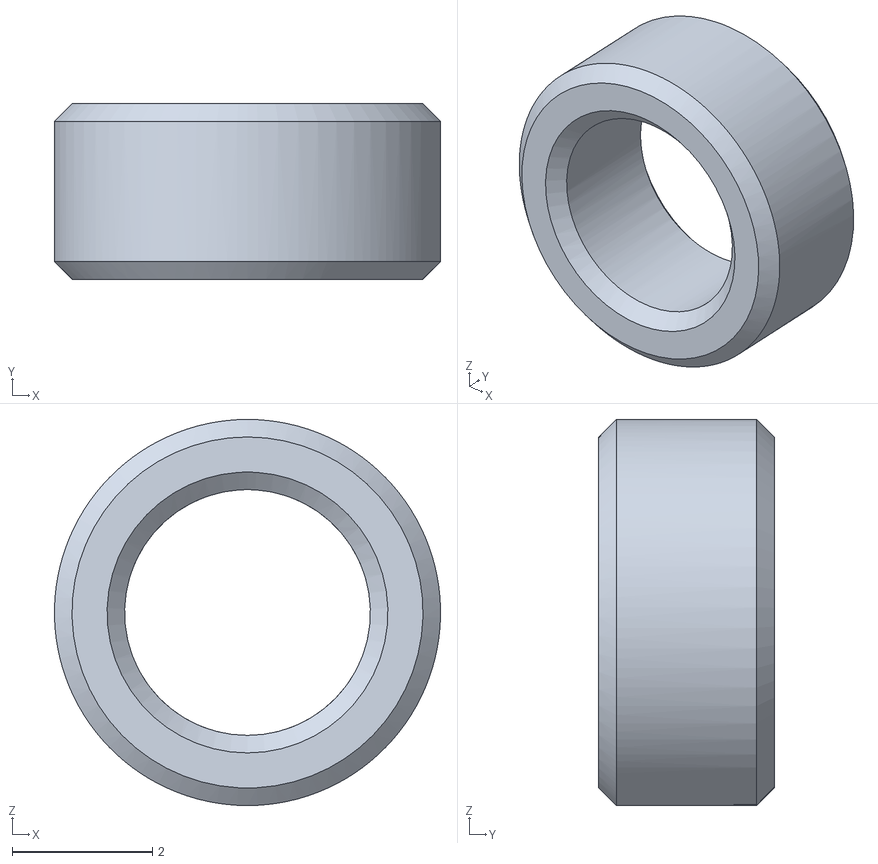
[picture p93: CAD file, 2026-02-26]
reference/TPUBushing.STL
5.50 x 2.50 x 5.50
