JRL000/AQUABOTS/cmauldin_topShelf.DXF

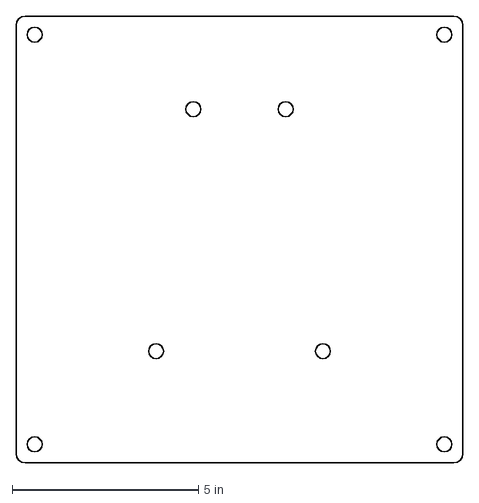
[picture p94: CAD file, 2025-05-07]
cmauldin_topShelf.DXF
12.0 x 12.0 in
