JRL000/AQUABOTS/BottomShelf3.1.DXF

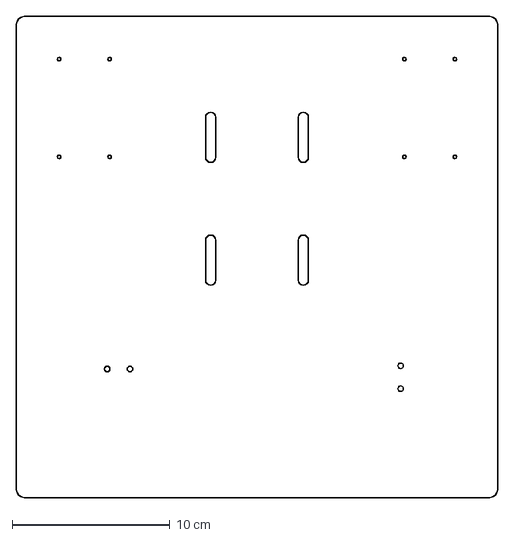
[picture p95: CAD file, 2025-05-07]
BottomShelf3.1.DXF
30.5 x 30.5 cm
