JRL000/AQUABOTS/cmauldin_BottomShelf3.1_corrected.DXF

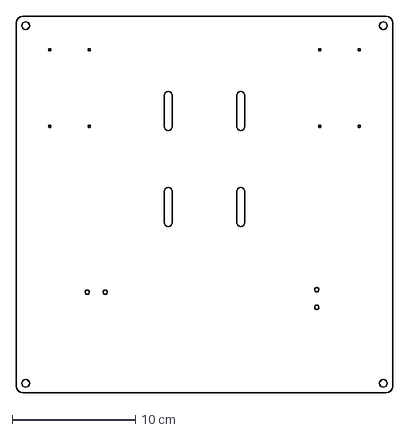
[picture p96: CAD file, 2025-05-07]
cmauldin_BottomShelf3.1_corrected.DXF
30.5 x 30.5 cm
