JRL000/AQUABOTS/cmauldin_BottomShelf3.1_recut.DXF

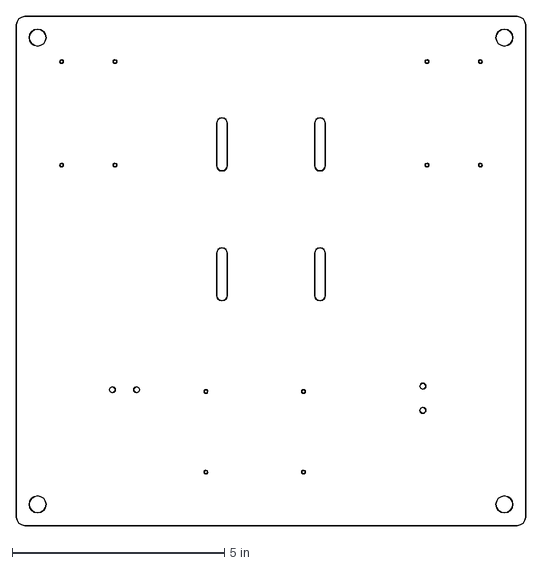
[picture p97: CAD file, 2025-05-07]
cmauldin_BottomShelf3.1_recut.DXF
12.0 x 12.0 in
