JRL000/AQUABOTS/BottomShell2.2.SLDPRT

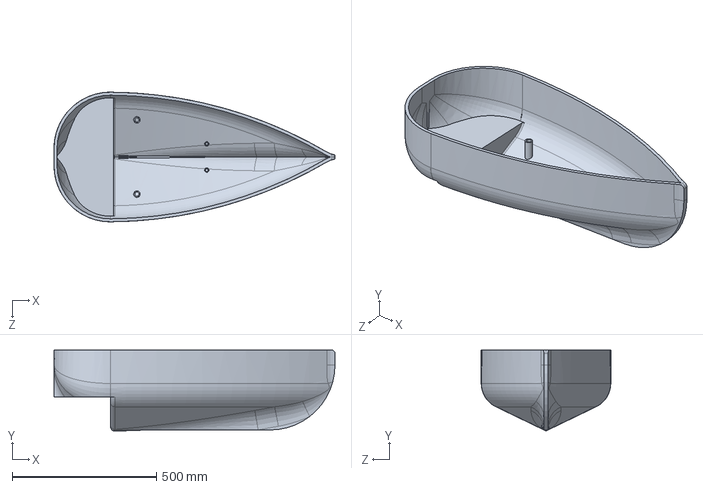
[picture p98: CAD file, 2025-05-07]
BottomShell2.2.SLDPRT
975.0 x 281.0 x 449.9 mm
