JRL000/AQUABOTS/reference/Shelf Parts/Starlink Mount Assem.SLDASM

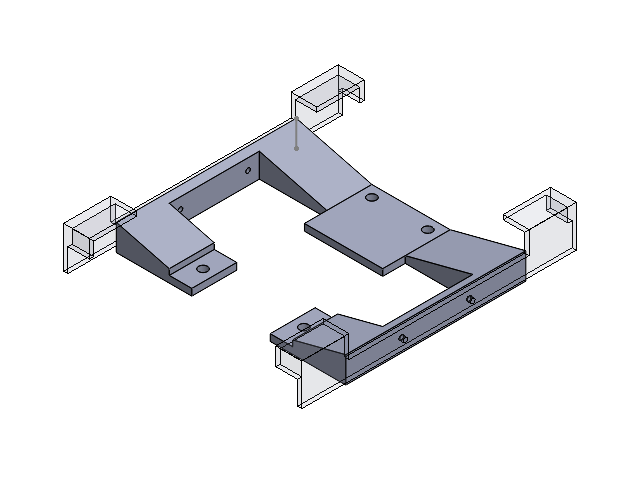
[picture p99: CAD file, 2026-02-26]
reference/Shelf Parts/Starlink Mount Assem.SLDASM
Starlink Mini stand part A
Starlink Mini stand part B 1.2
