JRL000/AQUABOTS/reference/Assem2.SLDASM

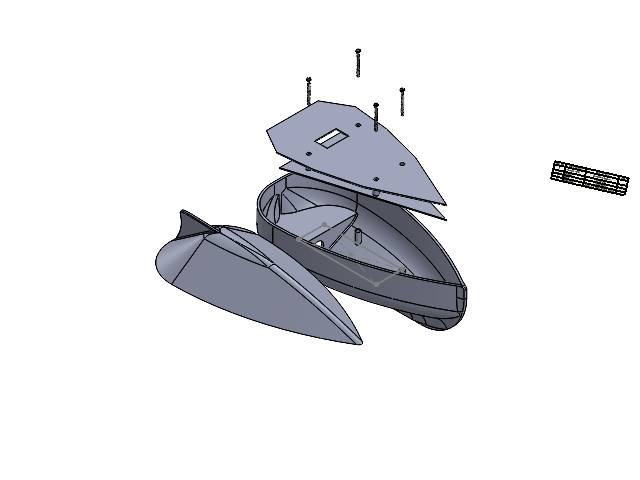
[picture p100: CAD file, 2026-02-26]
reference/Assem2.SLDASM
Aquabot Upper Shelf
92005A452_Steel Pan Head Phillips Screw x 4
