JRL000/AQUABOTS/Shelf Assebmly with components.SLDASM

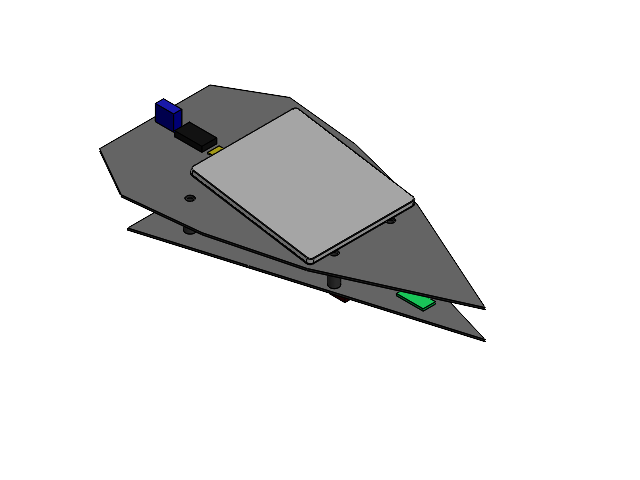
[picture p101: CAD file, 2025-05-07]
Shelf Assebmly with components.SLDASM
Propeller
ESC part A
Starlink_G4_Mini_Dish
ESC part B
RaspPi
Servo Motor
StepDownConverter x 2
IMU
GPS
LiPOBatt x 2
