JRL000/AQUABOTS/Shelves2.0WithStarlinkAndMount.SLDASM

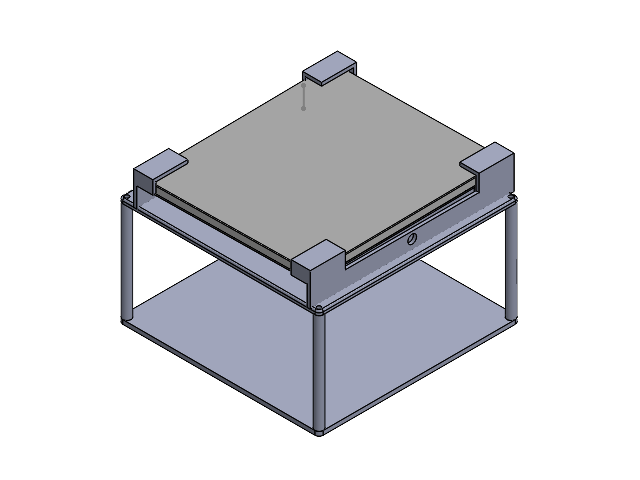
[picture p102: CAD file, 2025-05-07]
Shelves2.0WithStarlinkAndMount.SLDASM
Shelves2.0
Starlink_G4_Mini_Dish
