JRL000/AQUABOTS/BottomAssem.SLDASM

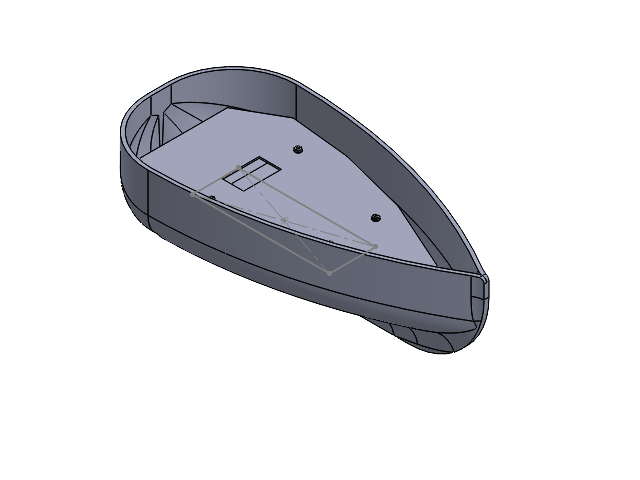
[picture p103: CAD file, 2025-05-07]
BottomAssem.SLDASM
Aquabot Upper Shelf
92005A452_Steel Pan Head Phillips Screw x 4
