JRL000/AQUABOTS/(list of files, cad)

Other CAD files:
Shelf Parts/Part1.SLDPRT
reference/Shelves2.0.STL
reference/Starlink Mini stand part A 1.2.STL
Starlink Mini stand part A.STL
92005A452_Steel Pan Head Phillips Screw.SLDPRT
Assemblies/HullWithShelves.SLDDRW
BottomAssem.SLDDRW
BottomShell2.2.STL
PREVIOUS TEAM/Aquabot Upper Shelf.SLDPRT
PREVIOUS TEAM/Aquabot lower shelf.SLDPRT
PREVIOUS TEAM/Assem2Drawing.SLDDRW
PREVIOUS TEAM/Assemblies/ShelfAssemFinal.SLDASM
PREVIOUS TEAM/Battery3.SLDPRT
PREVIOUS TEAM/BottomShelf3.1.DXF
PREVIOUS TEAM/BottomShell2.2TDPdrwg.SLDDRW
PREVIOUS TEAM/BottomShell2.2_solid.SLDPRT
PREVIOUS TEAM/Shelf Parts/RaspPi.SLDPRT
PREVIOUS TEAM/Shelf Parts/Servo Motor.SLDPRT
PREVIOUS TEAM/Shelf Parts/Shelf_Spacer.SLDPRT
PREVIOUS TEAM/Shelf Parts/Starlink_G4_Mini_Dish.SLDPRT
PREVIOUS TEAM/Shelves1.2.SLDPRT
PREVIOUS TEAM/StarLink Clamp 1.SLDPRT
PREVIOUS TEAM/Starlink Clamp 2.SLDPRT
PREVIOUS TEAM/Starlink Mini stand part A.3mf
PREVIOUS TEAM/Starlink Mini stand part B 1.2.STL
PREVIOUS TEAM/TPUBushing.SLDPRT
PREVIOUS TEAM/TopShell1.2.SLDPRT
PREVIOUS TEAM/TopShell1.2TDPdrwg.SLDDRW
PREVIOUS TEAM/Vertical Supports.STL
Rudder_V1.SLDDRW
ShelfSupportEndCaps.STL
Shelf_Spacer.STL
Shelves.SLDDRW
Shelves2.0.3mf
reference/92005A452_Steel Pan Head Phillips Screw.SLDDRW
reference/Assemblies/BoatWithElectronicsDrawing.SLDDRW
reference/Assemblies/ShelfAssemFinalDrawing.SLDDRW
reference/BottomShelf3.1.SLDDRW
reference/Lower Shell.SLDDRW
reference/Upper shell.SLDDRW
reference/Vertical Supports.3mf
