JRL000/AQUABOTS/docs/field-procedures/EMI_FILTERING_INSTALL_CHECKLIST.md

# MOVED — merged into AQUABOTS_EMI_INSTALL_PROCEDURE.md

This checklist (FAR-1 patched, 2026-04-22) has been merged with the EMI install guide into a single comprehensive procedure for the 2026-04-23 install.

**Current source of truth:** [`../AQUABOTS_EMI_INSTALL_PROCEDURE.md`](../AQUABOTS_EMI_INSTALL_PROCEDURE.md) (Rev FAR-1 / WG-3 unified, 2026-04-26).

The merged procedure preserves the per-section continuity gates, V1–V6 post-install verification, BOM deviations table, and do-not-do list from this checklist, alongside the spec-level placement detail from the install guide. The repo-side PDF (`EMI_FILTERING_INSTALL_CHECKLIST.pdf`) has been deleted; use the merged procedure's PDF instead.
