JRL000/AQUABOTS/John/Firmware/swarmLogic/CLAUDE_CODE_STEP7_HANDOFF.md

# Claude Code Handoff: Step 7 Verification

## Project Context

**Project:** AQUABOTS - ESP32-S3 Swarm Framework for Autonomous Aquatic Drones  
**Platform:** ESP32-S3 with ESP-IDF v5.5.x  
**Protocol:** ESP-NOW (2.4 GHz)  
**Target:** 20-50 node autonomous aquatic drone swarm  
**Current Progress:** Steps 1-6 verified complete, Step 7 code written and ready for verification

This is a distributed swarm coordination framework for autonomous aquatic drones enabling:
- Automatic peer discovery via ESP-NOW
- Distributed leader election (highest node_id wins)
- Synchronized command execution across swarm
- Coordinated formations (line, wedge, circle, column)
- Obstacle detection and sharing (Step 7)
- Collision avoidance (Step 9)

---

## Complete Development Roadmap (9 Steps)

### Completed Steps

| Step | Feature | Status | Description |
|---|---|---|---|
| **1** | Modular Scaffolding | ✅ Complete | 20-file architecture, ESP-NOW transport, ping/ack demo |
| **2** | NVS Node Provisioning | ✅ Complete | Persistent node_id in flash, serial console, single firmware |
| **3** | HELLO/JOIN Membership | ✅ Complete | Auto peer discovery, member table, timeout detection |
| **4** | Leader Election + TDMA | ✅ Complete | Highest ID wins, beacon broadcasts, 50ms time slots |
| **5** | Command Engine | ✅ Complete | GOTO/HOLD/STOP/RESUME, thread-safe, duplicate detection |
| **6** | Formation Control | ✅ Complete | Extensible patterns (line/wedge/circle/column), position assignment |

### Current Step

| Step | Feature | Status | Description |
|---|---|---|---|
| **7** | Obstacle Sensor Scaffolding | 🔄 Code Written | Driver abstraction, mock data, broadcast protocol, path checking |

### Remaining Steps

| Step | Feature | Status | Description |
|---|---|---|---|
| **8** | mmWave Radar Integration | 🔲 Planned | Real LD2450 radar driver, hardware integration, multi-sensor support |
| **9** | Avoidance Policy Tuning | 🔲 Planned | Collision avoidance algorithms, formation-aware avoidance, parameter tuning |

---

## Step 7: Obstacle Sensor Scaffolding

**Status:** Code already written, needs deployment and verification

### What Was Built

1. **Driver abstraction system** - Pluggable sensor drivers via function pointers
2. **Mock driver** - Generates fake obstacle data for testing without hardware
3. **Broadcast protocol** - Nodes share obstacle scans via `MSG_TYPE_OBSTACLE`
4. **Path checking** - `obstacle_sense_path_clear()` checks if direction is blocked
5. **Swarm-wide fusion** - Collects scans from all nodes, finds closest obstacle
6. **Console commands** - 5 new commands for testing

### Files Provided (already written)

| File | Action | Description |
|---|---|---|
| `obstacle_sense.h` | Replace stub | Full header with driver API (~200 lines) |
| `obstacle_sense.c` | Replace stub | Full implementation (~650 lines) |
| `main.c` | Replace | Updated with obstacle callbacks and start |
| `swarm_protocol_step7.h` | Reference | Add `MSG_TYPE_OBSTACLE = 0x07` to swarm_protocol.h |

### Console Commands Added

```
sensors              - Show sensor status
detections           - Show all detected obstacles (local + remote)
mock_add <r> <b>     - Add mock obstacle (range_mm, bearing_deg)
mock_clear           - Clear all mock obstacles
path_check <bearing> - Check if path is clear in direction
```

---

## Your Task

Help the user:

1. **Deploy the Step 7 code** to their ESP32-S3 boards
2. **Add `MSG_TYPE_OBSTACLE = 0x07`** to their existing `swarm_protocol.h`
3. **Build and flash** both nodes
4. **Run verification tests** (see below)
5. **Confirm all tests pass**

---

## Verification Requirements

### Test 1: Sensor Status
```bash
swarm> sensors
```
**Expected:**
- Driver registered: YES
- Running: YES
- Mock mode: ENABLED
- Scan count: incrementing

### Test 2: Mock Obstacles
```bash
swarm> mock_add 2000 0       # 2m straight ahead
swarm> mock_add 1500 45      # 1.5m at 45°
swarm> mock_add 3000 -30     # 3m at -30°
swarm> detections
```
**Expected:**
- Shows 3 obstacles with correct range/bearing
- Log shows: "LOCAL SCAN: 3 obstacles detected"

### Test 3: Remote Scan Reception
On Node 1 (follower):
```bash
swarm> detections
```
**Expected:**
- Shows Node 2's obstacles as "(remote)"
- Log shows: "REMOTE SCAN from node 2: 3 obstacles"

### Test 4: Path Checking
```bash
swarm> path_check 0          # Check straight ahead
swarm> path_check 90         # Check 90° (should be clear)
swarm> path_check 45         # Check 45° (should be blocked)
```
**Expected:**
- 0°: BLOCKED (obstacle at 2000mm @ 0°)
- 90°: CLEAR (no obstacles in that corridor)
- 45°: BLOCKED (obstacle at 1500mm @ 45°)

### Test 5: Clear Mock Data
```bash
swarm> mock_clear
swarm> detections
```
**Expected:**
- "Mock obstacles cleared"
- No obstacles detected

### Test 6: Previous Features Still Work
```bash
swarm> members           # Should show peer
swarm> leader            # Should show correct leader
swarm> formation line    # Should work (on leader)
swarm> fstatus           # Should show formation
```

---

## Success Criteria

All tests pass:
- [ ] `sensors` shows correct status
- [ ] `mock_add` creates detectable obstacles
- [ ] Local scans broadcast to swarm
- [ ] Remote scans received and displayed
- [ ] `path_check` correctly identifies blocked paths
- [ ] `mock_clear` removes obstacles
- [ ] Steps 1-6 features still functional

---

## Hardware Setup

- 2x ESP32-S3 development boards
- Node 1: Lower node_id (follower)
- Node 2: Higher node_id (leader)
- Both provisioned and previously tested with Steps 1-6

---

## Next Steps After Verification

### Step 8: mmWave Radar Integration
- Implement LD2450 UART driver (recommended sensor: Hi-Link LD2450, ~$15)
- Replace mock driver with real hardware driver
- 24 GHz radar penetrates fiberglass hull (internal mounting)
- Multi-sensor support for 360° coverage

### Step 9: Avoidance Policy Tuning
- Implement collision avoidance algorithms
- Formation-aware avoidance (maintain formation while avoiding)
- Dynamic path replanning
- Safety threshold tuning

---

## Notes

- The code uses mock mode by default (no real sensor hardware needed for Step 7)
- Scans occur at 10 Hz locally, broadcast at 2 Hz to swarm
- Remote scans timeout after 2 seconds if not refreshed
- Driver abstraction allows easy swap from mock → real hardware in Step 8
