JRL000/AQUABOTS/Assemblies/ShelfAssemFinalDrawing.JPG

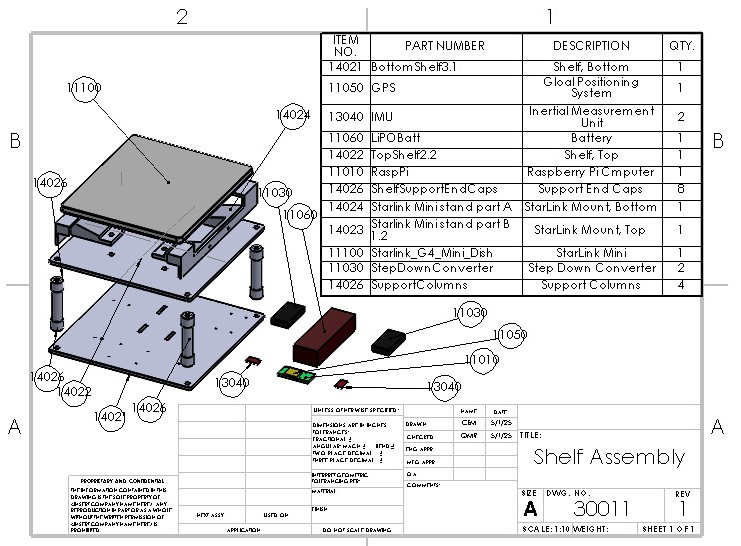
Assemblies/ShelfAssemFinalDrawing.JPG
