JRL000/AQUABOTS/docs/pics/Step6.FormationImplementation.Success.3.png

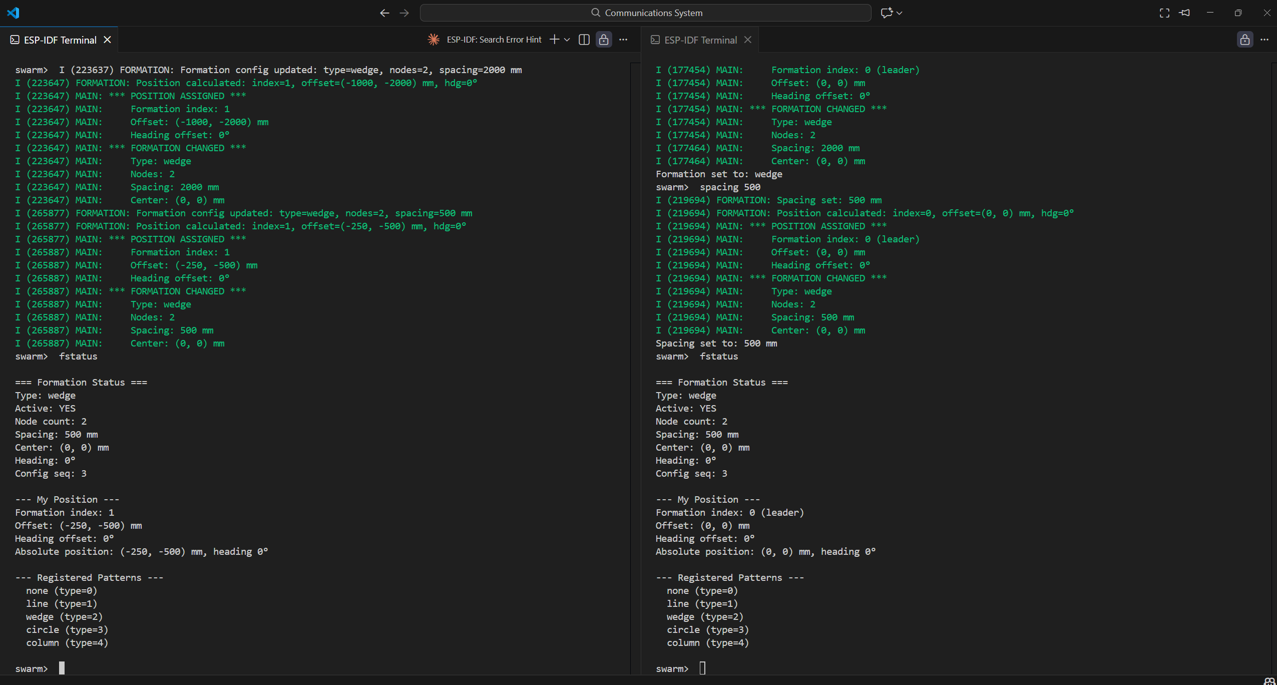
docs/pics/Step6.FormationImplementation.Success.3.png
