JRL000/AQUABOTS/docs/wiring/1_aquabots_wiring_diagram.png

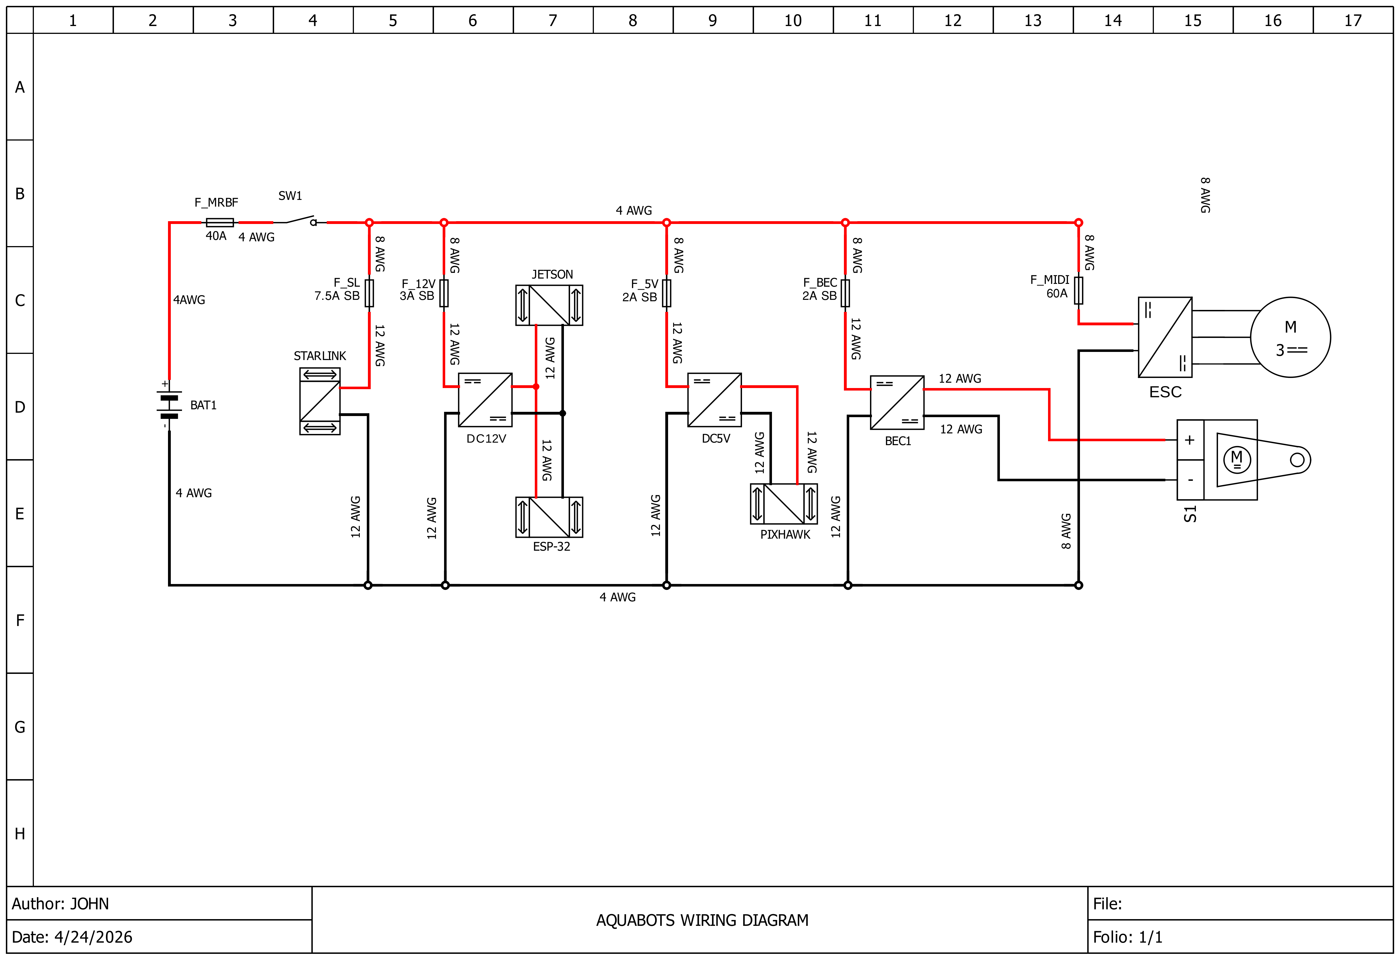
docs/wiring/1_aquabots_wiring_diagram.png
