JRL000/AQUABOTS/John/Pics/6.testing.png

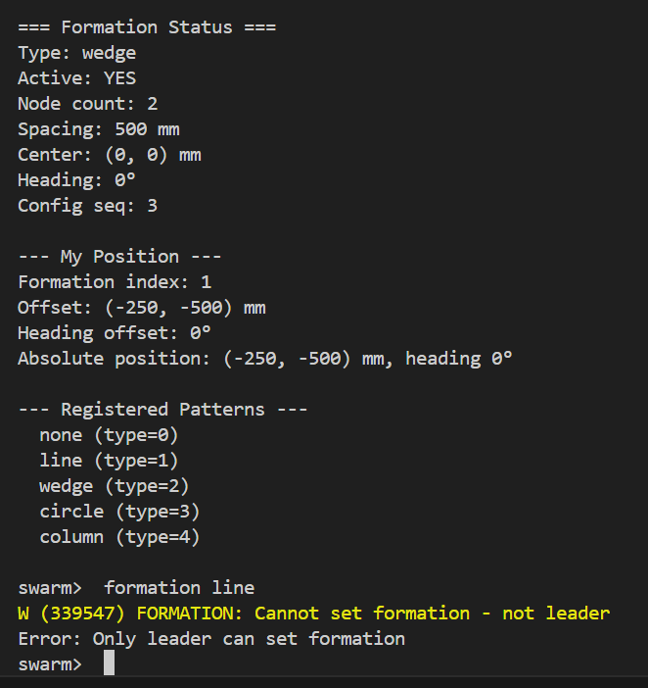
John/Pics/6.testing.png
