JRL000/AQUABOTS/BoatWithElectronicsDrawingPDF.PDF

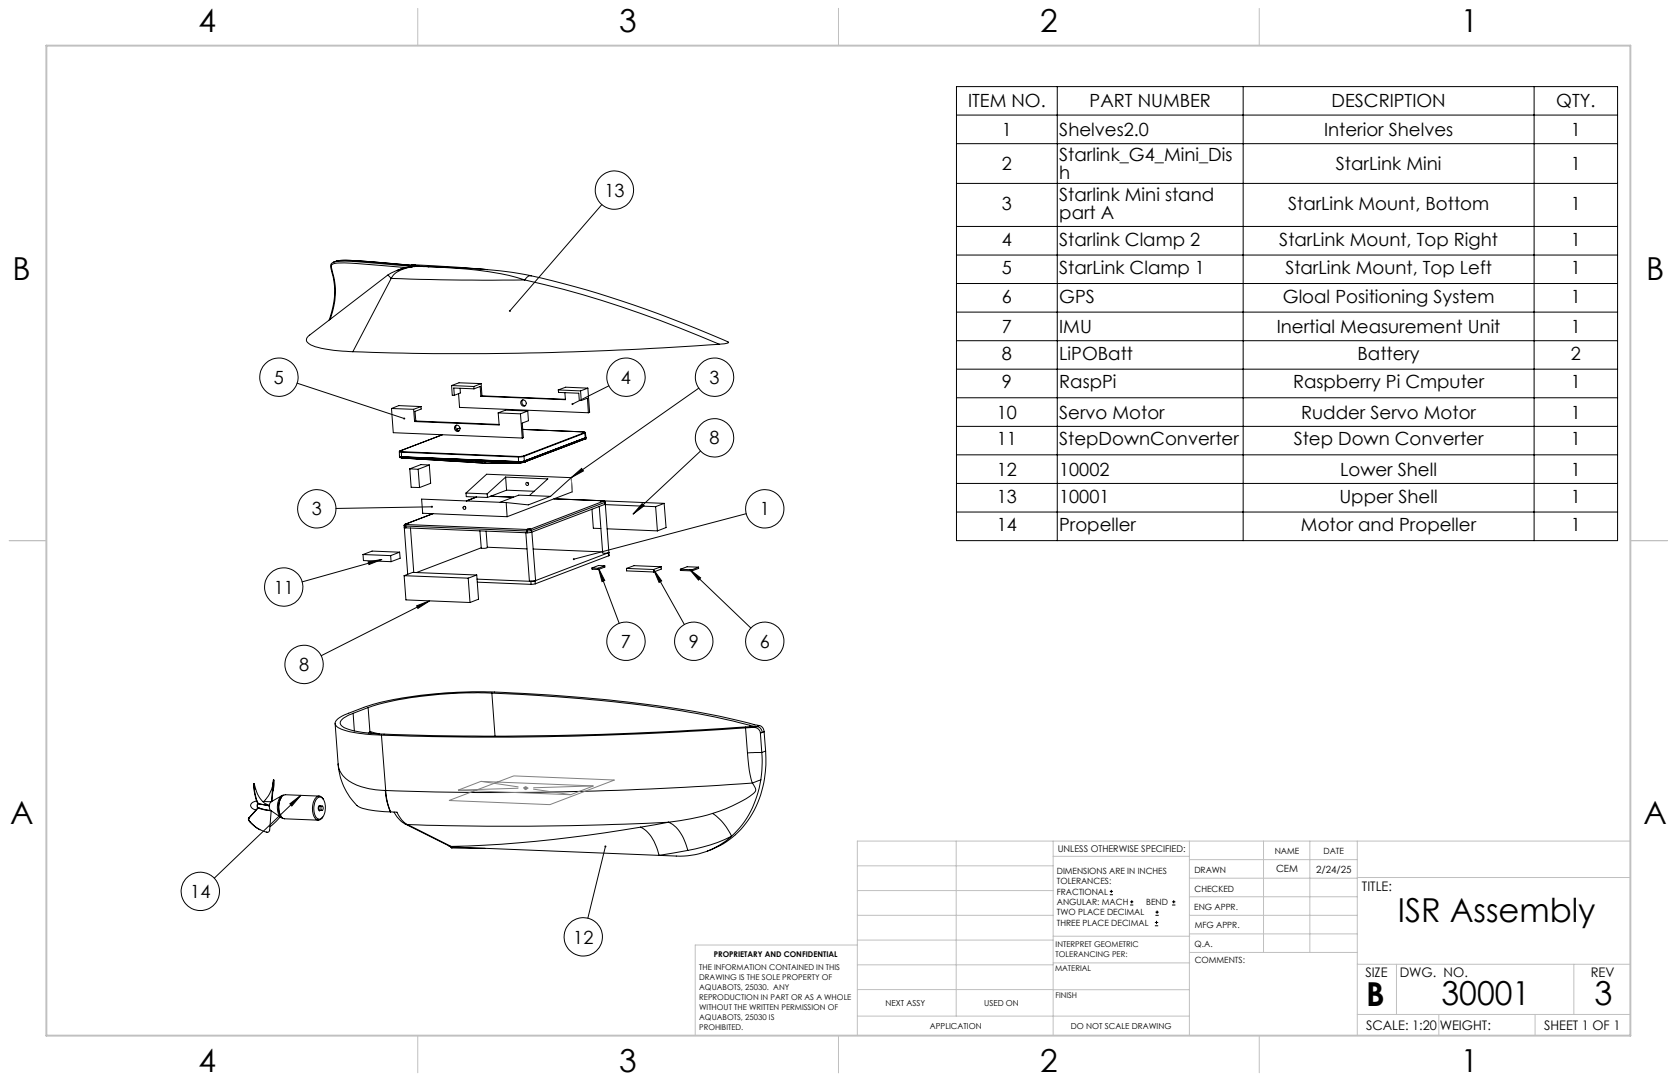
[picture p108: page 1]

ITEM NO. | PART NUMBER | DESCRIPTION | QTY.
1 | Shelves2.0 | Interior Shelves | 1
2 | Starlink_G4_Mini_Dis h | StarLink Mini | 1
3 | Starlink Mini stand part A | StarLink Mount, Bottom | 1
4 | Starlink Clamp 2 | StarLink Mount, Top Right | 1
5 | StarLink Clamp 1 | StarLink Mount, Top Left | 1
6 | GPS | Gloal Positioning System | 1
7 | IMU | Inertial Measurement Unit | 1
8 | LiPOBatt | Battery | 2
9 | RaspPi | Raspberry Pi Cmputer | 1
10 | Servo Motor | Rudder Servo Motor | 1
11 | StepDownConverter | Step Down Converter | 1
12 | 10002 | Lower Shell | 1
13 | 10001 | Upper Shell | 1
14 | Propeller | Motor and Propeller | 1

UNLESS OTHERWISE SPECIFIED: | | NAME | DATE
DIMENSIONS ARE IN INCHES TOLERANCES: FRACTIONAL ANGULAR: MACH BEND TWO PLACE DECIMAL THREE PLACE DECIMAL | DRAWN | CEM | 2/24/25

CHECKED | | | TITLE: ISR Assembly

ENG APPR.
MFG APPR.

INTERPRET GEOMETRIC TOLERANCING PER: | Q.A.
MATERIAL | | SIZE B | DWG. NO. 30001 | REV 3

PROPRIETARY AND CONFIDENTIAL
THE INFORMATION CONTAINED IN THIS
DRAWING IS THE SOLE PROPERTY OF
AQUABOTS, 25030. ANY
REPRODUCTION IN PART OR AS A WHOLE
WITHOUT THE WRITTEN PERMISSION OF
AQUABOTS, 25030 IS
PROHIBITED.

NEXT ASSY | USED ON | FINISH

APPLICATION | DO NOT SCALE DRAWING | | SCALE: 1:20 WEIGHT: | | SHEET 1 OF 1
