JRL000/AQUABOTS/PREVIOUS TEAM/Assemblies/ShelfAssemFinalDrawing.pdf

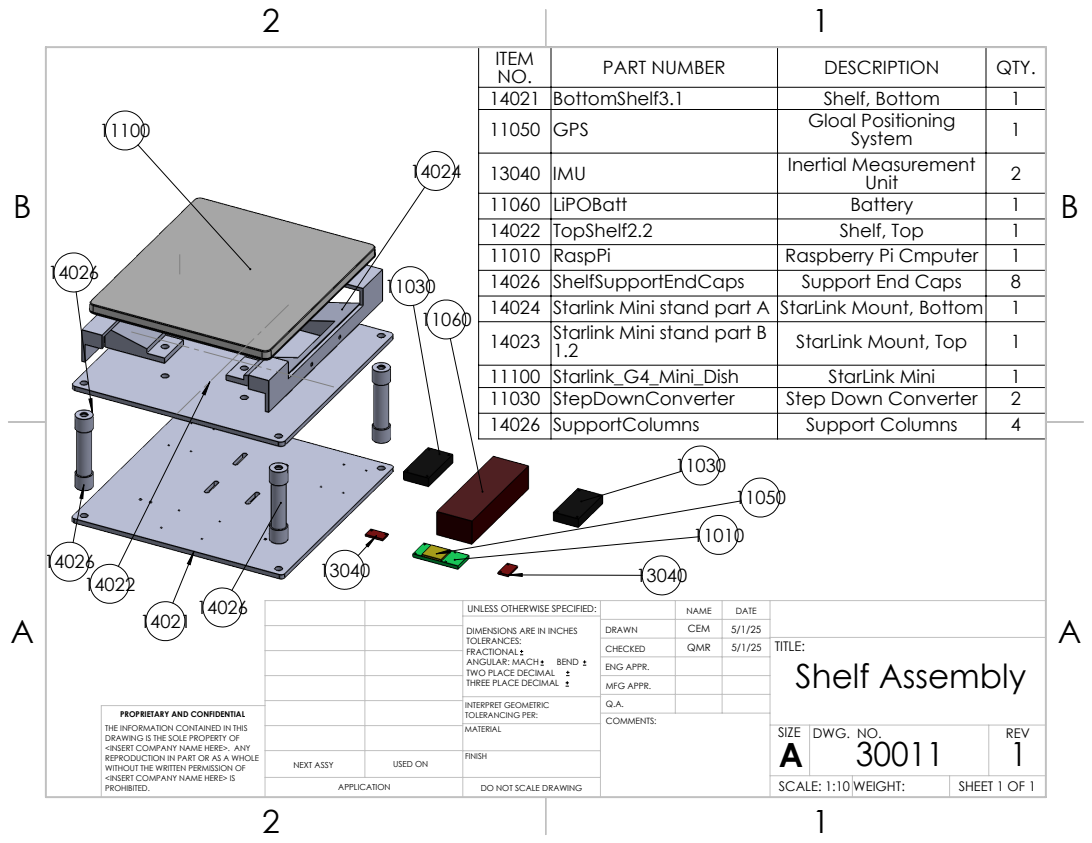
[picture p109: page 1]

ITEM NO. | PART NUMBER | DESCRIPTION | QTY.
14021 | BottomShelf3.1 | Shelf, Bottom | 1
11050 | GPS | Gloal Positioning System | 1
13040 | IMU | Inertial Measurement Unit | 2
11060 | LiPOBatt | Battery | 1
14022 | TopShelf2.2 | Shelf, Top | 1
11010 | RaspPi | Raspberry Pi Cmputer | 1
14026 | ShelfSupportEndCaps | Support End Caps | 8
14024 | Starlink Mini stand part A | StarLink Mount, Bottom | 1
14023 | Starlink Mini stand part B 1.2 | StarLink Mount, Top | 1
11100 | Starlink_G4_Mini_Dish | StarLink Mini | 1
11030 | StepDownConverter | Step Down Converter | 2
14026 | SupportColumns | Support Columns | 4

UNLESS OTHERWISE SPECIFIED: | | NAME | DATE
DIMENSIONS ARE IN INCHES TOLERANCES: FRACTIONAL ANGULAR: MACH BEND TWO PLACE DECIMAL THREE PLACE DECIMAL | DRAWN | CEM | 5/1/25

CHECKED | QMR | 5/1/25 | TITLE: Shelf Assembly

ENG APPR.
MFG APPR.

INTERPRET GEOMETRIC TOLERANCING PER: | Q.A.
MATERIAL | | SIZE A | DWG. NO. 30011 | REV 1

PROPRIETARY AND CONFIDENTIAL
THE INFORMATION CONTAINED IN THIS
DRAWING IS THE SOLE PROPERTY OF
<INSERT COMPANY NAME HERE>. ANY
REPRODUCTION IN PART OR AS A WHOLE
WITHOUT THE WRITTEN PERMISSION OF
<INSERT COMPANY NAME HERE> IS
PROHIBITED.

NEXT ASSY | USED ON | FINISH

APPLICATION | DO NOT SCALE DRAWING | | SCALE: 1:10 WEIGHT: | | SHEET 1 OF 1
