JRL000/AQUABOTS/reference/Raspberry_Pi_Code/StdAfx.h

// stdafx.h : include file for standard system include files,
//  or project specific include files that are used frequently, but
//      are changed infrequently
//

#if !defined(AFX_STDAFX_H__DE3D006B_A718_11D5_AD7A_00C04F185458__INCLUDED_)
#define AFX_STDAFX_H__DE3D006B_A718_11D5_AD7A_00C04F185458__INCLUDED_

#if _MSC_VER > 1000
#pragma once
#endif // _MSC_VER > 1000

#define VC_EXTRALEAN		// Exclude rarely-used stuff from Windows headers

//#include <afxwin.h>         // MFC core and standard components
//#include <afxext.h>         // MFC extensions
//#include <afxdisp.h>        // MFC Automation classes
//#include <afxdtctl.h>		// MFC support for Internet Explorer 4 Common Controls
//#ifndef _AFX_NO_AFXCMN_SUPPORT
//#include <afxcmn.h>			// MFC support for Windows Common Controls
//#endif // _AFX_NO_AFXCMN_SUPPORT

// Standard includes
#include <stdio.h>
#include <stdlib.h>
//#include <iostream.h>
//#include <fstream.h>
//#include <iomanip.h>
#include <string.h>
#include <math.h>
#include <time.h>
#include <ctype.h>
//#include "max.h"
#define _CRT_SECURE_NO_WARNINGS

//{{AFX_INSERT_LOCATION}}
// Microsoft Visual C++ will insert additional declarations immediately before the previous line.

#endif // !defined(AFX_STDAFX_H__DE3D006B_A718_11D5_AD7A_00C04F185458__INCLUDED_)
