JRL000/AQUABOTS/John/Firmware/swarmLogic/main/scheduler.c

/**
 * scheduler.c
 *
 * TDMA slot scheduling utilities.
 */

#include "scheduler.h"
#include "esp_log.h"

static const char *TAG = "SCHEDULER";

void scheduler_init(void)
{
    ESP_LOGI(TAG, "Stub: scheduler_init() - not implemented yet");
}

void scheduler_start(void)
{
    ESP_LOGI(TAG, "Stub: scheduler_start() - not implemented yet");
}
