JRL000/AQUABOTS/John/Firmware/Communications System/main/avoidance.c

/**
 * avoidance.c
 * Step 1: Stub implementation
 */

#include "avoidance.h"
#include "esp_log.h"

static const char *TAG = "AVOIDANCE";

void avoidance_init(void)
{
    ESP_LOGI(TAG, "Stub: avoidance_init() - not implemented yet");
}

void avoidance_start(void)
{
    ESP_LOGI(TAG, "Stub: avoidance_start() - not implemented yet");
}
