JRL000/AQUABOTS/John/Firmware/Communications System/main/avoidance.h

/**
 * avoidance.h
 * Step 1: Stub only. Will implement in later steps.
 */

#ifndef AVOIDANCE_H
#define AVOIDANCE_H

#include <stdint.h>

void avoidance_init(void);
void avoidance_start(void);

#endif // AVOIDANCE_H
