JRL000/AQUABOTS/John/Firmware/Communications System/main/formation.c

/**
 * formation.c
 * Step 1: Stub implementation
 */

#include "formation.h"
#include "esp_log.h"

static const char *TAG = "FORMATION";

void formation_init(void)
{
    ESP_LOGI(TAG, "Stub: formation_init() - not implemented yet");
}

void formation_start(void)
{
    ESP_LOGI(TAG, "Stub: formation_start() - not implemented yet");
}
