JRL000/AQUABOTS/John/Firmware/Communications System/main/formation.h

/**
 * formation.h
 * Step 1: Stub only. Will implement in later steps.
 */

#ifndef FORMATION_H
#define FORMATION_H

#include <stdint.h>

void formation_init(void);
void formation_start(void);

#endif // FORMATION_H
