JRL000/AQUABOTS/John/Firmware/Communications System/main/obstacle_sense.c

/**
 * obstacle_sense.c
 * Step 1: Stub implementation
 */

#include "obstacle_sense.h"
#include "esp_log.h"

static const char *TAG = "OBSTACLE_SENSE";

void obstacle_sense_init(void)
{
    ESP_LOGI(TAG, "Stub: obstacle_sense_init() - not implemented yet");
}

void obstacle_sense_start(void)
{
    ESP_LOGI(TAG, "Stub: obstacle_sense_start() - not implemented yet");
}
