JRL000/AQUABOTS/John/Firmware/Communications System/main/obstacle_sense.h

/**
 * obstacle_sense.h
 * Step 1: Stub only. Will implement in later steps.
 */

#ifndef OBSTACLE_SENSE_H
#define OBSTACLE_SENSE_H

#include <stdint.h>

void obstacle_sense_init(void);
void obstacle_sense_start(void);

#endif // OBSTACLE_SENSE_H
