JRL000/AQUABOTS/Raspberry_Pi_Code/Guidance.h

#pragma once

#ifndef GUIDANCE_H
#define GUIDANCE_H
#define _CRT_SECURE_NO_WARNINGS

void guidance_angle(double pos_cur[3], double vehicle_v[3], double p_target[3],double &Theta);

#endif //GUIDANCE_H
