JRL000/AQUABOTS/(commit log)

2025-05-07 Add Ground Station Files
2025-05-07 Add Raspberry Pi Files
2026-01-31 esp32 setup
2026-01-31 send / receive logic for esp32s. test 2
2026-02-26 Reorganize repo and add ground station integration layer
    Repo restructure:
    - firmware/ (was John/Firmware/swarmLogic/)
    - ground_station/ (was Mayra/gui/)
    - docs/ (was ProjectContextFiles/ + John/Pics/)
    - reference/ (was PREVIOUS TEAM/)
    - Removed all empty placeholder folders (AME, Alex, COMMUNICATIONS, Jamie,
    Kama, NAVIGATION, POWER, Robert, SENSORS, SOFTWARE) and all Desktop.ini /
    empty.txt placeholder files
    - Deleted step7/ backup and handoff doc artifacts
    - Renamed ground_station/Static/ -> static/ (case fix for Linux/Jetson)
    Ground station integration (IF-3, IF-4/IF-5):
    - config.py — centralized config; all IPs/ports/serial settings are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
2026-02-26 Add Mayra_original/ — unmodified copy of dashboard for review
2026-04-10 Repo restructure: add Jetson code, remove stale dirs, update docs
    - Add jetson/ with active code pulled from Jetson Orin Nano
    (app.py, webrtc_sender.py, signaling_server.py, pixhawk_test.py,
    telemetry_bridge.py, dashboard templates and static assets)
    - Remove ground_station/ (replaced by jetson/ with actual deployed code)
    - Remove Jamie/ (stale MicroPython GPS+Temp logger, GPS now on Pixhawk)
    - Add power system changelog (Rev WG-2), EMI filtering BOM, wiring docs
    - Fix firmware/.vscode/settings.json compile-commands path (was hardcoded
    to old AQUABOTS/John/Firmware/swarmLogic/build, now uses workspace var)
    - Fix firmware/main/README.md build path (swarmLogic -> firmware)
    - Update .giti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
2026-04-10 Add mavlink_router.py — Pixhawk serial to QGC UDP bridge
2026-04-11 Add mission control state machine, STATUSTEXT forwarding, systemd services
    app.py:
    - Mission upload protocol (CLEAR → COUNT → REQUEST handshake → ITEM_INT × N → RTL → ACK)
    - start_mission(): ARM + AUTO + MISSION_START command chain
    - Safety params written at startup: MOT_SLEWRATE=25, WP_SPEED=1.5 m/s
    - STATUSTEXT forwarding (STATUS + STATUS_SEV in telemetry broadcast)
    - CURRENT_WP tracking from MISSION_CURRENT messages
    - resume action: set_mode(AUTO) — resumes from current waypoint
    - abort action: disarm_vehicle()
    - Removed duplicate Flask app and duplicate control_handler (were dead code)
    static/js/controls.js (was empty — now full implementation):
    - 7-phase state machine: i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
2026-04-11 Fix camera pipeline: request valid 1920x1080 sensor mode, resize to 640x480 via nvvidconv
2026-04-11 Fix camera: replace cv2.VideoCapture with PyGObject GStreamer for JetPack 6.2 compatibility
2026-04-12 Add sensor_bridge firmware module (IF-3 ESP32 side); sync all docs to current state
    Firmware:
    - firmware/main/sensor_bridge.{h,c} — DS18B20 (1-Wire GPIO 4) + TDS (ADC1 CH0)
    + Atlas EZO pH (UART1) → stream `TEMP:%.2f,SAL:%.3f,PH:%.2f` to Jetson on
    UART2 @ 115200 every 3 s. Salinity math ported verbatim from Jamie's Arduino.
    Best-effort init — only Jetson UART is mandatory.
    - firmware/main/idf_component.yml — declares espressif/onewire_bus ^1.0.2 and
    espressif/ds18b20 ^0.1.3 managed-component deps.
    - main.c / CMakeLists.txt — wire sensor_bridge_init()/start() into boot order.
    Docs (all READMEs and reference docs updated to reflect 04-11-2026 state):
    - README.md (root) — mo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
2026-04-12 Docs: Rev FAR-1 power consolidation; strip ownership references
    Power architecture: ESP32 now on the 12V buck rail (alongside Jetson + fan);
    freed 5V buck feeds the Pixhawk POWER port, replacing the dedicated 5V
    Power Module. Result is four ATO branches instead of five and one fewer
    part in the BOM. Updated power changelog, Pixhawk/ESC wiring guide, and
    all READMEs to match. Also depersonalized docs — no more per-person
    ownership lines or references to individual team members' legacy code.
2026-04-12 Camera: pin nvarguscamerasrc to sensor-id=1; add push-to-jetson helper
    The IMX219 ribbon moved from CAM0 to CAM1. Without an explicit sensor-id
    argument, nvarguscamerasrc defaults to 0 and Argus fails with "Failed to
    create CaptureSession". Also add push-to-jetson.sh — a one-command helper
    that scp's a file to the Jetson and restarts the matching systemd user
    service (webrtc / aquabot-app / signaling / mavproxy / ui / all).
2026-04-13 Mission: gate AUTO on HOME_POSITION; verify mode before MISSION_START
    start_mission() used to fire arm -> sleep(1) -> set_mode AUTO -> sleep(0.3)
    -> MISSION_START blind. With ARMING_CHECK=0 the arm succeeds instantly, but
    ArduRover still rejects the AUTO transition until EKF origin/HOME are set
    (~10-20s after GPS lock) — leaving the rover armed in MANUAL with no
    throttle/servo output, while the GUI's "go" handler always replied "ok".
    - Track home_set via HOME_POSITION; start_mission waits up to 30s for it,
    nudges with GET_HOME_POSITION on entry for warm restarts.
    - Poll the heartbeat-driven mode global for up to 3s after set_mode("AUTO"),
    only fire MISSION_START once mode is actually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
2026-04-13 Add session notes: Jetson code-upload reference
2026-04-13 Sensor bridge end-to-end + slow mode + RTH-stuck fix
    - Bump espressif/ds18b20 to ^0.3.1; rename ds18b20_new_device to
    ds18b20_new_device_from_enumeration to match the new API.
    - Repoint Jetson UART to UART0 (GPIO 43/44) so it comes out the dev
    board's USB-UART bridge to /dev/ttyCH341USB0 on the Jetson.
    - When SENSOR_BRIDGE_JETSON_UART_NUM is UART0, skip uart_driver_install
    (NODE_CONFIG console owns it; collision caused an RTC_SW_CPU_RST reboot
    loop) and write CSV lines via fwrite(stdout) instead.
    Jetson app:
    - Add slow-mode toggle: PARAM_SET MOT_THR_MAX=30 (on) or 100 (off);
    reset to 100 on every Jetson restart so the cap doesn't persist
    silently. Action exposed over t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
2026-04-15 Camera: switch nvarguscamerasrc to sensor-id=0
    The Jetson's device tree declares only module0 (position=front,
    badge=jakku_front_RBP194) under tegra-camera-platform. sensor-id=1
    was selecting a nonexistent index; sensor-id=0 is the only valid
    choice for this carrier's overlay. Verified against dmesg post-reseat:
    imx219 9-0010 binds cleanly and /dev/video0 enumerates.
2026-04-15 Jetson: harden boot-time races so GUI loads on first try
    Four targeted fixes for the intermittent-startup symptom where the
    dashboard at :5000 sometimes requires multiple reboots before it's
    usable:
    webrtc_sender.py
    - Bound mav.wait_heartbeat() with a 5s timeout. The unbounded call could
    hang the whole module import if /dev/ttyACM0 opened but delivered no
    heartbeat, causing systemd to flap webrtc forever.
    - Retry websockets.connect() to the signaling server with 1→10s backoff.
    systemd After=signaling.service orders units but doesn't wait for the
    socket to be listening; without retry, webrtc exits immediately when
    it wins the race.
    - Check Gst.set_state() return; raise on FAILURE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
2026-04-15 Sessions: document 2026-04-14 boot-race + dual-cam work
    Captures what shipped today (branch auto-nav-test), what the Jetson
    state is at session end, the known-unknown around the post-flash boot
    hang, and a verification/rollback cheat sheet for the next session.
2026-04-15 Track notes/ folder so memory + session notes sync across PCs
    - Remove notes/ from .gitignore
    - Add initial snapshot: MEMORY.md index, three memory entries
    (camera clamp, DT overlay, systemd layout), and today's session
    notes
    - README explains how to rehydrate the live memory dir from these
    files on a fresh PC
2026-04-15 Camera: name the working port (CAM1_SENSOR_ID) and fix deploy alias
    jetson/webrtc_sender.py: extract sensor-id into a named constant with a
    comment clarifying that physical carrier port CAM1 (the port with the
    working clamp) maps to argus sensor-id=0 under the dual-IMX219 device-tree
    overlay. Silkscreen labels do not match argus sensor-ids.
    push-to-jetson.sh: use the 'jetson' SSH config alias instead of the raw
    mayra@100.76.1.26 host so the script works on any PC that has the alias
    configured (Tailscale IP + key loading is otherwise machine-specific).
2026-04-22 Jetson GUI expansion + repo hygiene
    - Add manual, mission-planning, recording, safety, and telemetry tabs
    (jetson/static/js/*, css/style.css, templates/index.html, app.py)
    - Fix webrtc.js regression
    - Add jetson/tools/ (mock_server, ws_peek) for offline GUI dev
    - Sync notes/project-docs/ and notes/session-logs/ for cross-PC handoff
    - Add .gitattributes (text=auto eol=lf) to stop CRLF/LF churn
    - Gitignore ssh.txt and jetson-ssh-setup.txt (internal infra notes)
2026-04-23 systemd: admin-password env file + monthly log cleanup
    aquabot-app.service: read AQUABOT_ADMIN_PW from ~/.config/aquabot.env
    (keeps the password out of git — create the file on the Jetson with
    chmod 600). Leading `-` on EnvironmentFile so the unit still starts
    if the file is missing; admin features stay disabled in that case.
    aquabot-cleanup.{service,timer}: monthly oneshot that deletes
    blackbox_*.jsonl and telemetry_*.csv older than 30 days under
    /home/mayra/videos. Fires 03:00 on the 1st; Persistent=true so a
    powered-off Jetson catches up on next boot.
    One-time setup on the Jetson once it's online:
    echo 'AQUABOT_ADMIN_PW=...' > ~/.config/aquabot.env && chmod 600 ~/.config/aquabot.env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
2026-04-26 docs: add field procedures for 2026-04-23 EMI install
    - EMI_FILTERING_INSTALL_CHECKLIST.{md,pdf}: FAR-1-patched install checklist.
    Realigned ESP32 supply section to 12V buck rail (P9 input / P20 output);
    added new Pixhawk POWER section (F2 on P11 + C5b 47uF/10V+ + C2 at DF13);
    fixed C4 voltage rating to 25V+ (ESP32 VIN is 12V post-FAR-1); downgraded
    pH F5 beads to pool-test-gated (pH is UART not I2C per sensor_bridge.c).
    Kept verification sections V1-V6, prereqs, and continuity checks.
    - DOC_UPDATES_20260422.pdf: session doc-updates captured from today.
    - STEERING_TROUBLESHOOT_AND_SERVO_SWAP.pdf: servo-swap field procedure
    for tomorrow's production DSServo install.
2026-04-26 docs: add stubs where stale PDFs used to live
    Stubs point readers at the current canonical markdown. Disk-side stale PDFs
    have been renamed to _STALE_*.pdf (untracked via .git/info/exclude) since
    the repo's mount doesn't permit unlink; user can remove them on Windows
    side at leisure.
    - docs/Updated AQUABOTS WIRING GUIDE.md -> notes/project-docs/AQUABOTS_WIRING_GUIDE.md (WG-3/FAR-1)
    - notes/project-docs/AQUABOTS POWER SYSTEM CHANGELOG.md -> AQUABOTS_POWER_SYSTEM_CHANGELOG.md (FAR-1)
    No stub for the WG-2 changelog PDF (straight delete per request — rev-specific filename, superseded).
2026-04-26 Swarm formation: end-to-end Pixhawk handoff via Jetson coordinator
    Wires the existing ESP32 swarm framework to a real autopilot so that an
    assigned formation slot actually becomes a boat motion command.
    ESP32 side
    - swarm_bridge.{h,c}: tag-prefixed line protocol over the existing Jetson
    UART (SWARM_ROLE / SWARM_TARGET / SWARM_LEADER_GPS / SWARM_FORMATION /
    SWARM_STOP outbound, ANCHOR_GPS / SET_FORMATION / SWARM_ENABLE inbound).
    - New MSG_TYPE_GPS_ANCHOR over ESP-NOW so the leader's GPS reaches all
    followers as the formation center.
    - main.c hooks the existing leader/formation/command callbacks to push
    status to the Jetson.
    - A02YYUW ultrasonic driver activated.
    Jetson side
    - swarm_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
2026-04-26 Dashboard redesign + nav telemetry + Mapbox + mock improvements
    UI: slim 48px header (was 120px banner); status HUD strip with
    Mode/Speed/GPS/Battery/Pre-arm pills above the map; bottom row
    regrouped into 4 task cards (Operate / Mission / Plan / Camera)
    with semantic button colors (green=go, yellow=caution, red=stop,
    gray=configure). Pre-arm checklist collapsed into a READY badge.
    Sensor overlays became chip toggles. Lat/lon clamped to 6 decimals.
    Telemetry tab: new Navigation card from NAV_CONTROLLER_OUTPUT
    (distance, target bearing, heading error w/ arrow, desired course,
    cross-track), Attitude card (roll/pitch from ATTITUDE), Actuators
    card with steering/throttle deflection percentage ab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
2026-05-03 docs: add follower drone reference + WG-3 wiring diagrams
    - notes/project-docs/FollowerDroneCode.txt: Jamie's reference Arduino
    sketch for a Jetsonless follower hull (single ESP32 driving its own
    Pixhawk via MAVLink GUIDED). Used as the spec for the new firmware
    pixhawk_link module.
    - docs/pics/WD-3.png + docs/wiring/: wiring diagram set in PNG, SVG, and
    QElectroTech source.
2026-05-03 firmware: pixhawk_link module + sensor logging on Jetsonless followers
    Closes the loop on the swarm follower path. Before this, the ESP32 stack
    computed where each follower should go but had no path to actually drive
    the Pixhawk on a Jetsonless hull. Now demo follower hulls (ESP32 +
    Pixhawk only) self-execute formation assignments end-to-end.
    New module: pixhawk_link
    - Talks to a directly attached Pixhawk over UART2 (TX=GPIO38, RX=GPIO39,
    57600 baud, MAVLink2). Pinned to free pins so the existing pH UART
    and ultrasonic sensor on UART1/GPIO16-17 are not disturbed.
    - Subscribes to ESP-NOW MSG_TYPE_GPS_ANCHOR (transport already supports
    multi-callback fan-out) to track the leader's GPS a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
2026-05-04 firmware: pixhawk_link UART thread-safety fix + cleaner console init
    Two issues caught in code audit before flashing.
    1. UART write race (real bug)
    uart_write_bytes is documented as not thread-safe. The TX task and
    pixhawk_link_emergency_stop (which runs on the radio receive
    callback chain) could both call it concurrently and interleave
    bytes mid-MAVLink-frame, producing garbage on the wire to the
    Pixhawk. Added a FreeRTOS mutex around uart_send so MAVLink frames
    stay atomic regardless of caller context.
    2. Console command struct initializers (warning)
    Used positional initializers on esp_console_cmd_t, which has 5
    fields (command, help, hint, func, argtable). The tr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
2026-10-19 Remove tooling notes folder and references
    Move project docs from notes/project-docs into docs/, replacing the
    redirect stubs there, and move NEXT_STEPS.md to docs/ and gst_test.py to
    jetson/. Delete the rest of the folder (memory snapshots, session logs,
    prompts, stubs, duplicates), and update the README, .gitignore and docs
    references to match.
